Architeuthis-Flux/JumperlessV5/Jumperless23V50/README.md

# Jumperless V5
 The next generation [jumperless breadboard](https://github.com/Architeuthis-Flux/Jumperless)

More LEDs, fewer jumpers!

Here in this folder there *should* be every bit of hardware that goes into this thing. If something's missing, just ask.

Anyway here's a render of each of the parts you'll find in these folders:
hero copy
JumperlessV5r6
Jumperless23V50back

newShell-3
newShell-5
Screenshot 2024-11-18 at 8 08 38 AM
V5LEDboardback

V5LEDboard
V5probe
V5ProbeTop
V5ProbeTopback
gpioAdapter-10
gpioAdapter-12
clickWheelCap-9

Screenshot 2024-11-16 at 7 25 29 PM

ProbeSenseNumbers
ProbeSenseNumbersback

Here's a list of the new stuff being added to V5:
- a separate probe sensing system  (so rows can be selected without disconnecting and scanning the whole board)
- 5 LEDs under each row  (so the breadboard itself can display measurements, text, video, whatever)
- a rotary encoder/button  (so you can navigate menus without looking at a computer)
- 10 GPIO (4 5V, 6 3.3V) that can be routed anywhere  (so you can talk to chips on the breadboard, or logic analyze them)
- a daisy chain header on both sides  (so you can stick a bunch of these together and route 8 fully analog signals between boards)
- a TRRRS audio jack for the probe  (so you can select rows, measure voltage and add an I2C display)
- 2 arbitrarily programmable power rails  (so you can set each one separately to any voltage within +-8V)
- 2 more routable high-current DACs, 3 +- 8V buffered ADCs, a routable op amp buffer (so you're not losing any features of the original Jumperless)
- a USB-C port  (so you can shut the fuck up about my love for USB Mini)

https://github.com/Architeuthis-Flux/JumperlessV5/assets/20519442/e1003ef1-e145-4110-8218-d5403845bdf6

https://github.com/Architeuthis-Flux/JumperlessV5/assets/20519442/8845355e-0e21-4cbd-b4f0-f0b5bd2063a3

https://github.com/Architeuthis-Flux/JumperlessV5/assets/20519442/c6f371e6-8d97-4a70-bf3b-5532be4f0662

https://github.com/Architeuthis-Flux/JumperlessV5/assets/20519442/ceb898b4-bbbe-4788-ab80-29add00364f6

https://github.com/Architeuthis-Flux/JumperlessV5/assets/20519442/f67fb13e-432d-4cfa-b7df-fb754a4e1074

JumperlessV5hw
V5r2Schematic
V5r2LEDsSchematic
