Architeuthis-Flux/JumperlessV5/README1.md

# Jumperless V5
###### The next generation jumperless breadboard

Jumperless V5 is a breaboard where any point can be connected to any other with software-defined jumpers. RGB LEDs under each hole turn the breadboard itself into a display; paired with its assortment of routable analog/digial IO, Jumperless V5 gives you real-time information about everything that's happening in your circuit and the ability to change it at a whim.

JumperlessV5front

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

JumperlessV5back

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

Jumperless V5 will cost roughly $350 (with free shipping worldwide)

## For People Who Like Reading
You're flipping through a comic book and see an ad in the back for some X ray glasses. You put some coins in an envelope and send it off (because it's like 50 years ago in this made up scenario) and get back some spectacles. You immediately look up at the night sky towards the galactic center for Sagittarius A* and don't see a thing; you've been had. You go back to prototyping your new Eurorack module (because that's what I assume everyone was doing in the early 80's) and forget to take them off. 

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

Breadboards should be a playground, and now you can attach a debug probe to them.

https://github.com/Architeuthis-Flux/JumperlessV5/assets/20519442/a3d5ecf4-4665-409d-bab6-2a62fbbe0eb7

Now you have a breadboard with:

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

```
f {ADC1-10, 15-48, TOP_RAIL-17, TOP_RAIL>6.5V, D0-UART_Rx, D1-UART_Tx, }
```
⬆︎ *that's it, that's everything you need to send it to make things happen*

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


###### Just pretend this has an audio cable stuck to the back and it's sitting on a V5

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

lossm-5

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

lossm

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

###### If this campaign does well enough, the next project will be making a general purpose crossbar switch out of beefy MOSFETs and [floating gate](https://en.wikipedia.org/wiki/Floating-gate_MOSFET) drivers to get the voltage limits into the ±50V range and the Ron down to ~1Ω, but custom high-current silicon is a huge, expensive undertaking (that I am 100% committed to doing)

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

JumperlessV5boardoff

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

## Open Sourciness
This thing infinitely open source and hackable. I'm kind of a zealot about that stuff. Want to make 10 of these with a USB Mini port for you and your friends? Let me know and I'll double check everything when you're putting in the PCB order to make sure all the parts are placed correctly and stuff (and I'd totally buy one, I love USB Mini). I'll even send you the custom spring clips.

If you have some feature you want to add, I'm happy to help. Either by just adding it myself or walking you through the relevant bits of code to make it happen.
JumperlessV5hw
