Architeuthis-Flux/JumperlessV5/Jumperless23V50/Board Shell/newShell-1.jpg

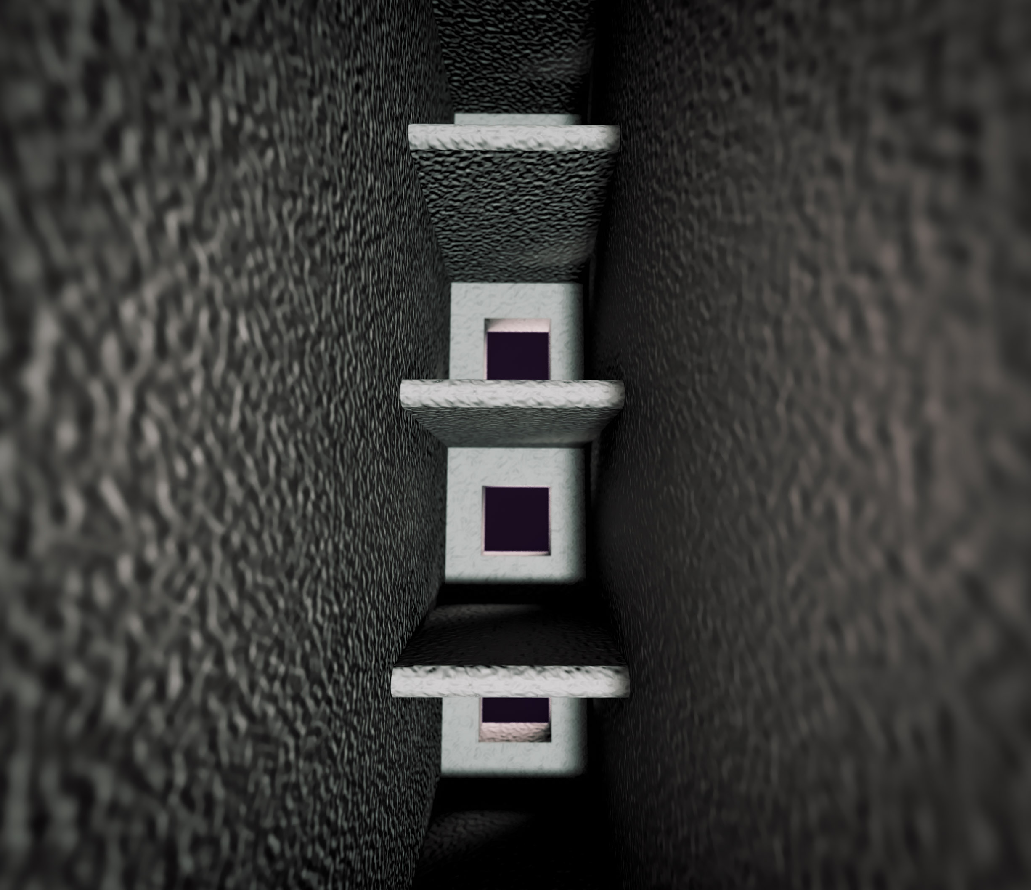
Jumperless23V50/Board Shell/newShell-1.jpg
