Architeuthis-Flux/JumperlessV5/Jumperless23V50/Board Shell/newShell-5.jpg

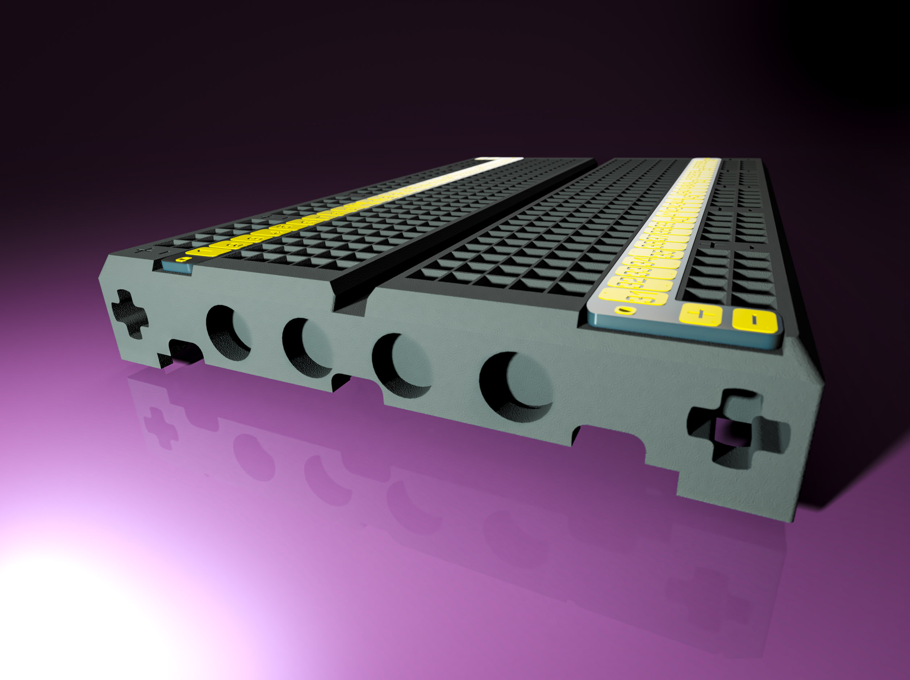
Jumperless23V50/Board Shell/newShell-5.jpg
