Architeuthis-Flux/JumperlessV5/Jumperless23V50/Clickwheel Cap/clickWheelCap-0.jpg

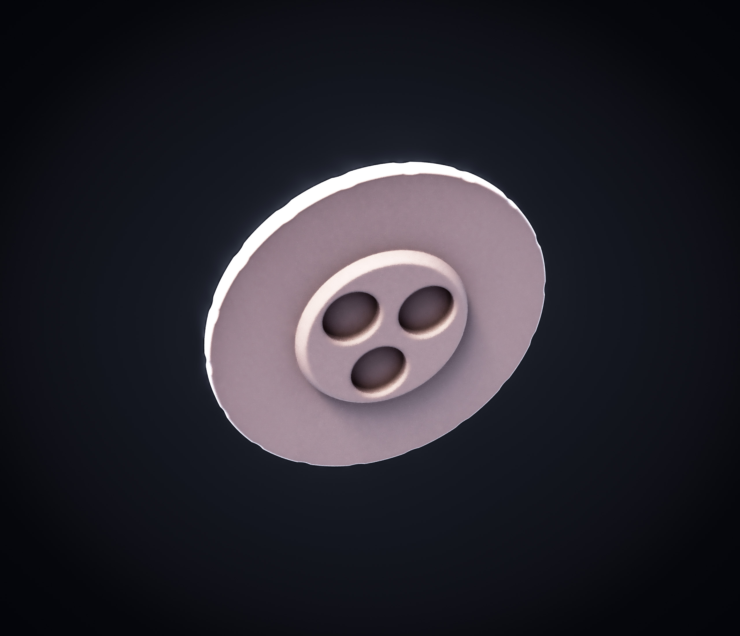
Jumperless23V50/Clickwheel Cap/clickWheelCap-0.jpg
