Architeuthis-Flux/JumperlessV5/Jumperless23V50/Clickwheel Cap/clickWheelCap-6.jpg

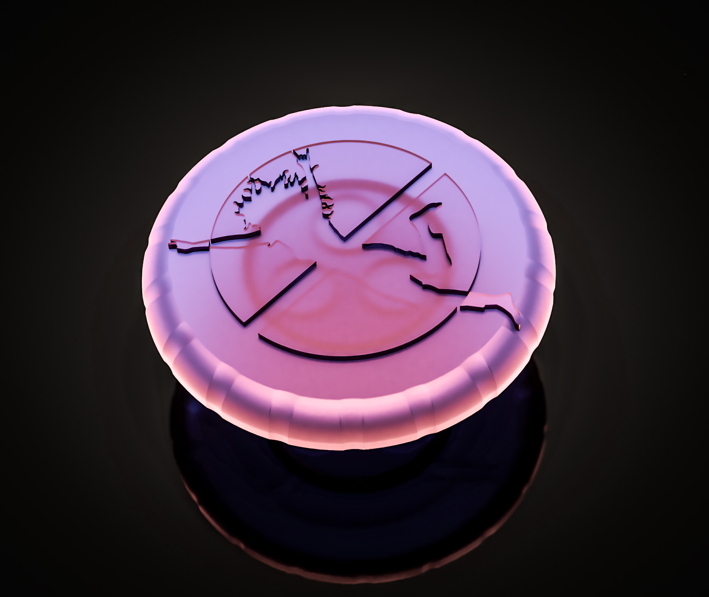
Jumperless23V50/Clickwheel Cap/clickWheelCap-6.jpg
