Architeuthis-Flux/JumperlessV5/Jumperless23V50/Clickwheel Cap/WJPlickwheelCaps-14.jpg

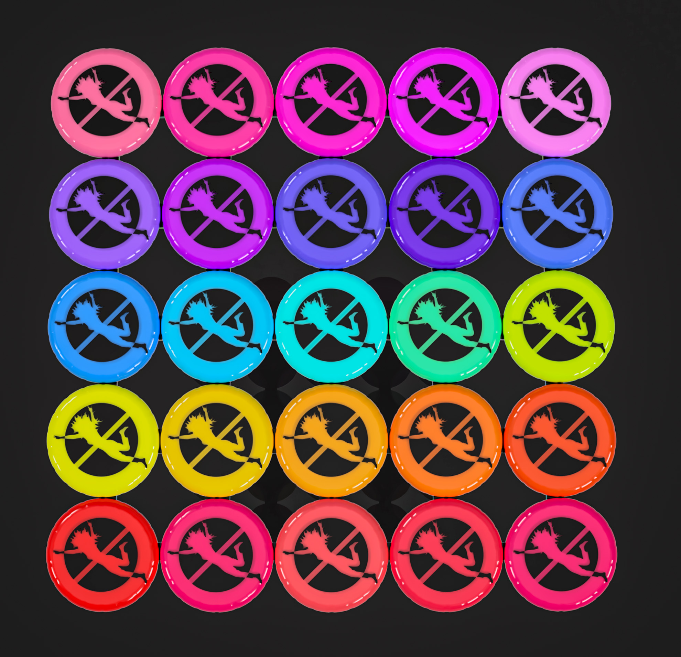
Jumperless23V50/Clickwheel Cap/WJPlickwheelCaps-14.jpg
