Architeuthis-Flux/JumperlessV5/Jumperless23V50/Clickwheel Cap/WJPlickwheelCaps-17.jpg

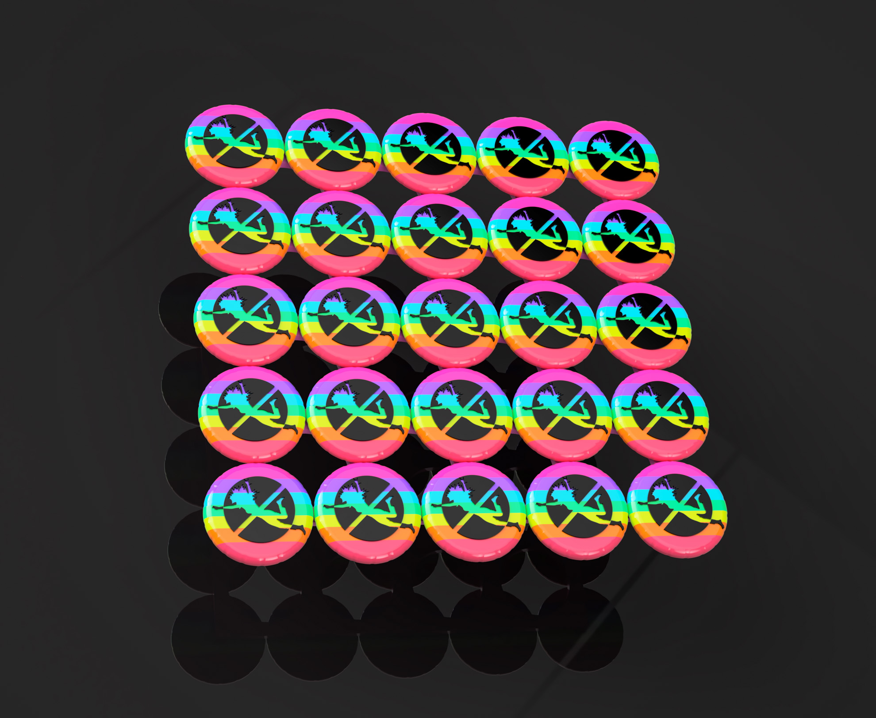
Jumperless23V50/Clickwheel Cap/WJPlickwheelCaps-17.jpg
