Architeuthis-Flux/JumperlessV5/Jumperless23V50/Images/Breadboard Shell/BreadboardShellRender1.png

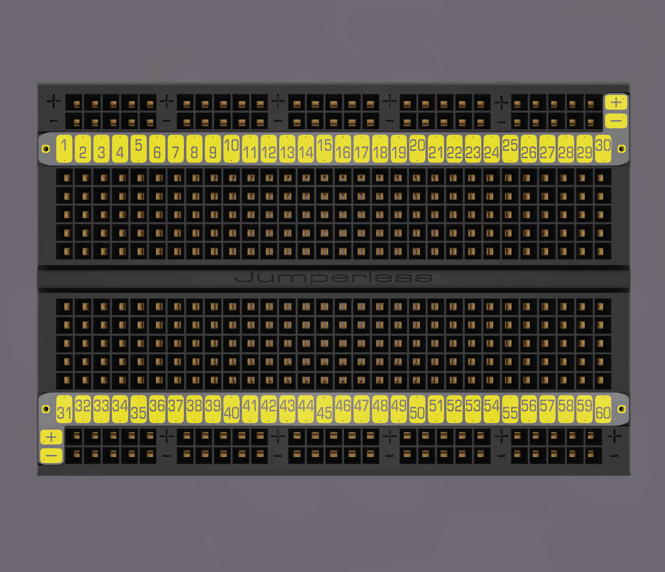
Jumperless23V50/Images/Breadboard Shell/BreadboardShellRender1.png
