Architeuthis-Flux/JumperlessV5/Jumperless23V50/Images/Breadboard Shell/BreadboardShellRender2.png

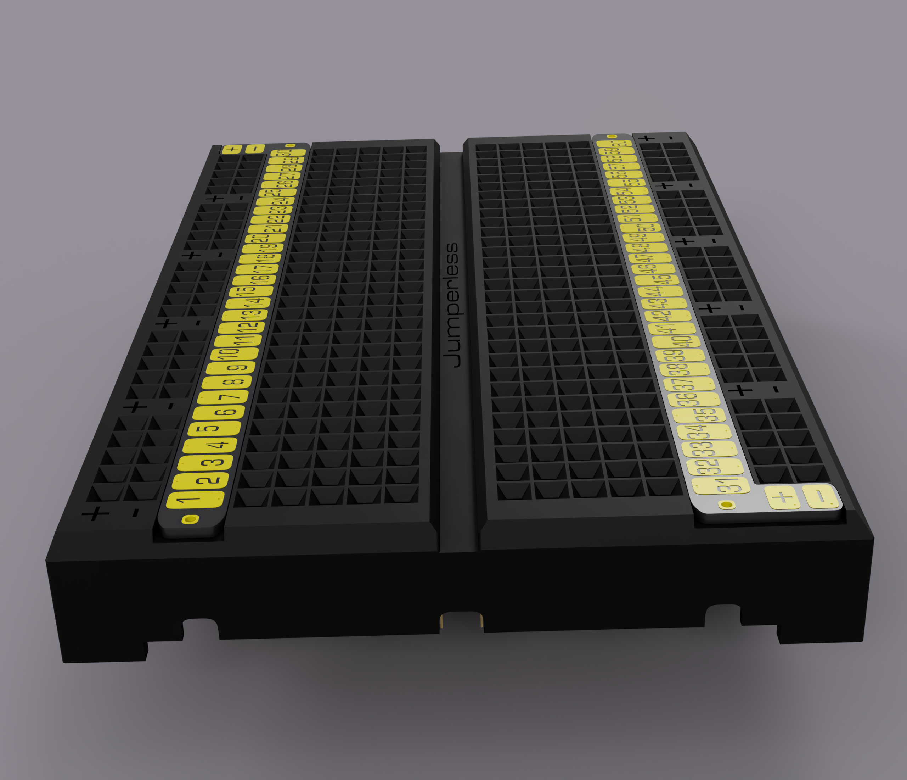
Jumperless23V50/Images/Breadboard Shell/BreadboardShellRender2.png
