Architeuthis-Flux/JumperlessV5/Jumperless23V50/Images/Breadboard Shell/BreadboardShellRender3.png

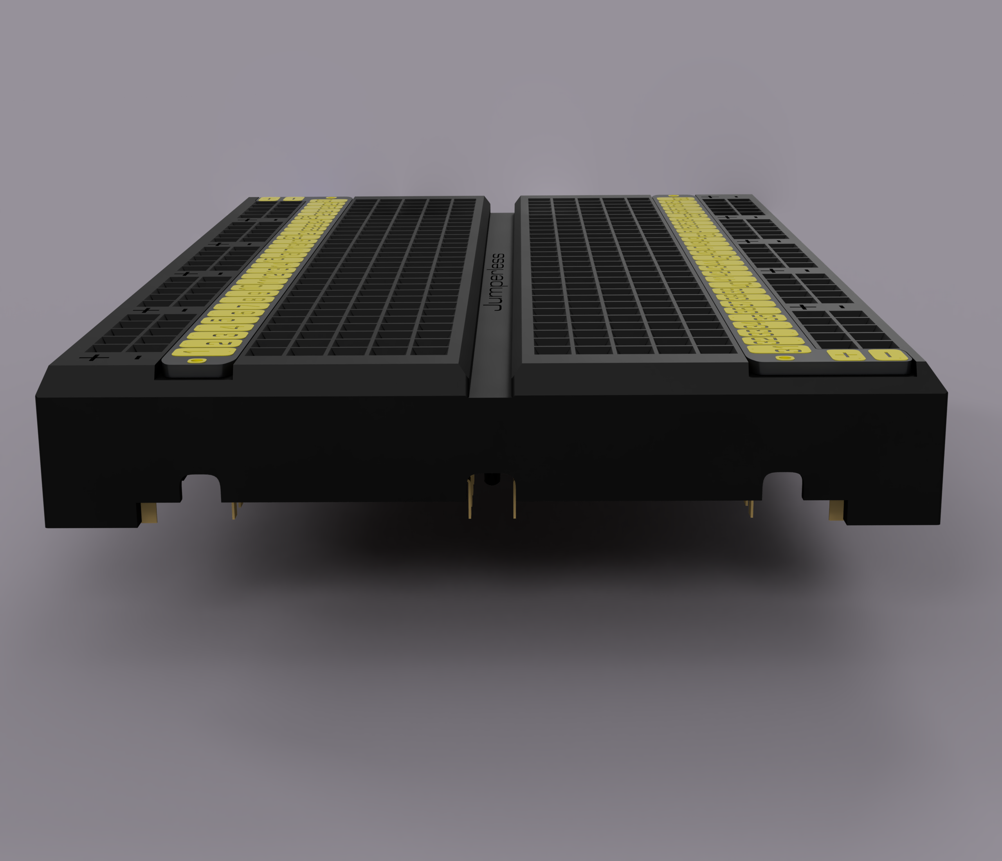
Jumperless23V50/Images/Breadboard Shell/BreadboardShellRender3.png
