Architeuthis-Flux/JumperlessV5/Jumperless23V50/Images/Breadboard Shell/BreadboardShellRender5.png

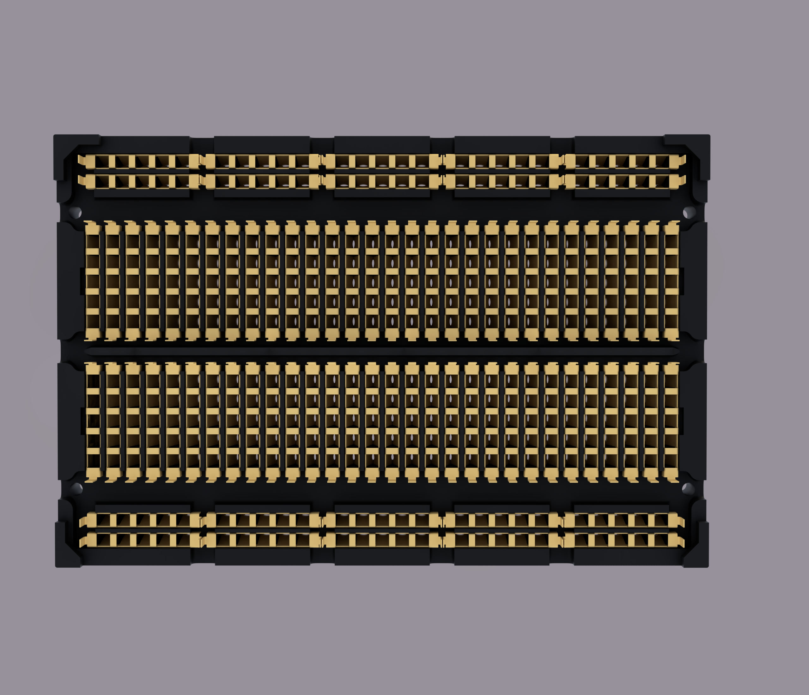
Jumperless23V50/Images/Breadboard Shell/BreadboardShellRender5.png
