Architeuthis-Flux/JumperlessV5/Jumperless23V50/Images/Breadboard Shell/BreadboardShellRender8.png

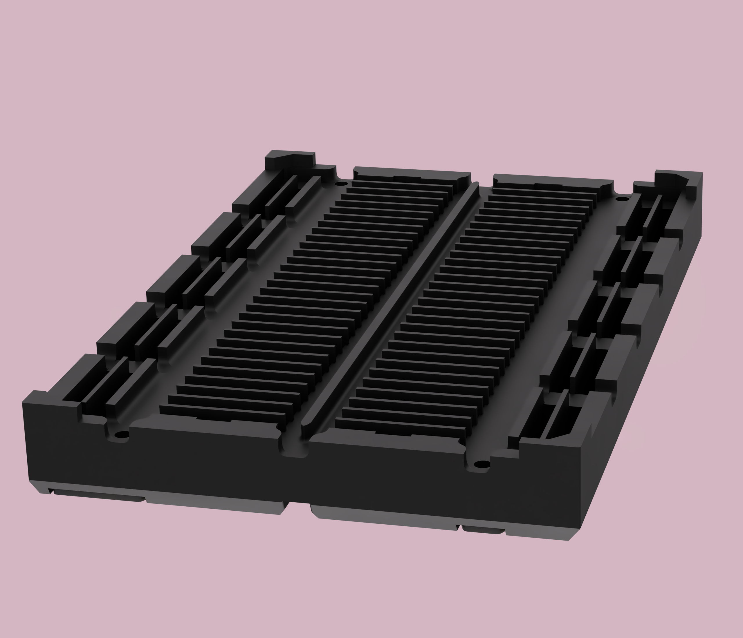
Jumperless23V50/Images/Breadboard Shell/BreadboardShellRender8.png
