Architeuthis-Flux/JumperlessV5/Jumperless23V50/Images/JumperlessV5hw.png

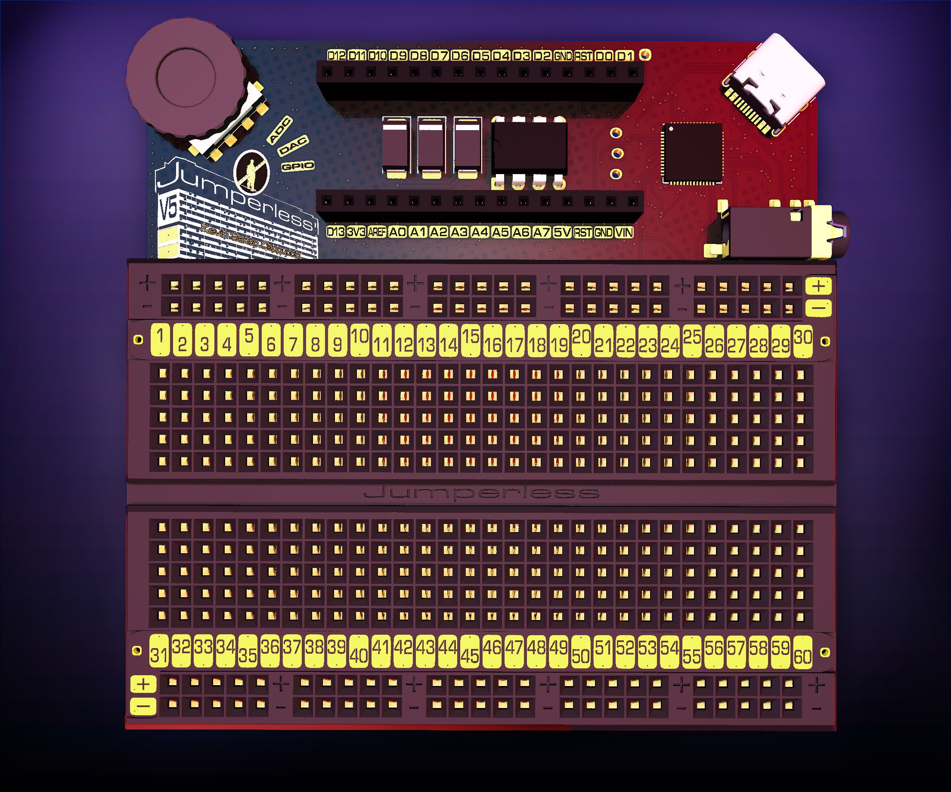
Jumperless23V50/Images/JumperlessV5hw.png
