Architeuthis-Flux/JumperlessV5/Jumperless23V50/Images/Probe Sense Numbers/ProbeSenseNumberBack.png

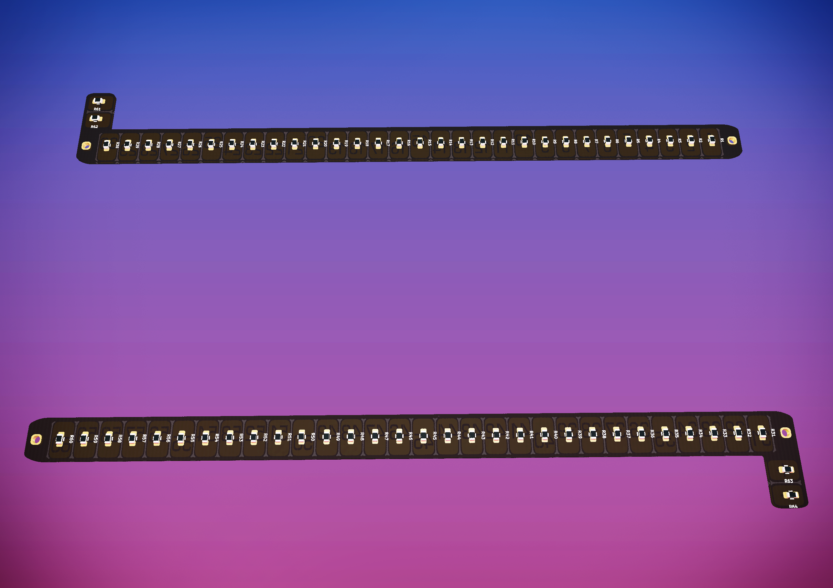
Jumperless23V50/Images/Probe Sense Numbers/ProbeSenseNumberBack.png
