Architeuthis-Flux/JumperlessV5/Jumperless23V50/Images/Probe Sense Numbers/ProbeSenseNumberBackedge.png

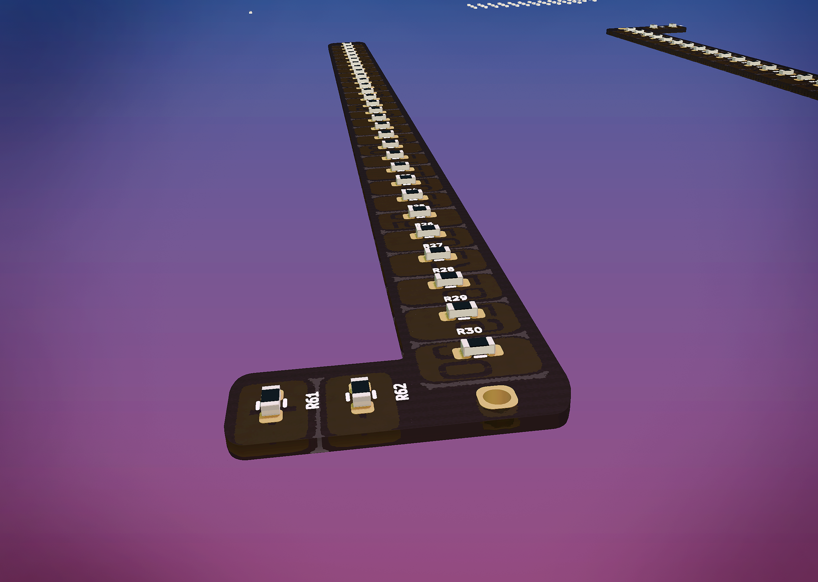
Jumperless23V50/Images/Probe Sense Numbers/ProbeSenseNumberBackedge.png
