Architeuthis-Flux/JumperlessV5/Jumperless23V50/Images/Probe Sense Numbers/ProbeSenseNumbers.png

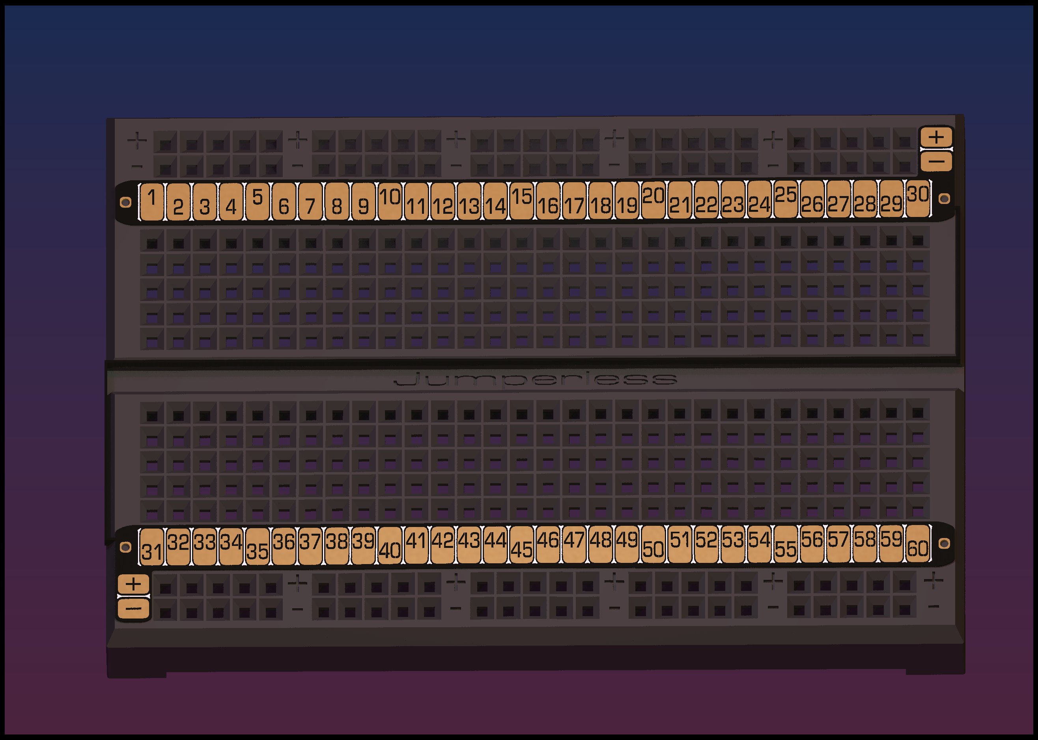
Jumperless23V50/Images/Probe Sense Numbers/ProbeSenseNumbers.png
