Architeuthis-Flux/JumperlessV5/Jumperless23V50/Images/Probe Sense Numbers/ProbeSenseNumbersEnds.png

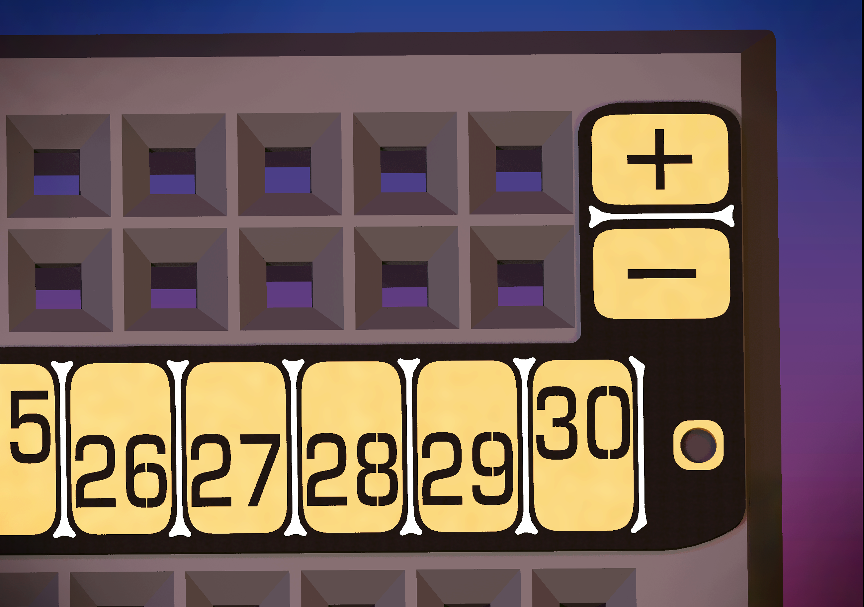
Jumperless23V50/Images/Probe Sense Numbers/ProbeSenseNumbersEnds.png
