Architeuthis-Flux/JumperlessV5/Jumperless23V50/Images/Probe Sense Numbers/ProbeSenseNumberspers.png

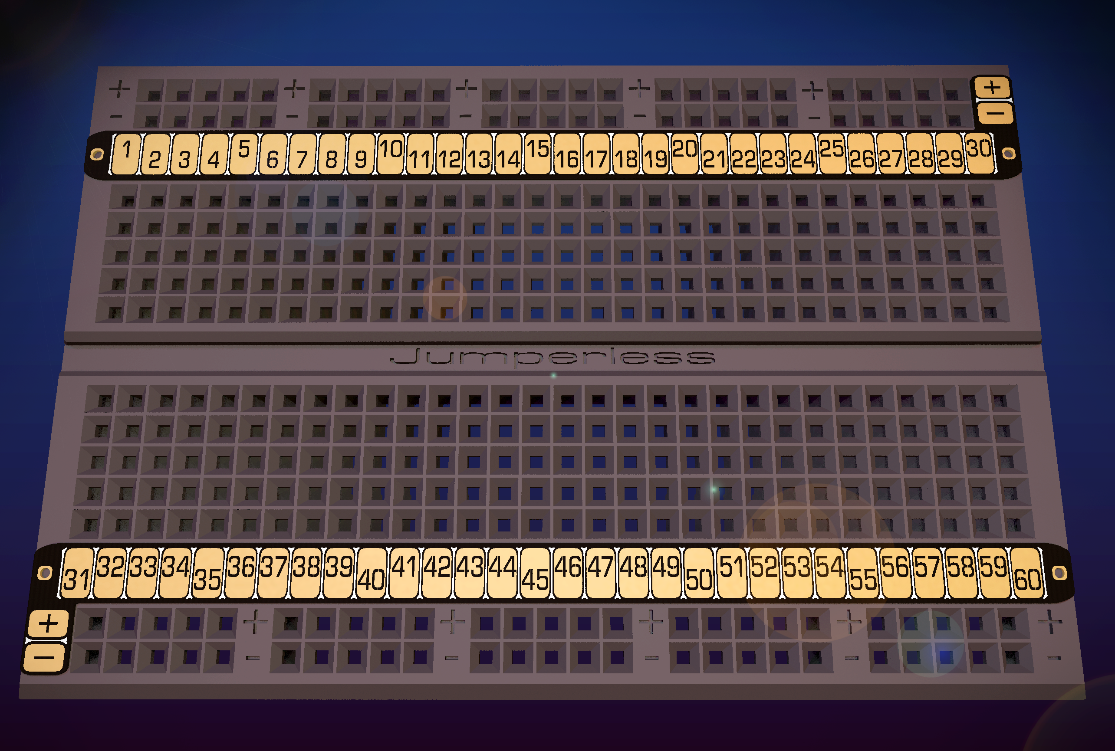
Jumperless23V50/Images/Probe Sense Numbers/ProbeSenseNumberspers.png
