Architeuthis-Flux/JumperlessV5/Jumperless23V50/Packaging/All.jpg

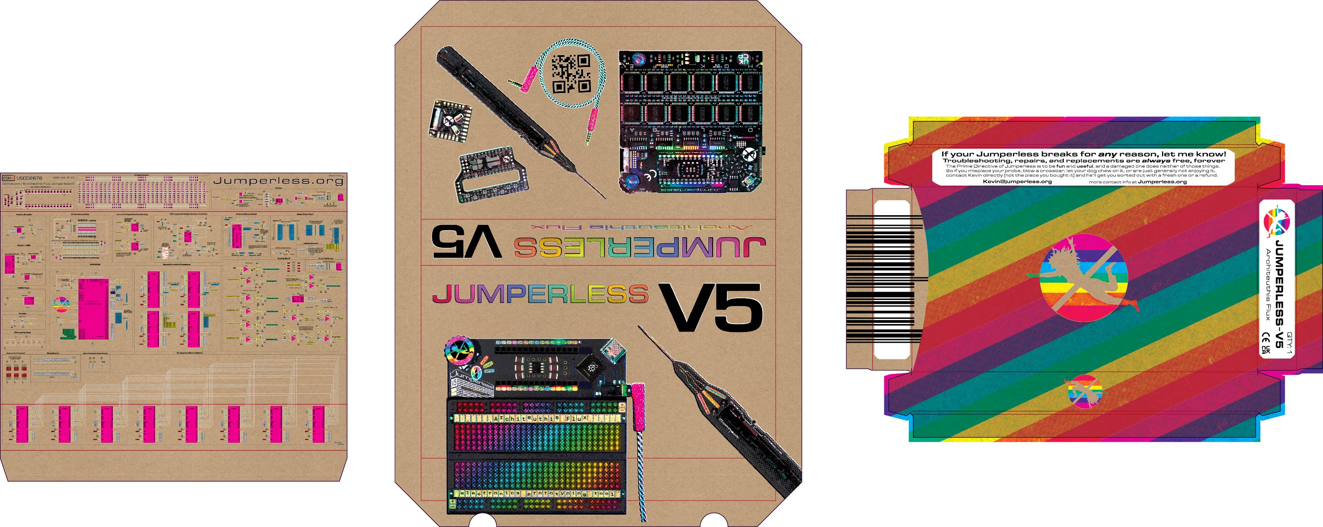
Jumperless23V50/Packaging/All.jpg
