Architeuthis-Flux/JumperlessV5/Jumperless23V50/Packaging/FrontBack.jpg

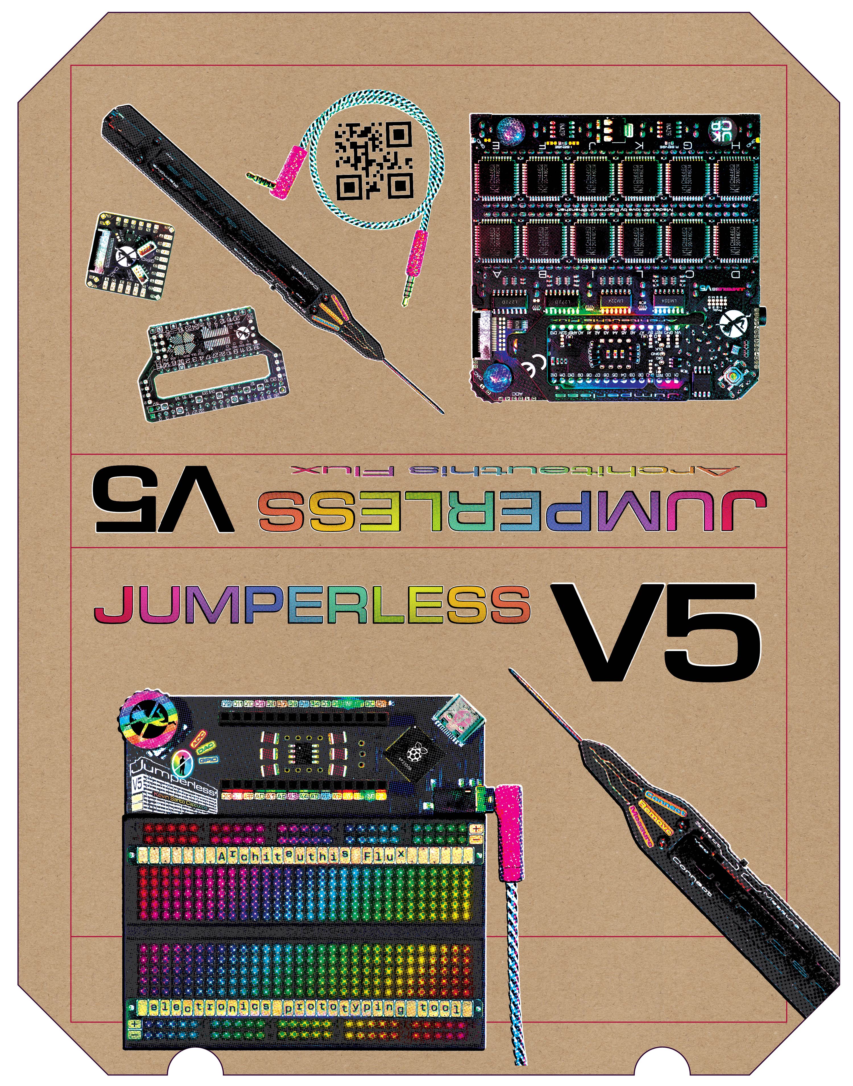
Jumperless23V50/Packaging/FrontBack.jpg
