Architeuthis-Flux/JumperlessV5/Jumperless23V50/Packaging/InsideFlap.jpg

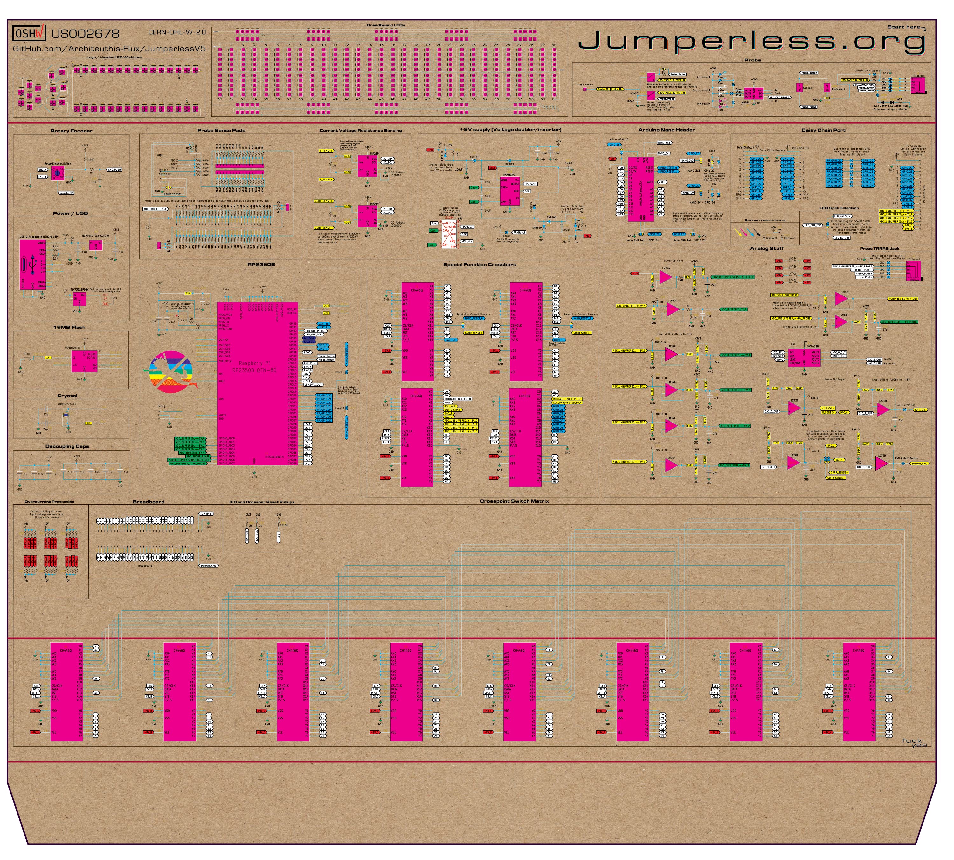
Jumperless23V50/Packaging/InsideFlap.jpg
