Architeuthis-Flux/JumperlessV5/Jumperless23V50/Packaging/Sides.jpg

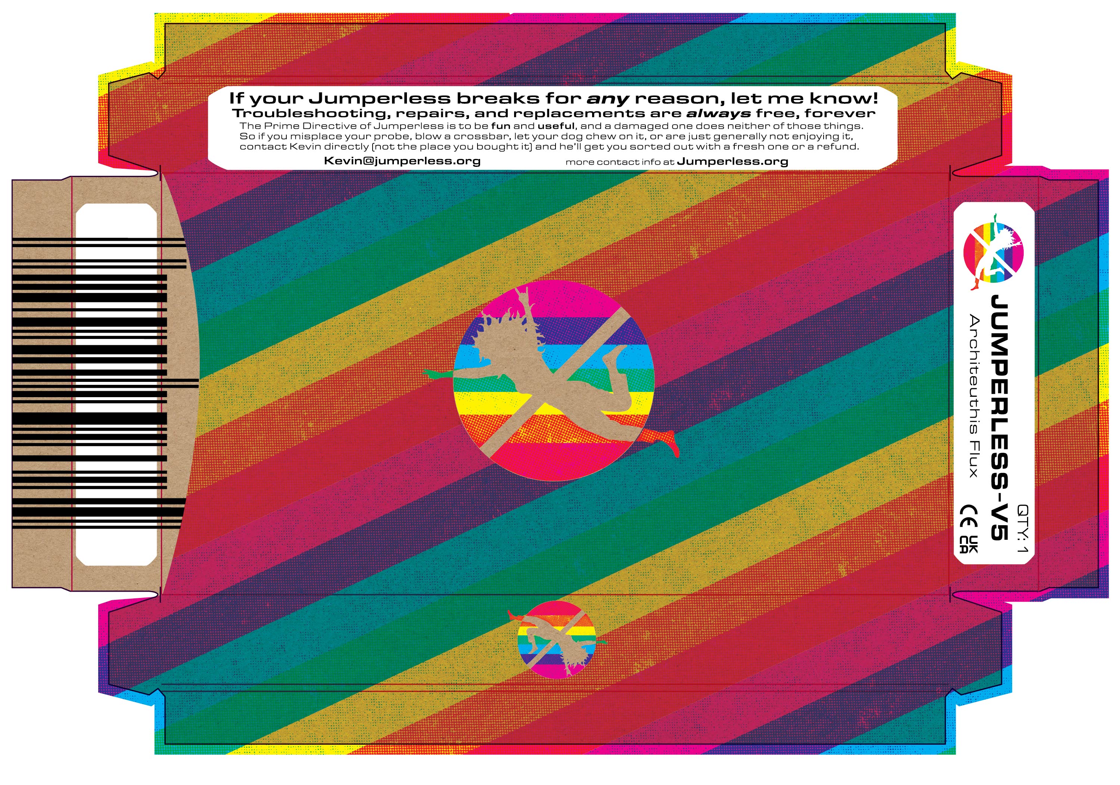
Jumperless23V50/Packaging/Sides.jpg
