Architeuthis-Flux/JumperlessV5/Jumperless23V50/PRSRAMmodOneSided/PRSRAMmodOneSided.png

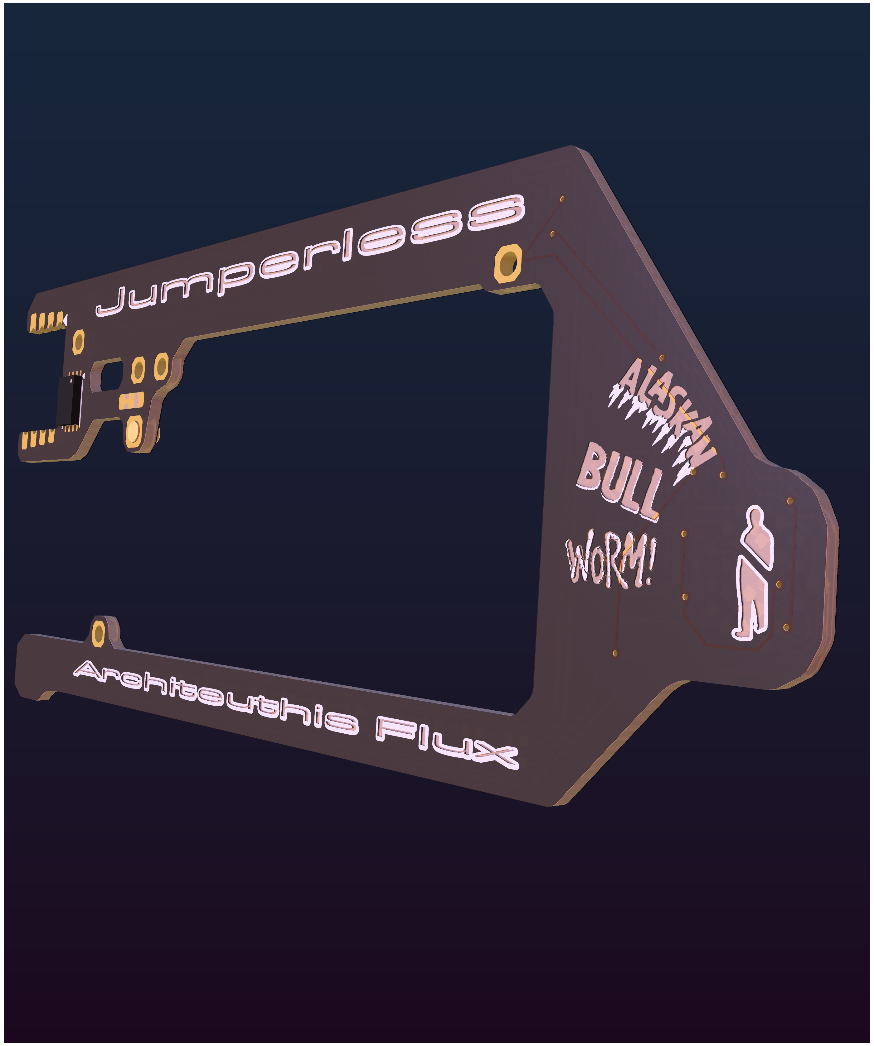
Jumperless23V50/PRSRAMmodOneSided/PRSRAMmodOneSided.png
