Architeuthis-Flux/JumperlessV5/Jumperless23V50/Stands/Acrylic/Renders/AcrylicStand-09.jpg

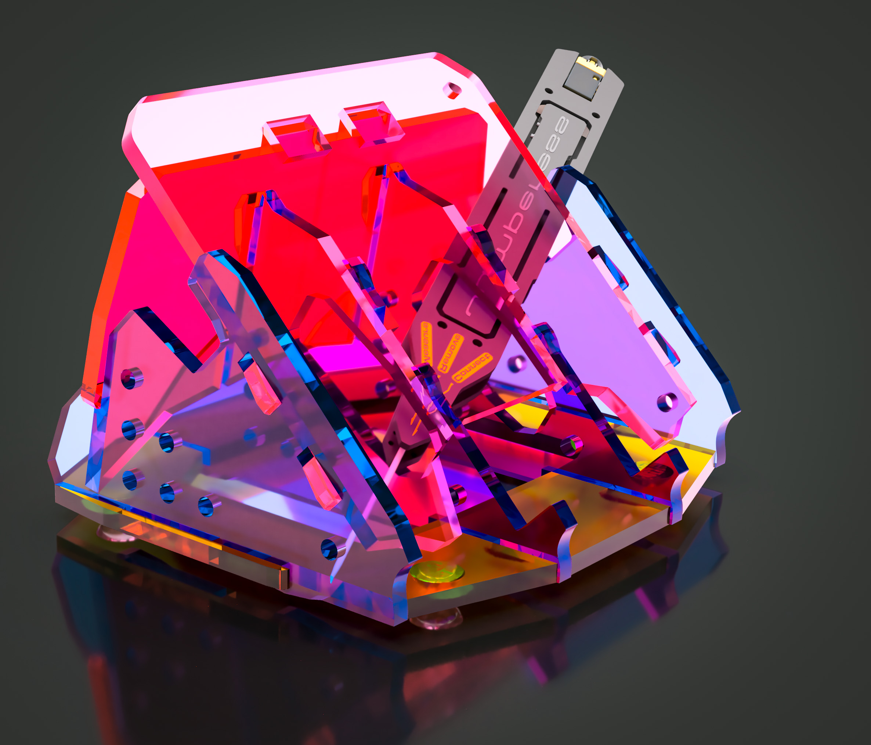
Jumperless23V50/Stands/Acrylic/Renders/AcrylicStand-09.jpg
