Architeuthis-Flux/JumperlessV5/Jumperless23V50/Stands/Acrylic/Renders/AcrylicStand-12.jpg

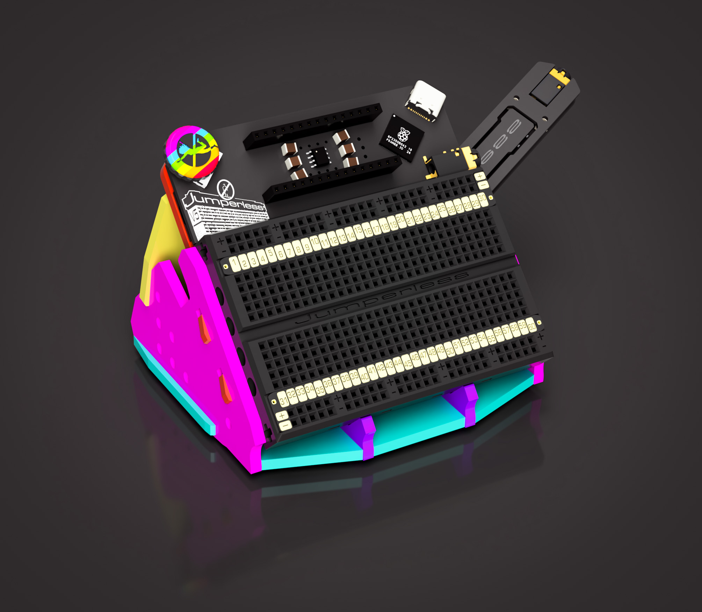
Jumperless23V50/Stands/Acrylic/Renders/AcrylicStand-12.jpg
