Architeuthis-Flux/JumperlessV5/Jumperless23V50/3Dmodels/Breadboard V5 v21.stl

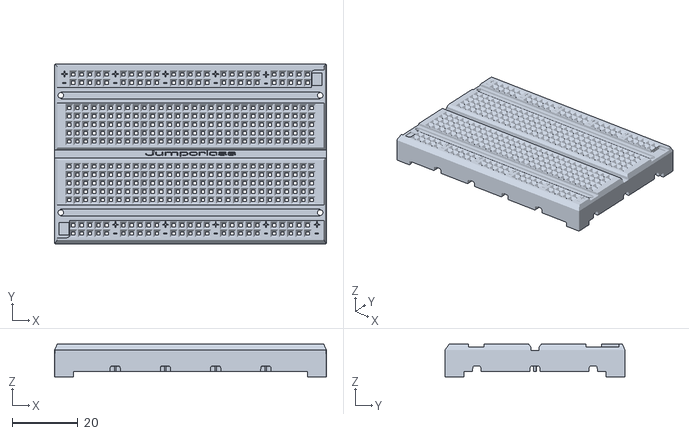
[picture p50: CAD file, 2024-05-20]
Jumperless23V50/3Dmodels/Breadboard V5 v21.stl
82.5 x 54.6 x 9.98
