Architeuthis-Flux/JumperlessV5/Jumperless23V50/Clickwheel Cap/ClickwheelCap3MF/ClickwheelcapRainbowSingle.3mf

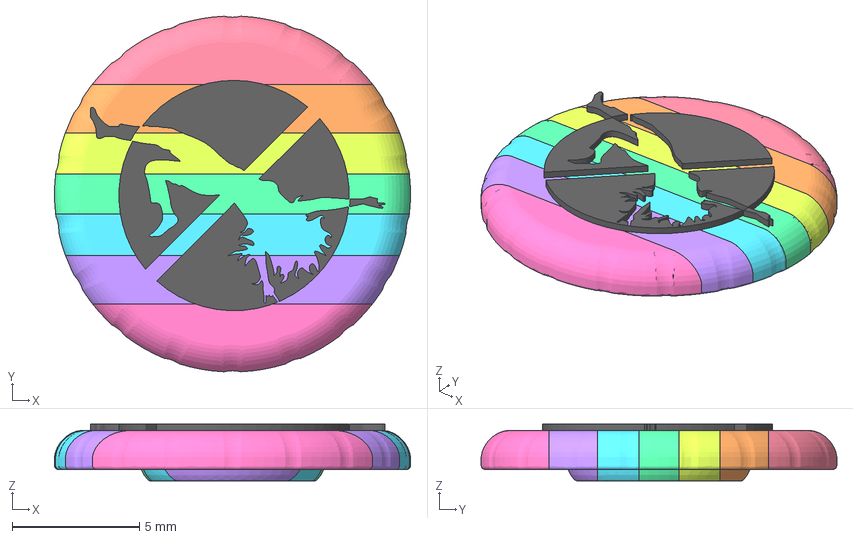
[picture p51: CAD file, 2024-12-02]
Jumperless23V50/Clickwheel Cap/ClickwheelCap3MF/ClickwheelcapRainbowSingle.3mf
14.0 x 14.0 x 2.24 mm
