Architeuthis-Flux/JumperlessV5/Jumperless23V50/Probe/V5probe/Symbols and Footprints/3dmodels/WS2812C-2020_Color.step

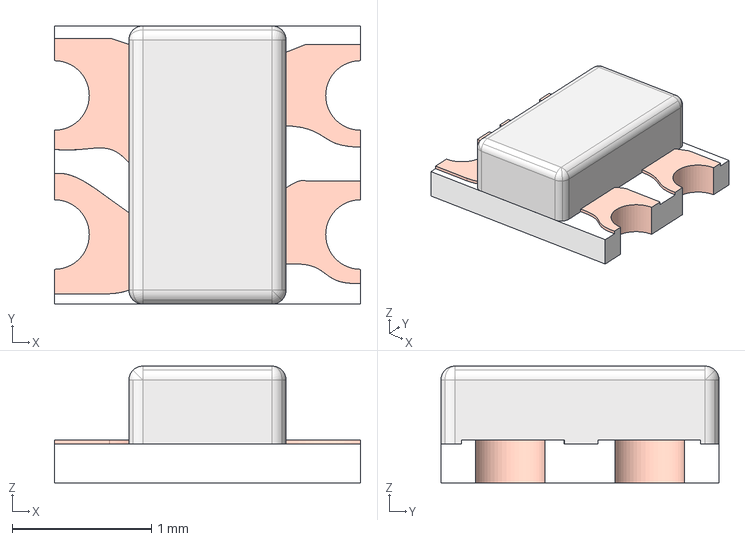
[picture p52: CAD file, 2025-02-01]
Jumperless23V50/Probe/V5probe/Symbols and Footprints/3dmodels/WS2812C-2020_Color.step
2.20 x 2.00 x 0.84 mm
ws2812c-2020 v2.step
ws2812c-2020 v2
