Architeuthis-Flux/JumperlessV5/Jumperless23V50/ProbeSenseNumbers/ProbeSenseNumbers1_union.FCStd

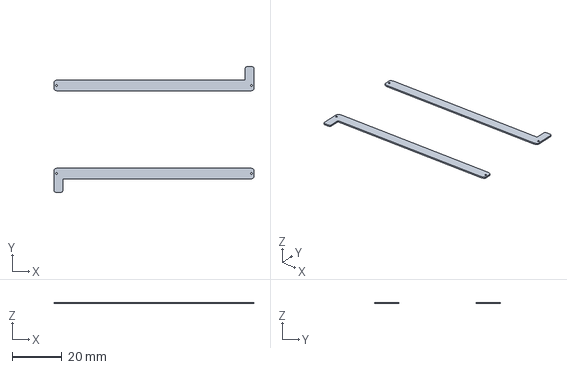
[picture p53: CAD file, 2024-05-20]
Jumperless23V50/ProbeSenseNumbers/ProbeSenseNumbers1_union.FCStd
80.8 x 50.8 x 0.6 mm
