Architeuthis-Flux/JumperlessV5/Jumperless23V50/Spring Clips/SpringClips5holes.step

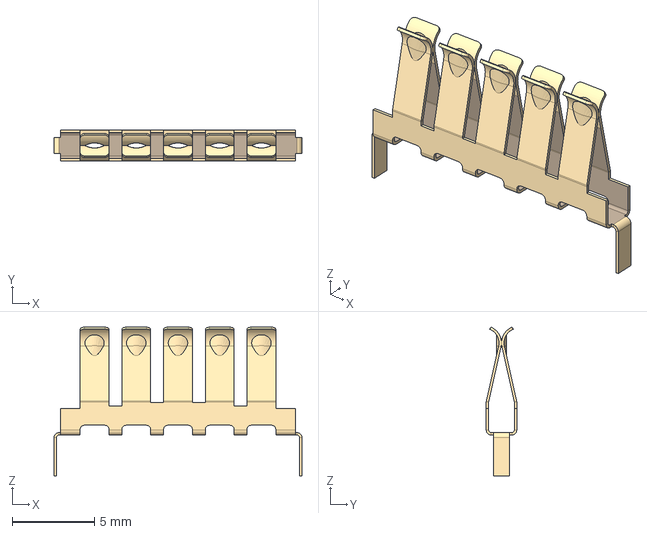
[picture p54: CAD file, 2024-07-09]
Jumperless23V50/Spring Clips/SpringClips5holes.step
15.1 x 1.86 x 9.05 mm
