Architeuthis-Flux/JumperlessV5/Jumperless23V50/Stands/Acrylic/AcrylicStandPart3.dxf

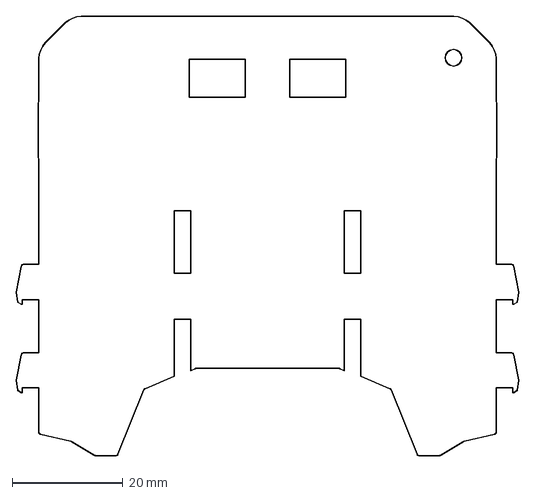
[picture p56: CAD file, 2025-03-29]
Jumperless23V50/Stands/Acrylic/AcrylicStandPart3.dxf
90.9 x 79.5 mm
