Architeuthis-Flux/JumperlessV5/Jumperless23V50/Probe/V5probe/Symbols and Footprints/3dmodels/PEC11R-4215F-S0024--3DModel-STEP-56544.STEP

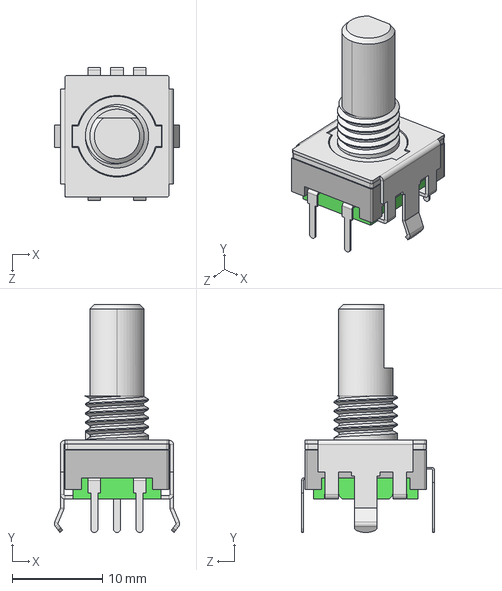
[picture p58: CAD file, 2025-02-01]
Jumperless23V50/Probe/V5probe/Symbols and Footprints/3dmodels/PEC11R-4215F-S0024--3DModel-STEP-56544.STEP
13.9 x 25.2 x 14.7 mm
