Architeuthis-Flux/JumperlessV5/Jumperless23V50/ProbeSenseNumbers/ProbeSenseNumbers.step

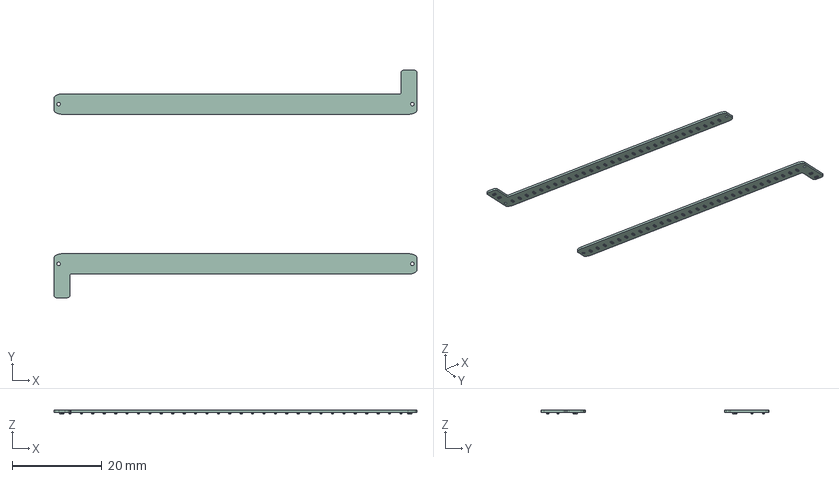
[picture p59: CAD file, 2024-05-20]
Jumperless23V50/ProbeSenseNumbers/ProbeSenseNumbers.step
80.8 x 50.8 x 1.00 mm
R_0402_1005Metric x 64
ProbeSenseNumbers_PCB_1
ProbeSenseNumbers_PCB_2
