Architeuthis-Flux/JumperlessV5/Jumperless23V50/Stands/3D Printed/JumperlessStand.step

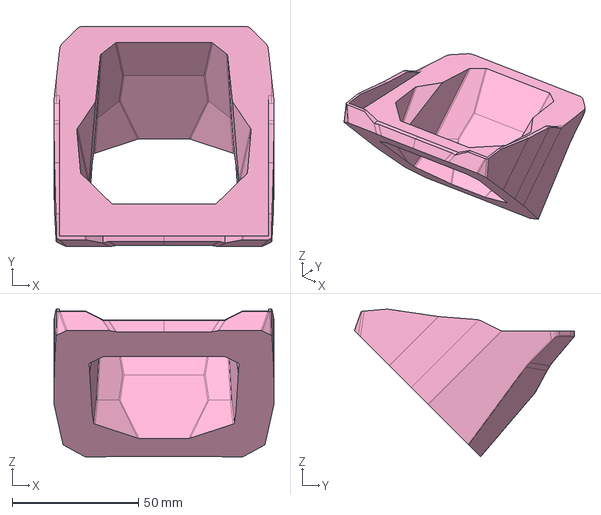
[picture p60: CAD file, 2025-08-26]
Jumperless23V50/Stands/3D Printed/JumperlessStand.step
87.0 x 87.2 x 58.5 mm
