Architeuthis-Flux/JumperlessV5/Jumperless23V50/Stands/Acrylic/JumperlessAcrylicStand v31.step

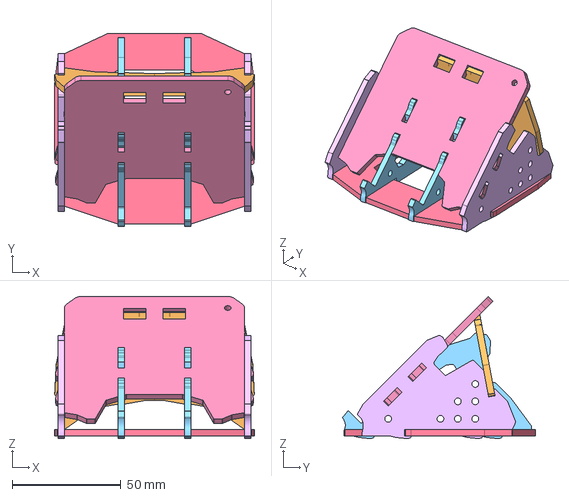
[picture p61: CAD file, 2025-03-29]
Jumperless23V50/Stands/Acrylic/JumperlessAcrylicStand v31.step
91.9 x 88.5 x 65.3 mm
