Architeuthis-Flux/JumperlessV5/Jumperless23V50/Probe/V5probe/Symbols and Footprints/3dmodels/Snap-Action Switch with 16.3mm Roller Lever 3-Pin, SPDT, 5A v5.iges

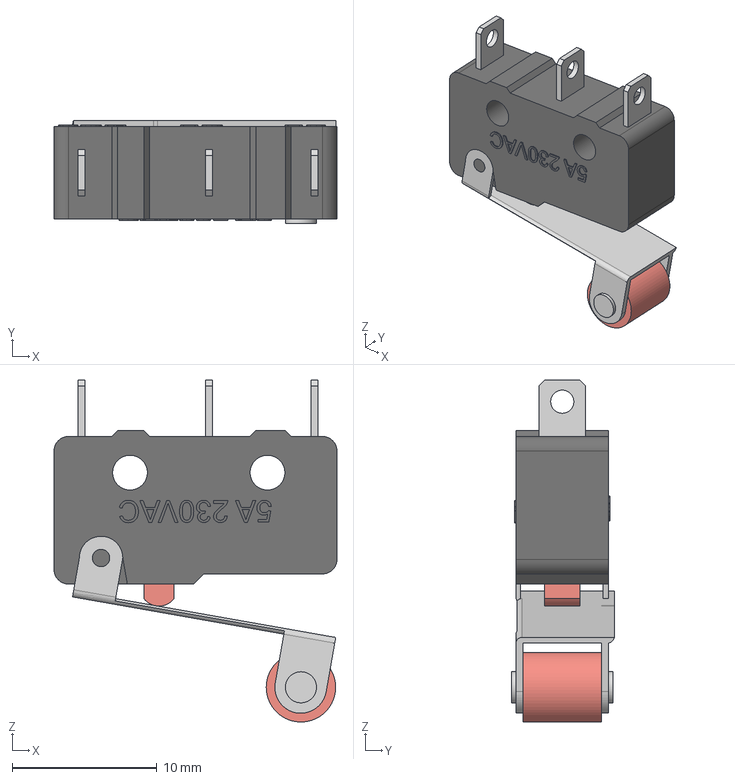
[picture p62: CAD file, 2025-02-01]
Jumperless23V50/Probe/V5probe/Symbols and Footprints/3dmodels/Snap-Action Switch with 16.3mm Roller Lever 3-Pin, SPDT, 5A v5.iges
19.6 x 7.10 x 23.6 mm
