Architeuthis-Flux/JumperlessV5/Jumperless23V50/Stands/Acrylic/AcrylicStandPart5.dxf

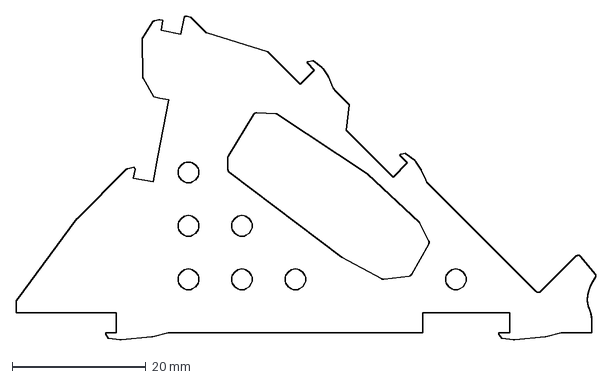
[picture p63: CAD file, 2025-03-29]
Jumperless23V50/Stands/Acrylic/AcrylicStandPart5.dxf
86.7 x 48.4 mm
