Architeuthis-Flux/JumperlessV5/Jumperless23V50/Probe/V5probe/Symbols and Footprints/3dmodels/DSA_Keycap_CherryMX.step

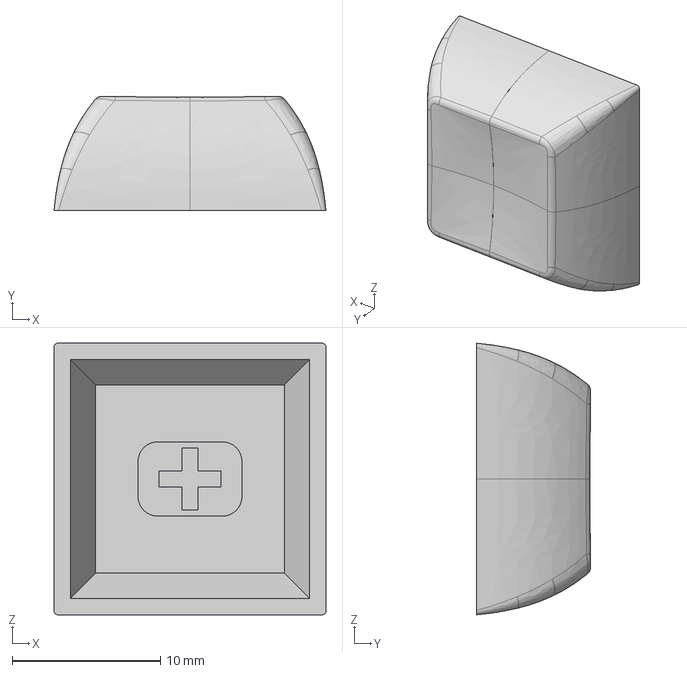
[picture p64: CAD file, 2025-02-01]
Jumperless23V50/Probe/V5probe/Symbols and Footprints/3dmodels/DSA_Keycap_CherryMX.step
18.3 x 7.69 x 18.3 mm
