Architeuthis-Flux/JumperlessV5/Jumperless23V50/Stands/Acrylic/AcrylicStandPart2.dxf

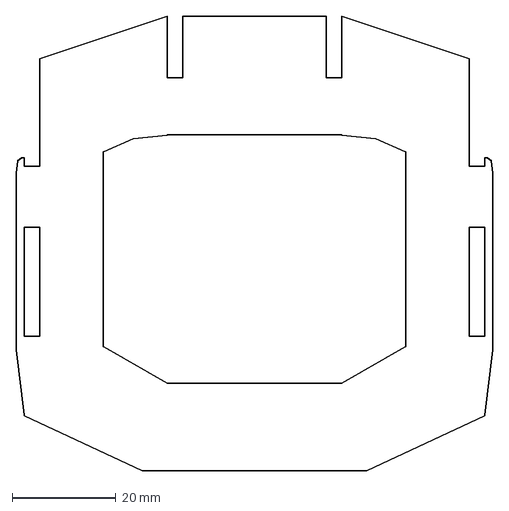
[picture p65: CAD file, 2025-03-29]
Jumperless23V50/Stands/Acrylic/AcrylicStandPart2.dxf
91.9 x 87.5 mm
