Architeuthis-Flux/JumperlessV5/Jumperless23V50/Probe/V5probe/Symbols and Footprints/3dmodels/Cherry MX.STEP

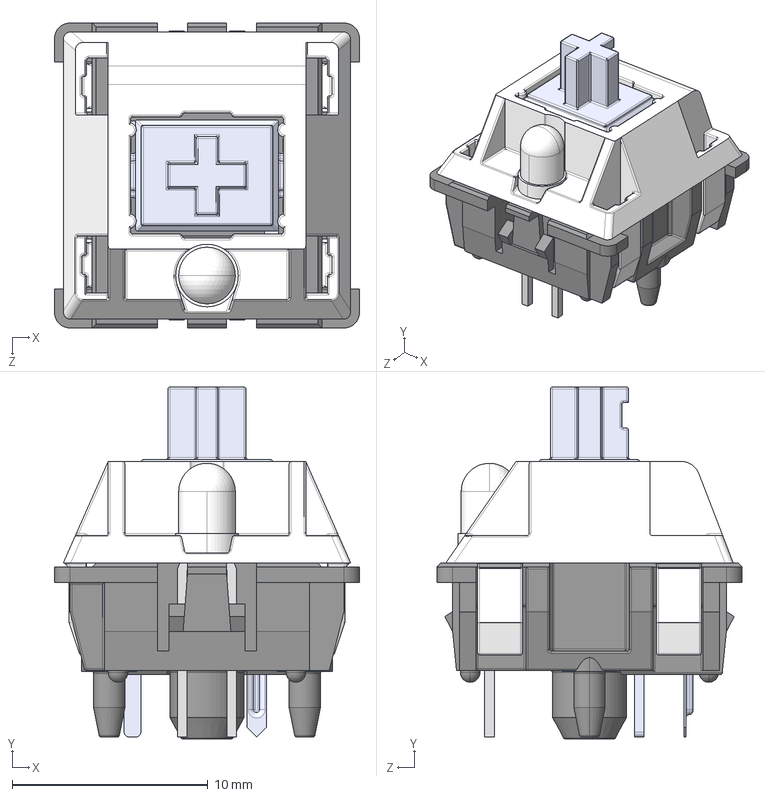
[picture p66: CAD file, 2025-02-01]
Jumperless23V50/Probe/V5probe/Symbols and Footprints/3dmodels/Cherry MX.STEP
15.6 x 18.0 x 15.6 mm
Bottom
Pulsador
Top
Pieza5^Cherry MX
Pin1
Pin2
Led 3mm_trans
