Architeuthis-Flux/JumperlessV5/Jumperless23V50/Stands/Acrylic/AcrylicStandPart4.dxf

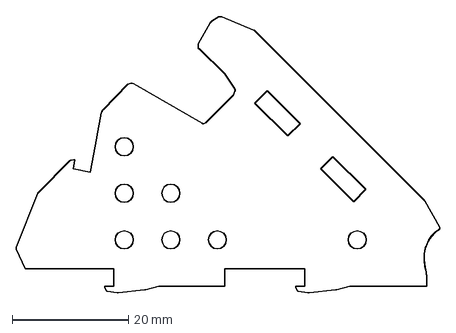
[picture p67: CAD file, 2025-03-29]
Jumperless23V50/Stands/Acrylic/AcrylicStandPart4.dxf
72.8 x 47.4 mm
