Architeuthis-Flux/JumperlessV5/Jumperless23V50/Stands/Acrylic/AcrylicStandPart1.dxf

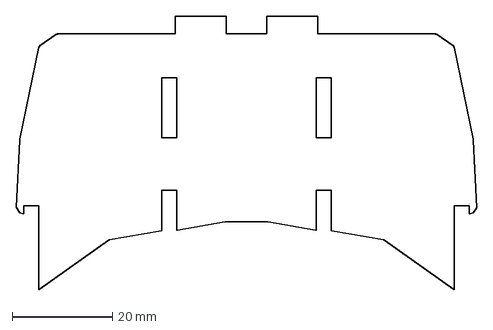
[picture p68: CAD file, 2025-03-29]
Jumperless23V50/Stands/Acrylic/AcrylicStandPart1.dxf
91.7 x 54.6 mm
