Architeuthis-Flux/JumperlessV5/Jumperless23V50/Probe/V5probe/Symbols and Footprints/3dmodels/bbSimple v8.step

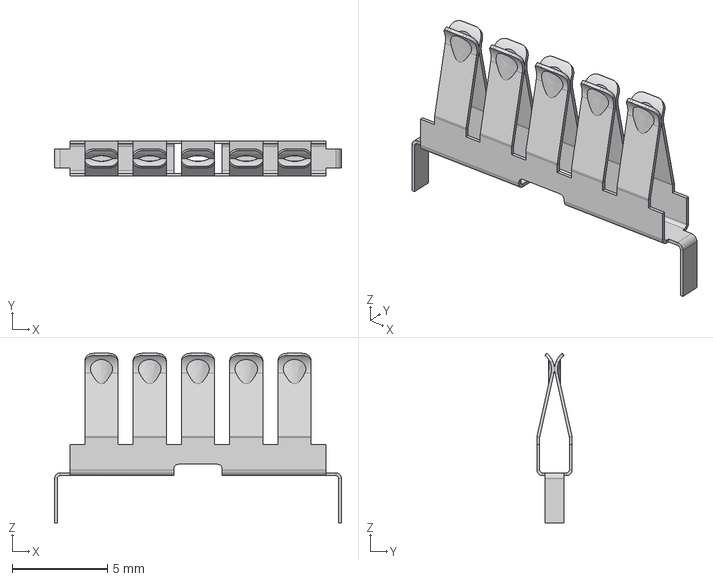
[picture p69: CAD file, 2025-02-01]
Jumperless23V50/Probe/V5probe/Symbols and Footprints/3dmodels/bbSimple v8.step
15.1 x 1.86 x 8.92 mm
