Architeuthis-Flux/JumperlessV5/(list of files, cad)

Other CAD files:
Jumperless23V50/Board Shell/Original Shell/Breadboard V5 v25.3mf
Jumperless23V50/Board Shell/Original Shell/Breadboard V5 v25.stl
Jumperless23V50/Probe/V5probe/Symbols and Footprints/3dmodels/bbSimple v1.step
Jumperless23V50/Spring Clips/SpringClips5holes.3mf
Jumperless23V50/Spring Clips/SpringClips5holes.stl
Jumperless23V50/Stands/3D Printed/JumperlessStand.3mf
Jumperless23V50/Stands/3D Printed/JumperlessStand.stl
Jumperless23V50/Stands/3D Printed/standwithprobeholder.3mf
Jumperless23V50/Stands/3D Printed/standwithprobeholder.stl
Jumperless23V50/Stands/Acrylic/JumperlessAcrylicStand v31.stl
