Architeuthis-Flux/JumperlessV5/RP23V50firmware/GettingStarted.md

### The *absolute* latest release will always be in the pinned messages in the [V5-beta-testers channel on Discord](https://discord.gg/Zvv7Dvgxa5)

# Here's a super-quick rundown of the how to use the thing:

## The Probe
First, keep the switch on the probe set to `Select`
ProbeSelect
(Measure mode allows the probe tip to be ±9V tolerant and routable like any other node, but as of yet, the code to actually do anything with it is unwritten so it just connects to DAC 0 and outputs 3.3V just like it was in Select mode.)

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

Now any pair of nodes you tap should get connected as you make them. To connect to special functions, tap the corresponding pad near the logo, it will show you a menu on the breadboard to choose them.

To get out of `Connect` mode, press the button again.

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

Now you can swipe along the pads or tap them one at a time. Remember it only disconnects that `node` and anything connected to it directly, not *everything* on the `net`. So tapping say, `row 25` that's connected to `GND` won't clear everything connected to `GND`, but tapping the `-` on the rails (for `GND`) would.

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

# The App

While not strictly necessary, the Jumperless app is a python script that just uses your OS's built in terminal emulator (`screen` on mac/linux, `command prompt` on Windows) to set up a connection with the Jumperless. It does some other stuff too, like bridging Wokwi projects to have them update the Jumperless in real time, updating the fimware when a newer version is available, and uh.. that's pretty much it. 
(My favorite thing it does is to force non-exlusivity of the port, so you can just leave it connected and flash firmware and it'll reconnect when it's done)

So grab the one for your OS from [releases](https://github.com/Architeuthis-Flux/JumperlessV5/releases/latest), if it doesn't work, there's also the python script you can run.

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

## The Click Wheel
wheel copy

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

# Animated rows

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

`GPIO` outputs will be either green or red depending on their state

# Idle mode interactions

#### The main thing it there'a a lot more interaction that can be done outside of any particular mode (like not probing and the logo is rainbowy, I'm gonna call this idle mode here until I think of a good name)
idle

Here's what's new (all of this is in idle mode):

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

- The click wheel scrolls through highlighting `rows` as if you tapped each one

- With a `row` selected, here's what you can do

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

# OLED Support

First, get yourself one of these bad boys (literally any of these are fine.)

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

If you want to use this all the time, there's a config option to connect the OLED on startup. You can just paste these into the main menu:
```
`[top_oled] enabled = true;
```
and
```
`[top_oled] connect_on_boot = true;
```

# Config file stuff

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

```
copy / edit / paste any of these lines 
into the main menu to change a setting

Jumperless Config:

`[hardware] generation = 5;
`[hardware] revision = 5;
`[hardware] probe_revision = 5;

`[dacs] top_rail = 3.50;
`[dacs] bottom_rail = 3.50;
`[dacs] dac_0 = 3.30;
`[dacs] dac_1 = 0.00;
`[dacs] set_dacs_on_boot = false;
`[dacs] set_rails_on_boot = true;
`[dacs] probe_power_dac = 0;
`[dacs] limit_max = 8.00;
`[dacs] limit_min = -8.00;

`[debug] file_parsing = false;
`[debug] net_manager = false;
`[debug] nets_to_chips = false;
`[debug] nets_to_chips_alt = false;
`[debug] leds = false;

`[routing] stack_paths = 0;
`[routing] stack_rails = 2;
`[routing] stack_dacs = 0;
`[routing] rail_priority = 1;

`[calibration] top_rail_zero = 1625;
`[calibration] top_rail_spread = 20.90;
`[calibration] bottom_rail_zero = 1637;
`[calibration] bottom_rail_spread = 20.67;
`[calibration] dac_0_zero = 1636;
`[calibration] dac_0_spread = 21.00;
`[calibration] dac_1_zero = 1641;
`[calibration] dac_1_spread = 20.80;
`[calibration] probe_max = 4060;
`[calibration] probe_min = 16;

`[logo_pads] top_guy = uart_tx;
`[logo_pads] bottom_guy = uart_rx;
`[logo_pads] building_pad_top = off;
`[logo_pads] building_pad_bottom = off;

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

`[gpio] direction = 0,0,1,1,1,1,1,1,0,1;
`[gpio] pulls = 0,0,0,0,0,0,0,0,2,2;
`[gpio] uart_tx_function = off;
`[gpio] uart_rx_function = passthrough;

`[serial_1] function = passthrough;
`[serial_1] baud_rate = 115200;
`[serial_1] print_passthrough = false;
`[serial_1] connect_on_boot = false;
`[serial_1] lock_connection = false;

`[serial_2] function = off;
`[serial_2] baud_rate = 115200;
`[serial_2] print_passthrough = false;
`[serial_2] connect_on_boot = false;
`[serial_2] lock_connection = false;

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

```

There's also a `help` you can get to by entering `~?`
```
         ~ = show current config
~[section] = show specific section (e.g. ~[routing])
         ` = enter config settings
        ~? = show this help

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

    config setting format (prefix with ` to paste from main menu)

`[serial_1]connect_on_boot = true;

``` 

# Crossbar display
There's a new way to see what the 12 analog crossbar switches are up to, just enter `c` in the menu
 
```
 Analog Crossbar Array

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

```

# Arduino UART passthrough

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

# 3D printable stand

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

---

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

## Glossary of terms:

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

## Odds and ends

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

- `x` will clear all connections in the current slot

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

- You can manually toggle the 2 Reset lines with `r` (both), `rt` (top), `rb` (bottom)

- LED brightness menu updated (pro tip, try `l?`, `lc`, and `lb`)

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

- `g` will show the state of all the `gpio`

- `#`[any text] will print text on the breadboard (type `m` or whatever to go back)

## What's that `BUFFER_IN - DAC_0` bridge that's always there?

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
