Architeuthis-Flux/JumperlessV5/Jumperless23V50/Stands/3D Printed/Images/3DstandB-06.jpg

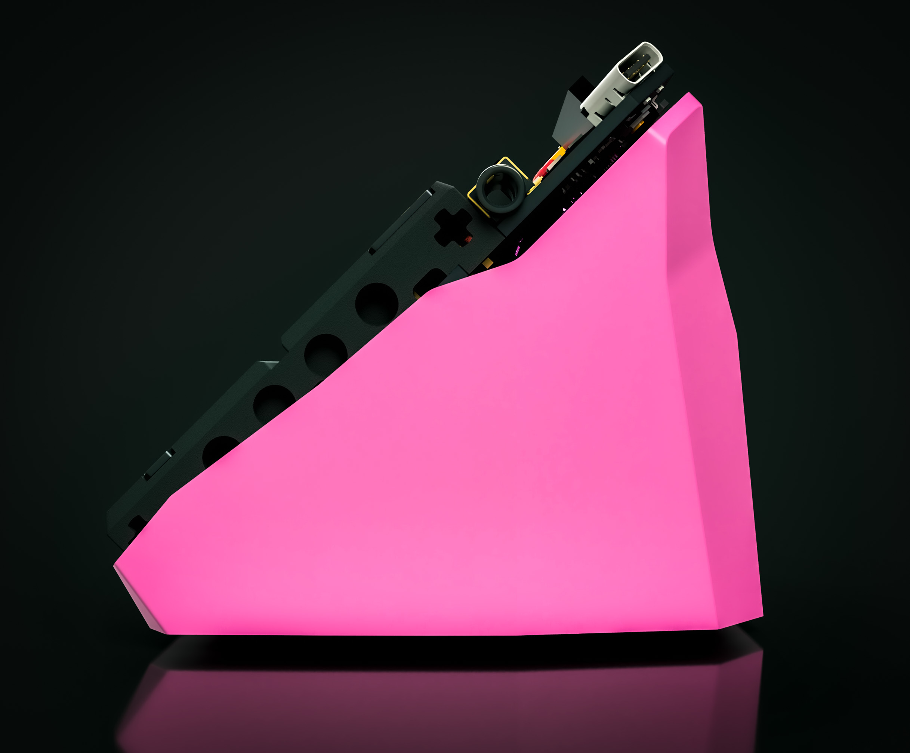
Jumperless23V50/Stands/3D Printed/Images/3DstandB-06.jpg
