Architeuthis-Flux/JumperlessV5/Jumperless23V50/Stands/3D Printed/Images/draftPrint-07.jpeg

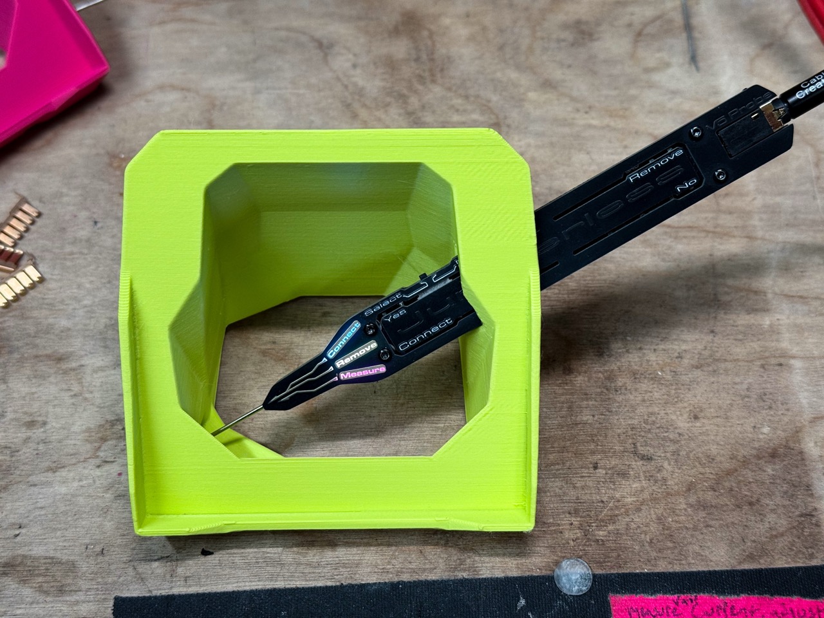
Jumperless23V50/Stands/3D Printed/Images/draftPrint-07.jpeg
