Architeuthis-Flux/JumperlessV5/(threads)

Thread 17 (2025-07-02):

Device catatonic after I flashed the wrong firmware! Any ideas?

kivikakk, 2025-07-02:
Hi! I've been playing with my new Jumperless V5. It's really neat!

I tried downloading and using the software on macOS. The automatic firmware update repeatedly failed — it couldn't locate the mounted drive after (successfully) putting the RP2350 in BOOTSEL. So I just manually dragged the u2f in. So far so good.

After making some connections on the command line, I tried removing the same one. I'd accidentally created a self-connection — I'd connected `1-5`, `2-5`, `3-5`, `4-5`, `5-5`. (A single net was created which covered all 5.) I removed `1-5` through `4-5`, and then on removing `5-5`, there was no response. The device seemed to hang, so I tried unplugging it from the computer and plugging it back in.

None of the LEDs on the board came on, and haven't since. I can re-flash the firmware, unplug it entirely and replug, but there's no response on any of the `/dev/cu.usbmodem*` that come up.

At this point I realised I was using the non-V5 Jumperless software and firmware. It's not very easy to realise if you come in via an external link; I don't have much context for the project and it wasn't obvious to me that I was looking at stuff for the older version!

After flashing with V5 (still can access BOOTSEL fine), still, there's no response. I get three devices in `/dev`, named `cu.usbmodem510[135]`. None of them respond with anything if I try poking them manually.

Any ideas on what I might've done, and how I might get it up and running again? I don't know if this has caused a physical hardware fault, or if there's just some state stuck in flash, or what to try.

Thanks for any advice you might have!

Architeuthis-Flux, 2025-07-02:
Hey, not to worry. It sounds like it just has garbage on the filesystem and is locking up trying to read it (but that's also a thing I should fix in the code.)

So let's nuke the flash and load the firmware again.
[universal_flash_nuke.uf2.zip](https://github.com/user-attachments/files/21018689/universal_flash_nuke.uf2.zip)
(Github doesn't allow UF2s here so you'll need to unzip it). This takes like 3ish minutes, so when you drop this UF2, wait until the drive pops up again, then load the firmware from releases.

It should do an auto calibration on first startup and hen you should be good. Let me know if that works.

Thread 18 (2025-07-05):

Creating linux .tar.gz distribution with BSD tar includes macOS xattrs which GNU tar can't understand.

opfpqgoon, 2025-07-05:
The command that creates the linux .tar.gz file includes xattrs from the files packaged.  GNU tar can't understand these xattrs and throws some warning to the user when extracting the linux package published with releases.

example:
```
tar tvf Jumperless_Linux.tar.gz
-rwxr-xr-x username/staff 163 2025-07-01 10:50 ._Jumperless_Linux
tar: Ignoring unknown extended header keyword 'LIBARCHIVE.xattr.com.apple.provenance'
drwxr-xr-x username/staff   0 2025-07-01 10:50 Jumperless_Linux/
-rwxr-xr-x username/staff 163 2025-07-01 10:50 Jumperless_Linux/._jumperless_launcher.py
tar: Ignoring unknown extended header keyword 'LIBARCHIVE.xattr.com.apple.provenance'
-rwxr-xr-x username/staff 3630 2025-07-01 10:50 Jumperless_Linux/jumperless_launcher.py
-rw-r--r-- username/staff  163 2025-07-01 10:49 Jumperless_Linux/._requirements.txt
tar: Ignoring unknown extended header keyword 'LIBARCHIVE.xattr.com.apple.provenance'
-rw-r--r-- username/staff  219 2025-07-01 10:49 Jumperless_Linux/requirements.txt
-rwxr-xr-x username/staff  163 2025-05-29 20:36 Jumperless_Linux/._jumperless_launcher
tar: Ignoring unknown extended header keyword 'LIBARCHIVE.xattr.com.apple.provenance'
-rwxr-xr-x username/staff 2812 2025-05-29 20:36 Jumperless_Linux/jumperless_launcher
-rw-r--r-- username/staff  163 2025-07-01 10:50 Jumperless_Linux/._README.md
tar: Ignoring unknown extended header keyword 'LIBARCHIVE.xattr.com.apple.provenance'
-rw-r--r-- username/staff 2929 2025-07-01 10:50 Jumperless_Linux/README.md
-rw------- username/staff  163 2025-07-01 10:49 Jumperless_Linux/._JumperlessWokwiBridge.py
tar: Ignoring unknown extended header keyword 'LIBARCHIVE.xattr.com.apple.provenance'
-rw------- username/staff 228963 2025-07-01 10:49 Jumperless_Linux/JumperlessWokwiBridge.py
-rwxr-xr-x username/staff    163 2025-05-29 20:36 Jumperless_Linux/._jumperless_launcher.sh
tar: Ignoring unknown extended header keyword 'LIBARCHIVE.xattr.com.apple.provenance'
-rwxr-xr-x username/staff   2812 2025-05-29 20:36 Jumperless_Linux/jumperless_launcher.sh
```
https://github.com/Architeuthis-Flux/JumperlessV5/blob/458b4e6d575746cbfc400ef25866bf61100bf3e3/JumperlessWokwiBridge/JumperlessAppPackager.py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

This should be a pretty easy fix, just need to add a `xattr -cr ./*` prior to invoking tar when packaging the files.  I'm forking the repo now to work on this fix.

Architeuthis-Flux, 2025-07-05:
Omg thanks! I am *so* out of my depth on this stuff.

opfpqgoon, 2025-07-06:
@Architeuthis-Flux when you create the linux .tar.gz for distribution, are you running JumperlessAppPackager.py on your mac and passing in an argument to get it to output a Linux package or are you running that on a linux VM or other linux host?

opfpqgoon, 2025-07-06:
Ah, looks like maybe you're using #4?
https://github.com/Architeuthis-Flux/JumperlessV5/blob/458b4e6d575746cbfc400ef25866bf61100bf3e3/JumperlessWokwiBridge/JumperlessAppPackager.py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

Architeuthis-Flux, 2025-07-06:
I'm running it in a VM with Ubuntu (it's arm64 still)

opfpqgoon, 2025-07-06:
> I'm running it in a VM with Ubuntu (it's arm64 still)

Hmm okay.  I gotta figure out how the xattrs are being injected then.  Any chance you're mounting your macOS filesystem in the VM?  I.e. the jumperless repo is on your mac, and you mount that into the VM and run JumperlessAppPackager in the VM on the mounted filesystem?

Architeuthis-Flux, 2025-07-06:
Oooooh yes, I am doing that. I'm just sharing the folder.

Architeuthis-Flux, 2025-07-06:
I hadn't even thought of that being an issue but that totally makes sense. Maybe I should just buck up and figure out doing this the right way with some cloud thing

Architeuthis-Flux, 2025-07-06:
The moral of the story is: don't let hardware people ship software. Especially when it's trying to be cross-platform.

opfpqgoon, 2025-07-06:
> I hadn't even thought of that being an issue but that totally makes sense. Maybe I should just buck up and figure out doing this the right way with some cloud thing

I'm 100% a github newb.  I know there's ton's of power with GitHub Actions; I have no idea how it works or the cost implications.  You could do stuff in AWS w/the free tier; that adds another external dependency and configuration for contributing/testing though.

Are you willing to let the `xattr` package (provided by apt) be a pre-requisite for running JumperlessAppPackager on linux?  I can add a check for xattrs and remove them if present.

opfpqgoon, 2025-07-06:
Hmm, according to the GNU tar manpage, --no-xattrs might fix it too (although that's the default?) https://www.gnu.org/software/tar/manual/html_node/Extended-File-Attributes.html

I probably won't have this fixed tonight.  I need to get a macbook up and running with ubuntu on it so I can simulate your workflow.

More to come in the coming days :)

Architeuthis-Flux, 2025-07-06:
> Are you willing to let the `xattr` package (provided by apt) be a pre-requisite for running JumperlessAppPackager on linux? I can add a check for xattrs and remove them if present.

Yeah I don't mind, it's just the packager, I don't care how many dependencies it has.

> I'm 100% a github newb. I know there's ton's of power with GitHub Actions; I have no idea how it works or the cost implications. You could do stuff in AWS w/the free tier; that adds another external dependency and configuration for contributing/testing though.

I will spend any amount of money if it means people can just run the app without bullshit.

Architeuthis-Flux, 2025-07-06:
This is all a cautionary tale of letting AI write code that you don't understand well enough to fact check. For the firmware I'm *so* picky about what it should and shouldn't do, but this stuff I'm just like, "uhhh, seems reasonable, send it."

opfpqgoon, 2025-07-06:
I just started using GH copilot 2 days ago, I know what you mean.  On one hand, _holy crap it saves so much time!_, on the other, **that argument for method x doesn't exist copilot......**

opfpqgoon, 2025-07-12:
I'm going to close this since and re-open in the new app repo if I can reproduce it.

Closed 2025-07-12.

Thread 21 (2025-07-10):

Hello world type projects?

brunoga, 2025-07-10:
I think it would be great to include Hello World type projects (including extra hardware needed) to make it easier for people with little hardware background (yours truly) to be able to get up to speed quicker. The simple get a let to light up example comes to mind. There might be others interesting enough and simple enough (in terms of extra hardware needed).

An example that actually can work with a connected computer through the serial port would also be cool.

Romonaga, 2025-09-01:
I do think this is a fantastic Idea, it would help people getup to speed.  There is a learning curve here, and simple step by step instructions would be very nice.

A simple led and resistor would be fantastic.  Easy parts to source, and small enough to fit in a box.  If we wanted to get fancier could toss a 555 Timer chip and a capacitor in the box as well.

filipbasd, 2025-09-27:
An example of how to use the logic analyzer under Linux would be great, as it's completely unclear how it works.
