Architeuthis-Flux/JumperlessV5/Jumperless23V50/Jumperless23V50.pdf

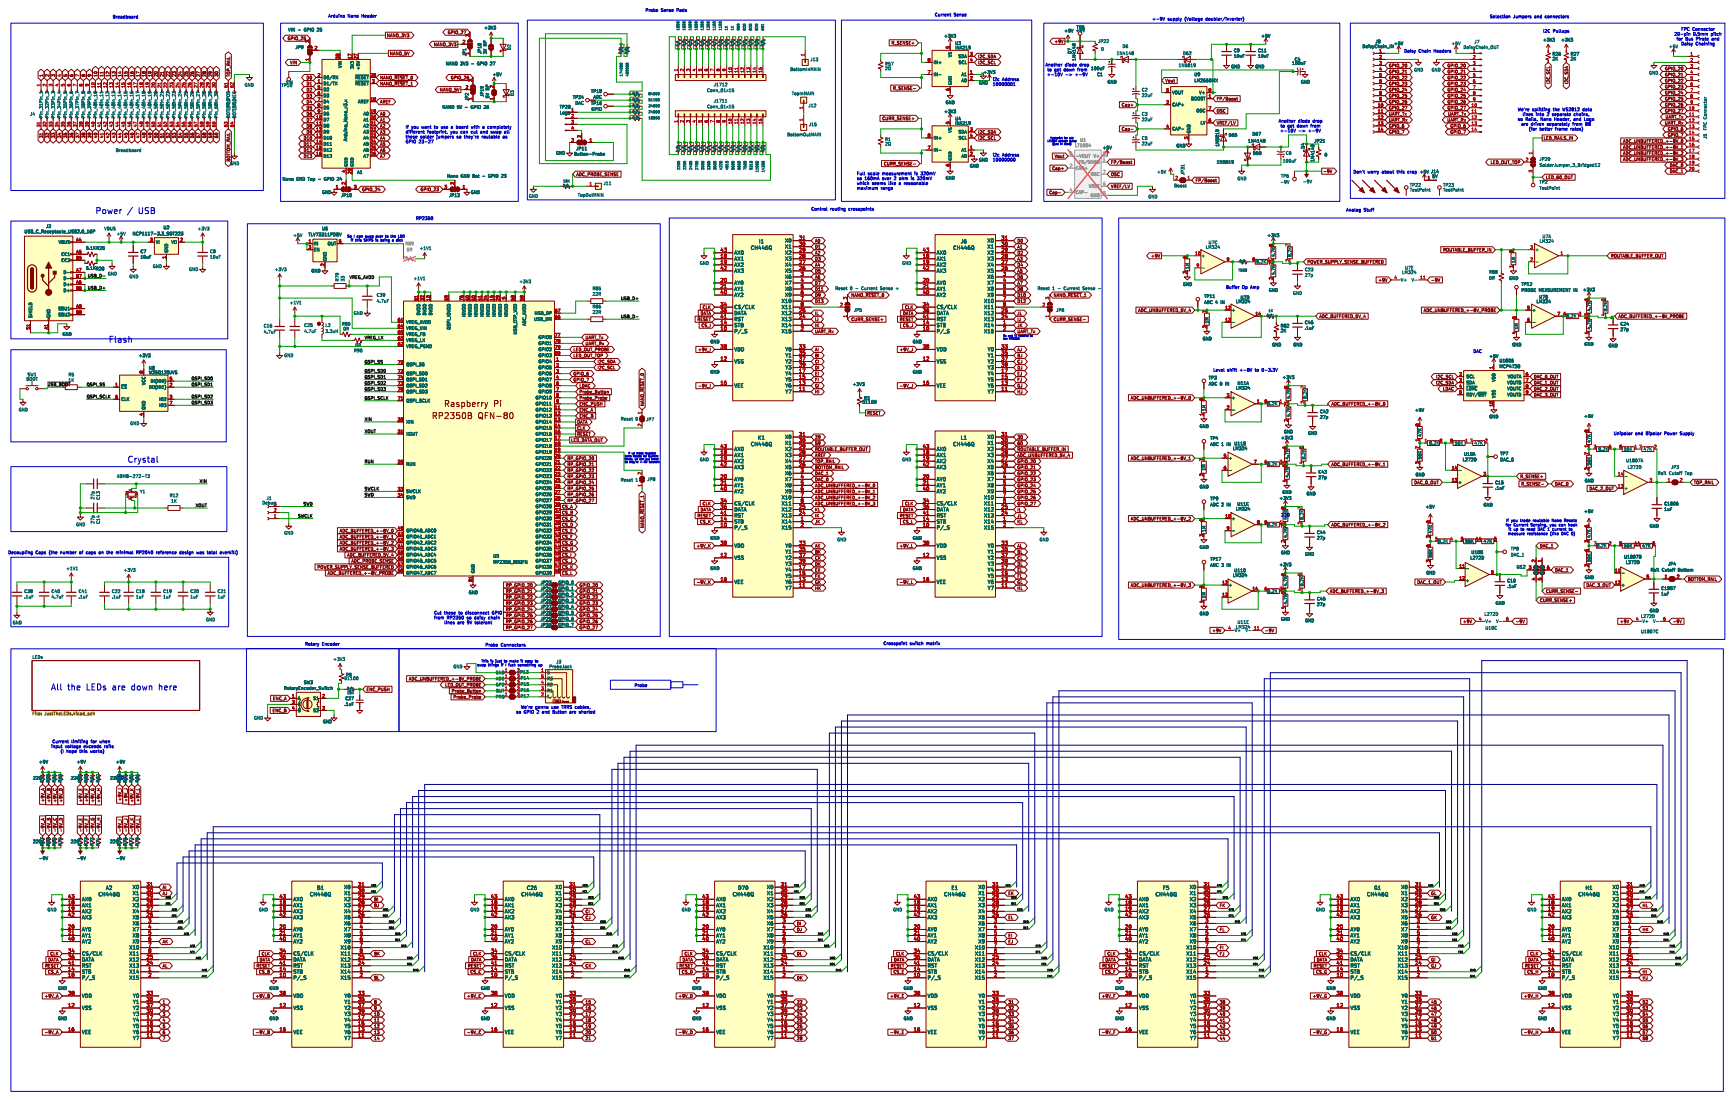
[picture p77: page 1]

Probe Sense Pads Arduino Nano Header Flash

Don't worry about this crap +5V C11

Another diode drop
to get down from

3 JP2 NANO 5V - GPIO 26 GND GND

lines into 2 separate chains, so Rails, Nano Header, and Logo

(for better frame rates)
LED_RAILS_IN

5 IOVDD 50 DVDD 51 GPIO41_ADC1 52 GPIO42_ADC2 53 GPIO43_ADC3 54 GPIO44_ADC4 55 GPIO45_ADC5 56 GPIO46_ADC6 57 GPIO47_ADC7 58 ADC_AVDD 59 GPIO8 6 IOVDD 60 VREG_AVDD 61 VREG_PGND 62 VREG_LX 63 VREG_VIN 64 VREG_FB 65 USB_DM 66 USB_DP 67 USB_OTP_VDD 68 QSPI_IOVDD 69 GPIO9 7 QSPI_SD3 70 QSPI_SCLK 71 QSPI_SD0 72 QSPI_SD2 73 QSPI_SD1 74 QSPI_SS 75 IOVDD 76 GPIO0 77 GPIO1 78 GPIO2 79 GPIO10 8 GPIO3 80 GND 81 GPIO11 9 U5 RP2350_80QFN R40 2200 R39 2200

JP12 Nano GND Bot - GPIO 23

JP10 Nano GND Top - GPIO 24

So I can swap over to the LDO
if this SMPS is being a dick

JP6 Reset 1 - Current Sense - GND GND

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

If we trade routable Nano Resets for Current Sense, we can cut these

for Current Sensing, you can hook

4 5 GND GND GND GND 4.7K

from RP2350 so daisy chain
lines are 9V tolerant

This is just to make it easy to

input voltage exceeds rails
(I hope this works)
