Architeuthis-Flux/JumperlessV5/Jumperless23V50/MainBoard/JumperlessV5r8/JumperlessV5r8.cir

.title KiCad schematic
.save all
.probe alli
.probe p(RN15)
.probe p(R26)
.probe p(C1806)
.probe p(RN4)
.probe p(C1807)
.probe p(R27)
.probe p(RN17)
.probe p(RN16)
.probe p(C45)
.probe p(RN18)
.probe p(C44)
.probe p(RN13)
.probe p(RN14)
.probe p(RN8)
.probe p(RN12)
.probe p(RN10)
.probe p(C42)
.probe p(C43)
.probe p(R88)
.probe p(C24)
.probe p(RN6)
.probe p(RN7)
.probe p(RN19)
.probe p(C15)
.probe p(C10)
.probe p(R81)
.probe p(C46)
.probe p(R82)
.probe p(R87)
.probe p(C23)
.probe p(C5)
.probe p(C3)
.probe p(C2)
.probe p(C1)
.probe p(C6)
.probe p(C9)
.probe p(C11)
.probe p(C4)
.probe p(R24)
.probe p(R31)
.probe p(R23)
.probe p(R30)
.probe p(R29)
.probe p(R49)
.probe p(R50)
.probe p(R51)
.probe p(RN2)
.probe p(R57)
.probe p(R1)
.probe p(R54)
.probe p(R37)
.probe p(R38)
.probe p(R33)
.probe p(R34)
.probe p(R35)
.probe p(R32)
.probe p(R36)
.probe p(R53)
.probe p(R52)
.probe p(R39)
.probe p(R44)
.probe p(R45)
.probe p(R43)
.probe p(R40)
.probe p(R42)
.probe p(R41)
.probe p(R17)
.probe p(R16)
.probe p(R13)
.probe p(R14)
.probe p(R15)
.probe p(R46)
.probe p(R47)
.probe p(R20)
.probe p(R19)
.probe p(R48)
.probe p(R18)
.probe p(R4)
.probe p(R10)
.probe p(R3)
.probe p(R12)
.probe p(C14)
.probe p(R76)
.probe p(R75)
.probe p(R78)
.probe p(R77)
.probe p(R74)
.probe p(R72)
.probe p(R73)
.probe p(C27)
.probe p(R22)
.probe p(R8)
.probe p(C20)
.probe p(C21)
.probe p(C19)
.probe p(C18)
.probe p(C40)
.probe p(C41)
.probe p(C22)
.probe p(R59)
.probe p(R62)
.probe p(R60)
.probe p(R61)
.probe p(R21)
.probe p(R56)
.probe p(R55)
.probe p(R58)
.probe p(R64)
.probe p(R65)
.probe p(R66)
.probe p(R63)
.probe p(R71)
.probe p(R68)
.probe p(R69)
.probe p(R70)
.probe p(R67)
.probe p(C7)
.probe p(C25)
.probe p(R28)
.probe p(R25)
.probe p(C8)
.probe p(C16)
.probe p(R5)
.probe p(C13)
.probe p(C38)
.probe p(R85)
.probe p(R86)
.probe p(L2)
.probe p(R80)
.probe p(R79)
.probe p(R90)
.probe p(C39)
.probe p(C29)
.probe p(C34)
.probe p(C33)
.probe p(C31)
.probe p(C28)
.probe p(C32)
.probe p(C30)
.probe p(C35)
.probe p(C36)
.probe p(C37)
U11 __U11
U10 __U10
U1807 __U1807
RN15 GND ROUTABLE_BUFFER_IN 1Meg
U7 __U7
R26 +3V3 I2C_SCL 2k
TP23 __TP23
TP22 __TP22
J14 __J14
JP4 __JP4
C1806 Net-_JP3-A_ GND 1u
JP3 __JP3
RN4 Net-_JP3-A_ Net-_RN19A-R1.1_ 47k
C1807 Net-_JP4-A_ GND 1u
J8 __J8
J7 __J7
TP2 __TP2
J10 __J10
J5 __J5
R27 +3V3 I2C_SDA 2k
J9 __J9
U6 __U6
RN17 ADC_BUFFERED_+-8V_3 +3V3 4.7k
RN16 ADC_BUFFERED_+-8V_3 Net-_RN16C-R3.2_ 8.2k
C45 ADC_BUFFERED_+-8V_3 GND 27p
RN18 GND ADC_UNBUFFERED_+-8V_3 1Meg
TP17 __TP17
C44 ADC_BUFFERED_+-8V_2 GND 27p
U1806 __U1806
RN13 ADC_BUFFERED_+-8V_1 +3V3 8.2k
RN14 ADC_BUFFERED_+-8V_1 +3V3 4.7k
TP9 __TP9
TP4 __TP4
RN8 Net-_RN10C-R3.2_ +5V 47k
RN12 Net-_RN10D-R4.2_ Net-_RN10C-R3.2_ 8.2k
RN10 GND Net-_RN10B-R2.2_ 56k
C42 ADC_BUFFERED_+-8V_0 GND 27p
C43 ADC_BUFFERED_+-8V_1 GND 27p
TP12 __TP12
R88 ROUTABLE_BUFFER_IN ADC_UNBUFFERED_+-8V_PROBE 0
C24 ADC_BUFFERED_+-8V_PROBE GND 27p
RN6 ADC_BUFFERED_+-8V_PROBE +3V3 4.7k
RN7 ADC_BUFFERED_+-8V_PROBE Net-_RN7C-R3.2_ 8.2k
RN19 GND Net-_RN12C-R3.1_ 56k
C15 R_SENSE+ GND 0.1u
TP7 __TP7
TP8 __TP8
C10 Net-_RN8D-R4.2_ GND 0.1u
U12 __U12
TP3 __TP3
G1 __G1
A2 __A2
H1 __H1
D70 __D70
E1 __E1
C26 __C26
F5 __F5
B1 __B1
TP6 __TP6
JP31 __JP31
R81 Net-_U7C--_ Net-_RN7A-R1.2_ 7500
C46 ADC_BUFFERED_5V_4 GND 0.1u
R82 ADC_BUFFERED_5V_4 GND 2k
R87 Net-_U7D--_ ADC_BUFFERED_5V_4 1k
TP11 __TP11
C23 POWER_SUPPLY_SENSE_BUFFERED GND 27p
D7 __D7
U9 __U9
U1 __U1
C5 Cap- Net-_D65-A_ 10u
JP22 __JP22
TP5 __TP5
C3 Cap+ Cap- 10u
D62 __D62
C2 Net-_D6-A_ Cap+ 10u
C1 Net-_D6-K_ GND 100u
D6 __D6
D68 __D68
JP21 __JP21
C6 GND Net-_D4-K_ 100u
D4 __D4
D65 __D65
C9 +5V GND 10u
C11 +5V GND 10u
D67 __D67
C4 GND Vout 100u
TP10 __TP10
A1 __A1
J4 __J4
J2 __J2
R24 Net-_J1712-Pin_13_ Net-_J1712-Pin_12_ 820
R31 Net-_J13-Pin_1_ Net-_J1712-Pin_15_ 681
R23 Net-_J1712-Pin_12_ Net-_J1712-Pin_11_ 909
R30 Net-_J1712-Pin_15_ Net-_J1712-Pin_14_ 820
R29 Net-_J1712-Pin_14_ Net-_J1712-Pin_13_ 820
J13 __J13
R49 Net-_J1711-Pin_10_ Net-_J1711-Pin_11_ 6650
R50 Net-_J1711-Pin_11_ Net-_J1711-Pin_12_ 7500
J12 __J12
J15 __J15
R51 Net-_J1711-Pin_12_ Net-_J1711-Pin_13_ 9310
RN2 Net-_RN2A-R1.1_ R_SENSE+ 470
R57 R_SENSE+ DAC_0 2
U3 __U3
R1 CURR_SENSE+ CURR_SENSE- 2
U4 __U4
TP28 __TP28
R54 GND ADC_PROBE_SENSE 10k
TP18 __TP18
TP24 __TP24
J11 __J11
R37 Net-_TP28-Pin_2_ Net-_TP28-Pin_1_ 24000
R38 Net-_J1711-Pin_15_ Net-_TP28-Pin_2_ 18000
R33 Net-_TP28-Pin_3_ Net-_JP11-A_ 499000
R34 Net-_R34-Pad1_ Net-_R32-Pad1_ 84500
R35 Net-_R35-Pad1_ Net-_R34-Pad1_ 51100
R32 Net-_R32-Pad1_ Net-_TP28-Pin_3_ 174000
R36 Net-_TP28-Pin_1_ Net-_R35-Pad1_ 34000
TP16 __TP16
R53 Net-_J1711-Pin_14_ Net-_J1711-Pin_15_ 14300
R52 Net-_J1711-Pin_13_ Net-_J1711-Pin_14_ 11000
JP19 __JP19
D3 __D3
D2 __D2
R39 Net-_J1712-Pin_1_ Net-_J1711-Pin_1_ 2200
J1711 __J1711
R44 Net-_J1711-Pin_5_ Net-_J1711-Pin_6_ 3300
R45 Net-_J1711-Pin_6_ Net-_J1711-Pin_7_ 3600
R43 Net-_J1711-Pin_4_ Net-_J1711-Pin_5_ 3000
R40 Net-_J1711-Pin_1_ Net-_J1711-Pin_2_ 2200
R42 Net-_J1711-Pin_3_ Net-_J1711-Pin_4_ 2700
R41 Net-_J1711-Pin_2_ Net-_J1711-Pin_3_ 2400
R17 Net-_J1712-Pin_8_ Net-_J1712-Pin_7_ 1100
R16 Net-_J1712-Pin_7_ Net-_J1712-Pin_6_ 1300
R13 Net-_J1712-Pin_4_ Net-_J1712-Pin_3_ 1600
R14 Net-_J1712-Pin_5_ Net-_J1712-Pin_4_ 1600
R15 Net-_J1712-Pin_6_ Net-_J1712-Pin_5_ 1300
R46 Net-_J1711-Pin_7_ Net-_J1711-Pin_8_ 4220
R47 Net-_J1711-Pin_8_ Net-_J1711-Pin_9_ 4810
R20 Net-_J1712-Pin_11_ Net-_J1712-Pin_10_ 1k
R19 Net-_J1712-Pin_10_ Net-_J1712-Pin_9_ 1k
R48 Net-_J1711-Pin_9_ Net-_J1711-Pin_10_ 5600
J1712 __J1712
R18 Net-_J1712-Pin_9_ Net-_J1712-Pin_8_ 1100
R4 Net-_J1712-Pin_2_ Net-_J1712-Pin_1_ 1800
R10 Net-_J1712-Pin_3_ Net-_J1712-Pin_2_ 1800
I1 __I1
K1 __K1
L1 __L1
R3 +3V3 RESET 51100
J6 __J6
R12 /XOUT Net-_C14-Pad1_ 1k
C14 Net-_C14-Pad1_ GND 27p
R76 -9V_J -9V 220
R75 -9V_I -9V 220
R78 -9V_L -9V 220
R77 -9V_K -9V 220
R74 -9V_H -9V 220
R72 -9V_F -9V 220
R73 -9V_G -9V 220
J1 __J1
C27 ENC_PUSH GND 0.1u
R22 Net-_SW3-S1_ ENC_PUSH 1k
SW3 __SW3
R8 +3V3 Net-_SW3-S1_ 51100
C20 +3V3 GND 1u
C21 +3V3 GND 1u
C19 +3V3 GND 1u
C18 +3V3 GND 1u
C40 +1V1 GND 4.7u
C41 +1V1 GND 0.1u
C22 +3V3 GND 0.1u
R59 +9V +9V_E 220
R62 +9V +9V_H 220
R60 +9V +9V_F 220
R61 +9V +9V_G 220
R21 +9V +9V_A 220
R56 +9V +9V_C 220
R55 +9V +9V_B 220
R58 +9V +9V_D 220
R64 +9V +9V_J 220
R65 +9V +9V_K 220
R66 +9V +9V_L 220
R63 +9V +9V_I 220
R71 -9V_E -9V 220
R68 -9V_B -9V 220
R69 -9V_C -9V 220
R70 -9V_D -9V 220
R67 -9V_A -9V 220
JP16 __JP16
JP17 __JP17
C7 +5V GND 10u
C25 +1V1 GND 4.7u
R28 Net-_J2-CC2_ GND 5.1k
R25 Net-_J2-CC1_ GND 5.1k
C8 +3V3 GND 10u
U2 __U2
C16 +3V3 GND 4.7u
JP15 __JP15
JP14 __JP14
JP13 __JP13
J3 __J3
R5 /QSPI_SS /_USB_BOOT 1k
SW1 __SW1
U8 __U8
C13 /XIN GND 27p
Y1 __Y1
C38 +1V1 GND 0.1u
R85 /USB_D+ Net-_U5-USB_DP_ 22
R86 /USB_D- Net-_U5-USB_DM_ 22
U5 __U5
L2 +1V1 Net-_L2-Pad2_ 3.3u
R80 +1V1 Net-_U5-VREG_FB_ 0
R79 +3V3 /VREG_AVDD 33
R90 Net-_L2-Pad2_ /VREG_LX 0
JP8 __JP8
JP7 __JP7
JP33 __JP33
C39 /VREG_AVDD GND 4.7u
D1251 __D1251
D1232 __D1232
D1231 __D1231
D1235 __D1235
D1233 __D1233
D1234 __D1234
D1242 __D1242
D1241 __D1241
D1254 __D1254
D1255 __D1255
D1265 __D1265
D1264 __D1264
D1263 __D1263
D1253 __D1253
D1243 __D1243
D1244 __D1244
D1245 __D1245
D1252 __D1252
D1261 __D1261
D1262 __D1262
D1565 __D1565
D1564 __D1564
D1555 __D1555
D1554 __D1554
D1553 __D1553
D1562 __D1562
D1563 __D1563
D1561 __D1561
D1552 __D1552
D1551 __D1551
D1542 __D1542
D1541 __D1541
D1543 __D1543
D1544 __D1544
D1535 __D1535
D1545 __D1545
D1534 __D1534
D1533 __D1533
D1532 __D1532
D1531 __D1531
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
TP20 __TP20
D1751 __D1751
D1754 __D1754
D1755 __D1755
D1753 __D1753
D1752 __D1752
D1757 __D1757
D1760 __D1760
D1759 __D1759
D1756 __D1756
D1758 __D1758
D1655 __D1655
D1656 __D1656
D1632 __D1632
D1658 __D1658
D1657 __D1657
D1633 __D1633
D1631 __D1631
D1660 __D1660
D1659 __D1659
D1617 __D1617
D1616 __D1616
D1619 __D1619
D1618 __D1618
D1635 __D1635
D1630 __D1630
D1634 __D1634
D1625 __D1625
D1620 __D1620
D1611 __D1611
D1613 __D1613
D1615 __D1615
D1614 __D1614
D1612 __D1612
TP19 __TP19
D1636 __D1636
TP25 __TP25
D1031 __D1031
D1061 __D1061
D1051 __D1051
D1041 __D1041
D1021 __D1021
D1071 __D1071
D1081 __D1081
D1091 __D1091
D1645 __D1645
D1101 __D1101
D1644 __D1644
D1643 __D1643
D1642 __D1642
D1641 __D1641
D1315 __D1315
D1314 __D1314
D1637 __D1637
D1640 __D1640
D1639 __D1639
D1638 __D1638
D1011 __D1011
D1012 __D1012
D1013 __D1013
D1014 __D1014
D1015 __D1015
D1311 __D1311
D1312 __D1312
D1313 __D1313
D1062 __D1062
D1065 __D1065
D1064 __D1064
D1063 __D1063
D1082 __D1082
D1084 __D1084
D1083 __D1083
D1074 __D1074
D1073 __D1073
D1085 __D1085
D1072 __D1072
D1401 __D1401
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
C29 +5V GND 1u
C34 +5V GND 1u
C33 +5V GND 1u
C31 +5V GND 1u
C28 +5V GND 1u
C32 +5V GND 1u
C30 +5V GND 1u
C35 +5V GND 1u
C36 +5V GND 1u
C37 +5V GND 1u
.end
