Architeuthis-Flux/JumperlessV5/Jumperless23V50/ProbeSenseNumbers/ProbeSenseNumbers.kicad_pcb

## KiCad design Jumperless23V50/ProbeSenseNumbers/ProbeSenseNumbers.kicad_pcb (2026-09-10)

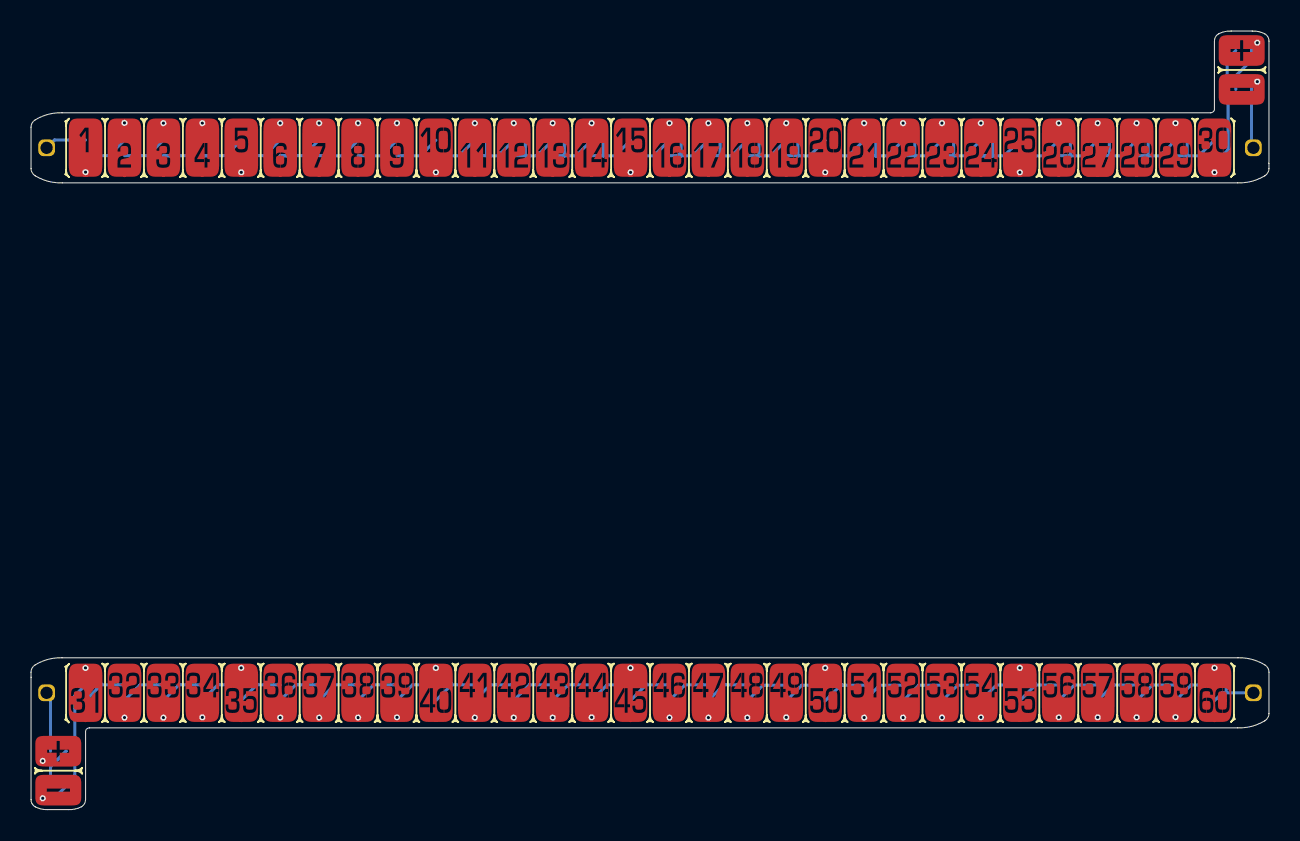
[picture p78: board ProbeSenseNumbers.kicad_pcb from above]

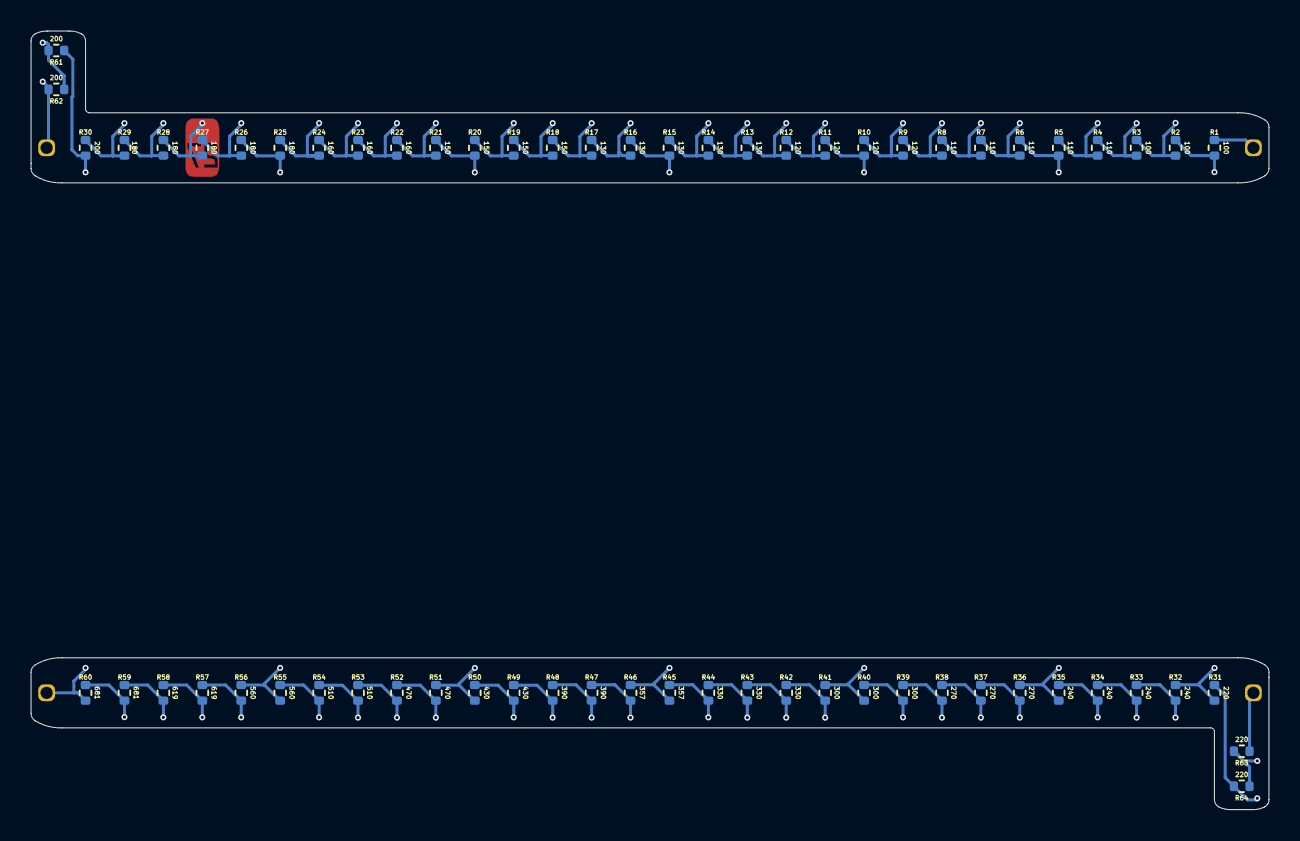
[picture p79: board ProbeSenseNumbers.kicad_pcb from below]

Board: 2 copper layers, 80.8 x 50.8 mm, 72 parts (64 on the bottom side), 66 nets.

Parts:
J3: TopIn; PinHeader_1x1_Smallest
J4: BottomOut; PinHeader_1x1_Smallest
J31: + - top; bbProbeContactsRails
J32: + - bottom; bbProbeContactsRails
J34: TopOut; PinHeader_1x1_Smallest
J35: BottomIn; PinHeader_1x1_Smallest
R1, R2, R3: 100; R_0402_1005Metric
R4, R5, R6, R7, R8: 110; R_0402_1005Metric
R9, R10, R11, R12: 120; R_0402_1005Metric
R13, R14, R15, R16, R17: 130; R_0402_1005Metric
R18, R19, R20, R21: 150; R_0402_1005Metric
R22, R23, R24: 160; R_0402_1005Metric
R25, R26, R27, R28, R29: 180; R_0402_1005Metric
R30, R61, R62: 200; R_0402_1005Metric
R31, R63, R64: 220; R_0402_1005Metric
R32, R33, R34, R35: 240; R_0402_1005Metric
R36, R37, R38: 270; R_0402_1005Metric
R39, R40, R41: 300; R_0402_1005Metric
R42, R43, R44: 330; R_0402_1005Metric
R45, R46: 357; R_0402_1005Metric
R47, R48: 390; R_0402_1005Metric
R49, R50: 430; R_0402_1005Metric
R51, R52: 470; R_0402_1005Metric
R53, R54: 510; R_0402_1005Metric
R55, R56: 560; R_0402_1005Metric
R57, R58: 619; R_0402_1005Metric
R59, R60: 681; R_0402_1005Metric
U1: bbProbeContactsTopRow
U3: bbProbeContactsBottomRow

Connections:
unnamed: J3.1, R1.1
unnamed: J4.1, R60.2, U3.60
unnamed: J31.1, R61.2, R62.1
unnamed: J31.2, J34.1, R62.2
unnamed: J32.1, R63.2, R64.1
unnamed: J32.2, R31.1, R64.2
unnamed: J35.1, R63.1
unnamed: R1.2, R2.1, U1.1
unnamed: R2.2, R3.1, U1.2
unnamed: R3.2, R4.1, U1.3
unnamed: R4.2, R5.1, U1.4
unnamed: R5.2, R6.1, U1.5
unnamed: R6.2, R7.1, U1.6
unnamed: R7.2, R8.1, U1.7
unnamed: R8.2, R9.1, U1.8
unnamed: R9.2, R10.1, U1.9
unnamed: R10.2, R11.1, U1.10
unnamed: R11.2, R12.1, U1.11
unnamed: R12.2, R13.1, U1.12
unnamed: R13.2, R14.1, U1.13
unnamed: R14.2, R15.1, U1.14
unnamed: R15.2, R16.1, U1.15
unnamed: R16.2, R17.1, U1.16
unnamed: R17.2, R18.1, U1.17
unnamed: R18.2, R19.1, U1.18
unnamed: R19.2, R20.1, U1.19
unnamed: R20.2, R21.1, U1.20
unnamed: R21.2, R22.1, U1.21
unnamed: R22.2, R23.1, U1.22
unnamed: R23.2, R24.1, U1.23
unnamed: R24.2, R25.1, U1.24
unnamed: R25.2, R26.1, U1.25
unnamed: R26.2, R27.1, U1.26
unnamed: R27.2, R28.1, U1.27
unnamed: R28.2, R29.1, U1.28
unnamed: R29.2, R30.1, U1.29
unnamed: R30.2, R61.1, U1.30
unnamed: R31.2, R32.1, U3.31
unnamed: R32.2, R33.1, U3.32
unnamed: R33.2, R34.1, U3.33
unnamed: R34.2, R35.1, U3.34
unnamed: R35.2, R36.1, U3.35
unnamed: R36.2, R37.1, U3.36
unnamed: R37.2, R38.1, U3.37
unnamed: R38.2, R39.1, U3.38
unnamed: R39.2, R40.1, U3.39
unnamed: R40.2, R41.1, U3.40
unnamed: R41.2, R42.1, U3.41
unnamed: R42.2, R43.1, U3.42
unnamed: R43.2, R44.1, U3.43
unnamed: R44.2, R45.1, U3.44
unnamed: R45.2, R46.1, U3.45
unnamed: R46.2, R47.1, U3.46
unnamed: R47.2, R48.1, U3.47
unnamed: R48.2, R49.1, U3.48
unnamed: R49.2, R50.1, U3.49
unnamed: R50.2, R51.1, U3.50
unnamed: R51.2, R52.1, U3.51
unnamed: R52.2, R53.1, U3.52
unnamed: R53.2, R54.1, U3.53
unnamed: R54.2, R55.1, U3.54
unnamed: R55.2, R56.1, U3.55
unnamed: R56.2, R57.1, U3.56
unnamed: R57.2, R58.1, U3.57
unnamed: R58.2, R59.1, U3.58
unnamed: R59.2, R60.1, U3.59
