Architeuthis-Flux/JumperlessV5/Jumperless23V50/AdapterBoards/FPCbreakout2/FPCbreakout2.kicad_pcb

## KiCad design Jumperless23V50/AdapterBoards/FPCbreakout2/FPCbreakout2.kicad_pcb (2025-12-16)

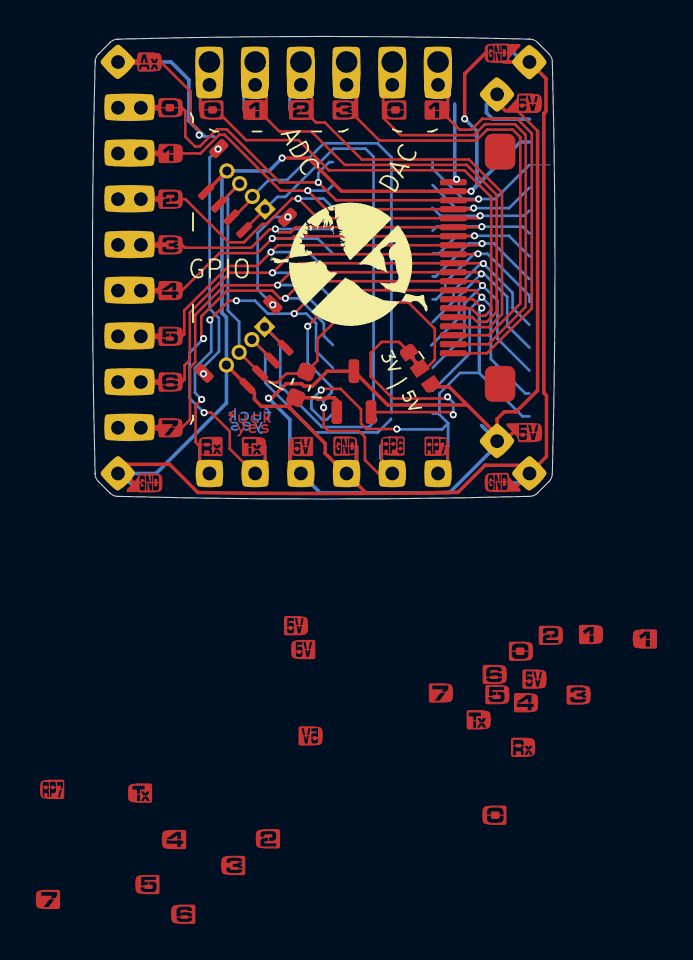
[picture p80: board FPCbreakout2.kicad_pcb from above]

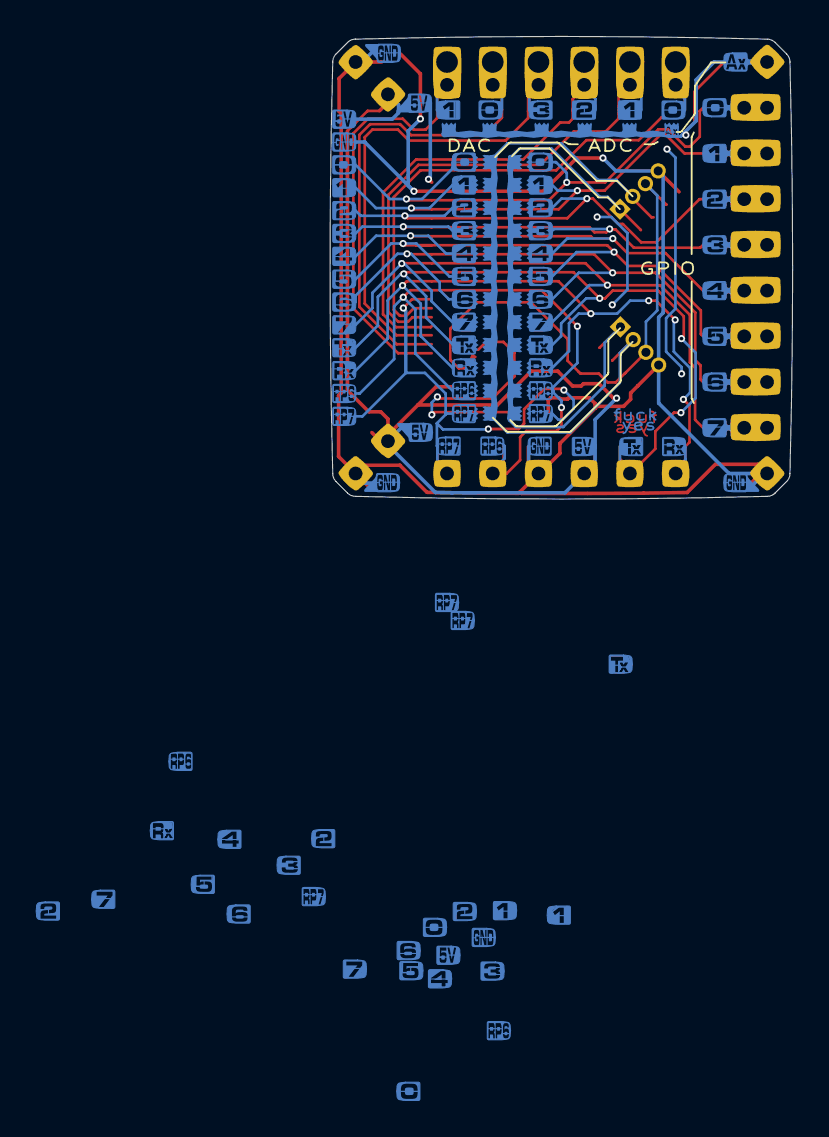
[picture p81: board FPCbreakout2.kicad_pcb from below]

Board: 2 copper layers, 25.7 x 25.7 mm, 20 parts (2 on the bottom side), 24 nets.

Parts:
C1: 1uF; C_0603_1608Metric
J1: FPC Connector; FPC FC05-S20FCT
J2: Routable GPIO; Conn_1x8
J3: DaisyChain_IN; daisychainRIGHT
J5, J14, J15: Power; Conn_1x2
J6: Control_I2C; Conn_1x2
J7: DACs; Conn_1x2
J8: ADCs; Conn_1x4
J9: Bus Pirate; Conn_1x10
J10: Routable UART; Conn_1x2
J17, J18: Conn_01x04; QwiicSMD
J20, J20#2: Conn_01x04; PinHeader_1x04_P1.00mm_Vertical
JP1: SolderJumper_3_Bridged12; SolderJumper-3_P1.3mm_Bridged12_Pad1.0x1.5mm
U1: SolderJumper_4of1_small
U3: Qwiic_Selector
U4: XC6206PxxxMR; SOT-23-3

Connections:
+5V: J1.1, J3.1, J5.1, J14.1, J15.1, JP1.3 (B), U4.3 (VI)
ADC_UNBUFFERED_+-8V_0: J1.15, J8.1
ADC_UNBUFFERED_+-8V_1: J1.16, J8.2
ADC_UNBUFFERED_+-8V_2: J1.17, J8.3
ADC_UNBUFFERED_+-8V_3: J1.18, J8.4
DAC_0: J1.19, J7.1
DAC_1: J1.20, J7.2
GND: C1.2, J1.2, J3.2, J5.2, J9.10, J14.2, J15.2, J17.4, J18.4, J20.4, J20#2.4, U4.1 (GND)
GPIO_6: J1.13, J3.13, J6.1, U3.13 (RP6)
GPIO_7: J1.14, J3.14, J6.2, U3.14 (RP7)
GPIO_20: J1.3, J2.1, J3.3, U3.3 (0)
GPIO_21: J1.4, J2.2, J3.4, U3.4 (1)
GPIO_22: J1.5, J2.3, J3.5, U3.5 (2)
GPIO_23: J1.6, J2.4, J3.6, U3.6 (3)
GPIO_24: J1.7, J2.5, J3.7, U3.7 (4)
GPIO_25: J1.8, J2.6, J3.8, U3.8 (5)
GPIO_26: J1.9, J2.7, J3.9, U3.9 (6)
GPIO_27: J1.10, J2.8, J3.10, U3.10 (7)
unnamed: J17.1, J18.1, J20.1, J20#2.1, U3.2 (SCL), U3.16 (SCL)
unnamed: J17.2, J18.2, J20.2, J20#2.2, U3.1 (SDA), U3.17 (SDA)
unnamed: JP1.1 (A), U4.2 (VO)
Qwiic_Power: C1.1, J17.3, J18.3, J20.3, J20#2.3, JP1.2 (C)
UART_Rx: J1.12, J3.12, J10.2, U3.12 (Rx)
UART_Tx: J1.11, J3.11, J10.1, U3.11 (Tx)
