Architeuthis-Flux/JumperlessV5/Jumperless23V50/Probe/V5probe/V5probe.kicad_pcb

## KiCad design Jumperless23V50/Probe/V5probe/V5probe.kicad_pcb (2025-10-31)

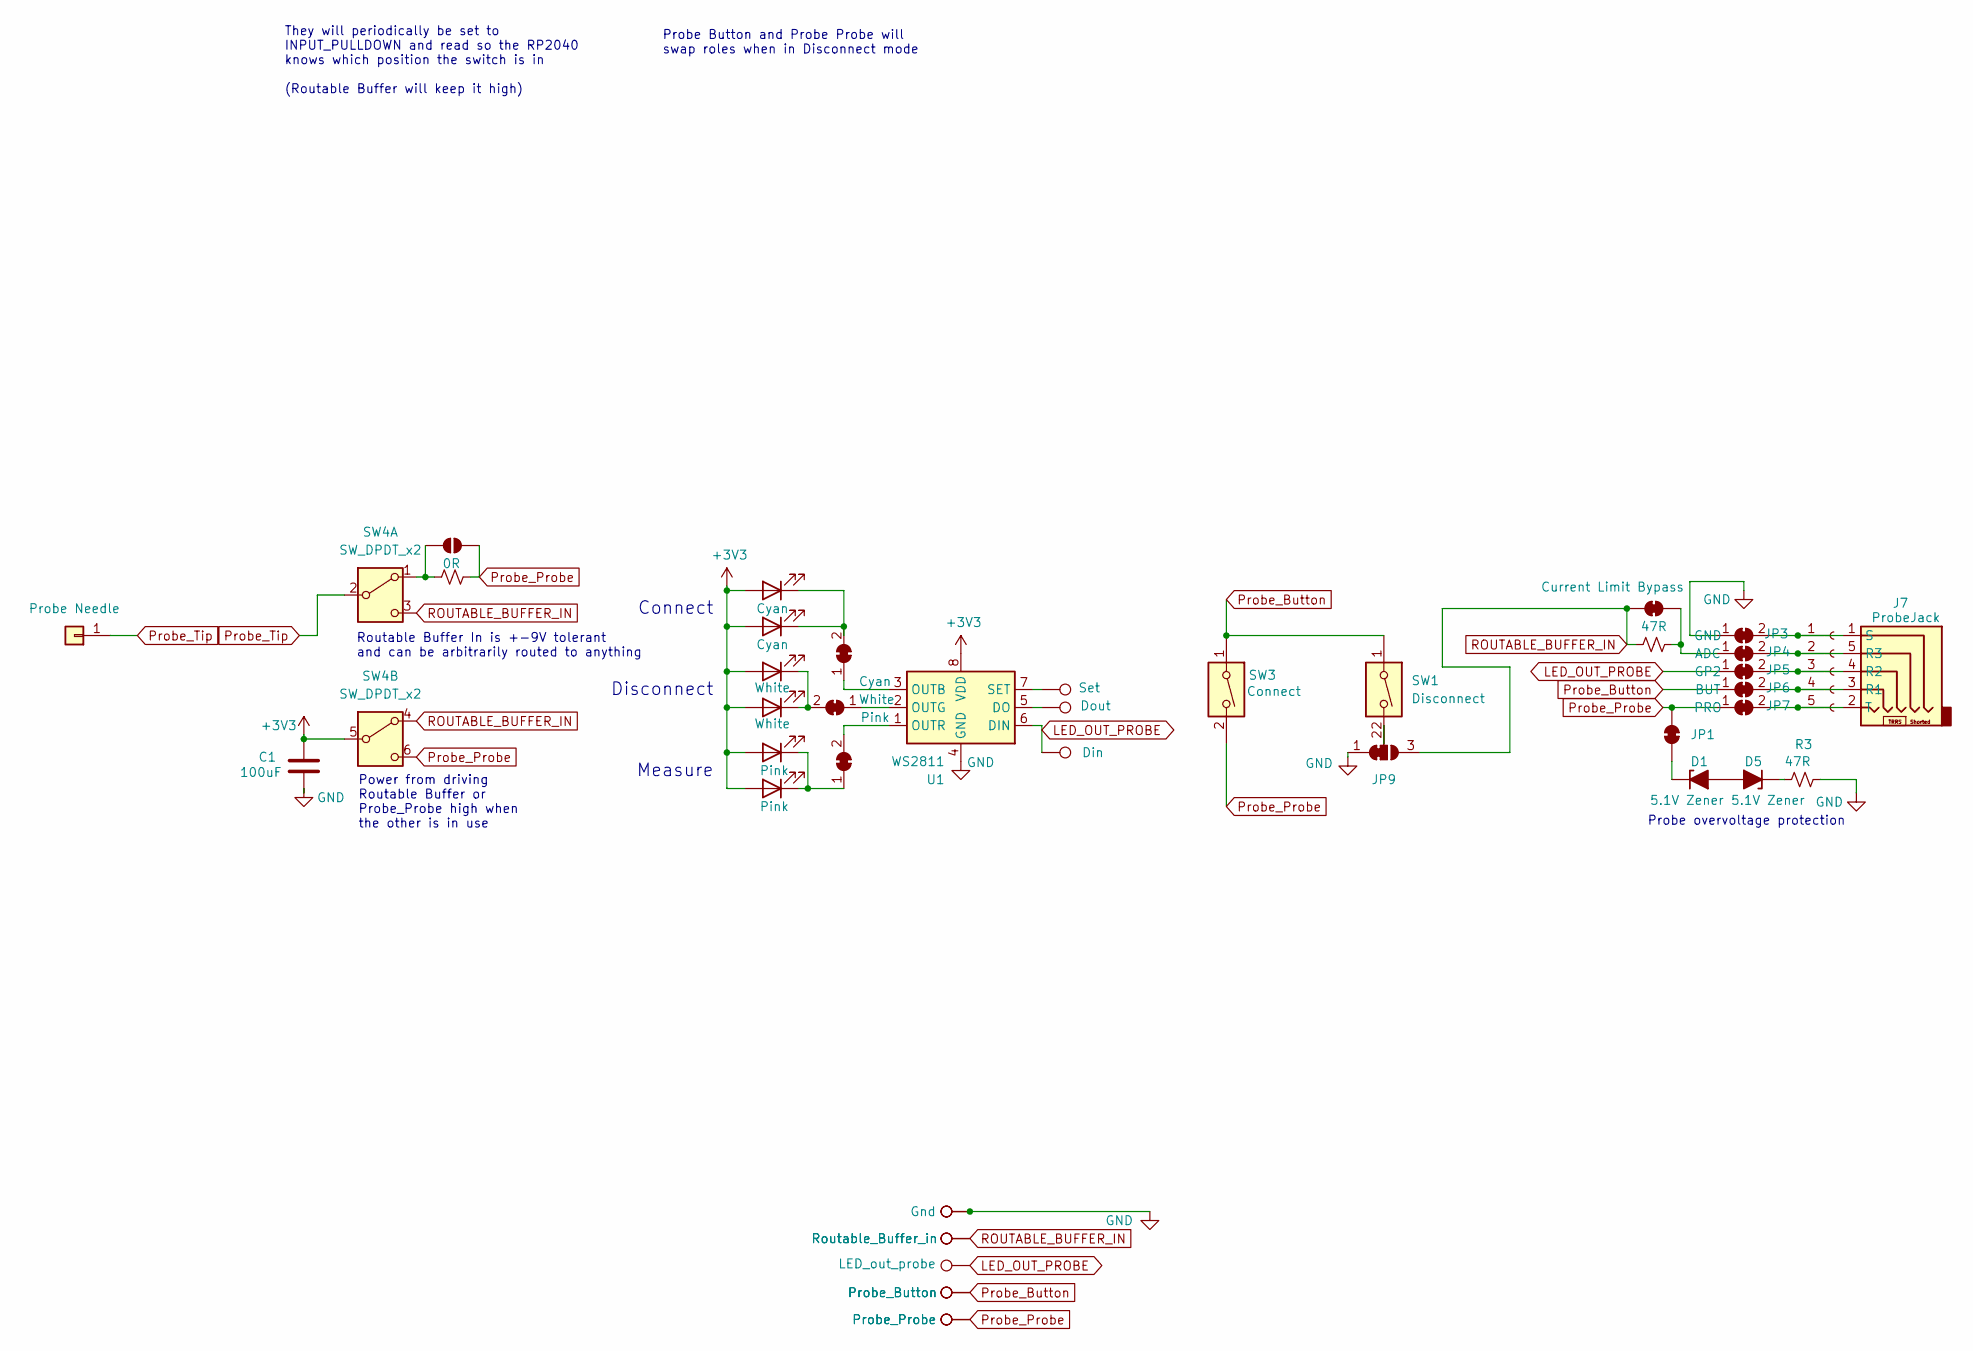
[picture p82: schematic V5probe.kicad_sch]

Parts:
C1: 100uF; C_1206_3216Metric_Pad1.33x1.80mm_HandSolder
D1, D5: 5.1V Zener; D_SOD-323_HandSoldering; LCSC C18547704
D2, D6: Pink; LED_4014; LCSC C7371931
D3, D8: Cyan; LED_4014; LCSC C7371929
D4, D7: White; LED_4014; LCSC C3646959
J1: Conn_01x05_Socket
J2: Probe Needle; ProbeNeedle
J7: ProbeJack; STX_3452_TRRRS_Audio_Jack
JP1, JP2: SolderJumper_2_Bridged; SolderJumper_2_Bridged_Small
JP3: GND; SolderJumper_2_Bridged_Small
JP4: ADC; SolderJumper_2_Bridged_Small
JP5: GP2; SolderJumper_2_Bridged_Small
JP6: BUT; SolderJumper_2_Bridged_Small
JP7: PRO; SolderJumper_2_Bridged_Small
JP8: Current Limit Bypass; SolderJumper_2_Bridged_Small
JP9: SolderJumper_3_Bridged12; SolderJumper-3_P1.3mm_Bridged12_Pad1.0x1.5mm
R1: 0R; R_0603_1608Metric_Pad0.98x0.95mm_HandSolder
R2, R3: 47R; R_0603_1608Metric_Pad0.98x0.95mm_HandSolder; LCSC Part # C2907043
SW1: Disconnect; TS6634_Tact_Switch; LCSC C557614
SW3: Connect; TS6634_Tact_Switch; LCSC C557614
SW4: SW_DPDT_x2; XKB_SK3245S-L3-A_DPDT_Slide_Switch; LCSC C405952
TP1: Dout; TestPoint_D0.75mm
TP2: Set; TestPoint_D0.75mm
TP3: Din; TestPoint_D0.75mm
TP4, TP10: Gnd; TestPoint_D0.75mm
TP5, TP11: Routable_Buffer_in; TestPoint_D0.75mm
TP6: LED_out_probe; TestPoint_D0.75mm
TP7, TP12: Probe_Button; TestPoint_D0.75mm
TP8, TP13: Probe_Probe; TestPoint_D0.75mm
TP14: Pink; SolderJumper_2_Bridged_Small
TP15: White; SolderJumper_2_Bridged_Small
TP16: Cyan; SolderJumper_2_Bridged_Small
U1: WS2811; SOP-8_3.9x4.9mm_P1.27mm; LCSC C114581

Connections:
+3V3: C1.1, D2.2 (A), D3.2 (A), D4.2 (A), D6.2 (A), D7.2 (A), D8.2 (A), SW4.5 (B), U1.8 (VDD); also elsewhere on the board
GND: C1.2, JP3.1 (A), JP9.1 (A), R3.1, TP4.1, TP10.1, U1.4 (GND); also elsewhere on the board
LED_OUT_PROBE: JP5.1 (A), TP3.1, TP6.1, U1.6 (DIN); also elsewhere on the board
unnamed: D1.2 (A), D5.2 (A)
unnamed: D1.1 (K), JP1.1 (A)
unnamed: D2.1 (K), D6.1 (K), TP14.1 (A)
unnamed: D3.1 (K), D8.1 (K), TP16.2 (B)
unnamed: D4.1 (K), D7.1 (K), TP15.2 (B)
unnamed: D5.1 (K), R3.2
unnamed: J1.1, J7.1 (S), JP3.2 (B)
unnamed: J1.2, J7.5 (R3), JP4.2 (B)
unnamed: J1.3, J7.4 (R2), JP5.2 (B)
unnamed: J1.4, J7.3 (R1), JP6.2 (B)
unnamed: J1.5, J7.2 (T), JP7.2 (B)
unnamed: JP2.1 (A), R1.1, SW4.1 (A)
unnamed: JP4.1 (A), JP8.2 (B), R2.2
unnamed: JP9.2 (C), SW1.2
unnamed: TP14.2 (B), U1.1 (OUTR)
unnamed: TP15.1 (A), U1.2 (OUTG)
unnamed: TP16.1 (A), U1.3 (OUTB)
unnamed: TP1.1, U1.5 (DO)
unnamed: TP2.1, U1.7 (SET)
Probe_Button: JP6.1 (A), SW1.1, SW3.1, TP7.1, TP12.1; also elsewhere on the board
Probe_Probe: JP1.2 (B), JP2.2 (B), JP7.1 (A), R1.2, SW3.2, SW4.6 (C), TP8.1, TP13.1; also elsewhere on the board
Probe_Tip: J2.1, SW4.2 (B)
ROUTABLE_BUFFER_IN: JP8.1 (A), JP9.3 (B), R2.1, SW4.3 (C), SW4.4 (A), TP5.1, TP11.1; also elsewhere on the board

Notes on the sheet:
Probe Button and Probe Probe will swap roles when in Disconnect mode
They will periodically be set to INPUT_PULLDOWN and read so the RP2040 knows which position the switch is in (Routable Buffer will keep it high)
Power from driving Routable Buffer or Probe_Probe high when the other is in use
Routable Buffer In is +-9V tolerant and can be arbitrarily routed to anything
Probe overvoltage protection
Connect Disconnect Measure

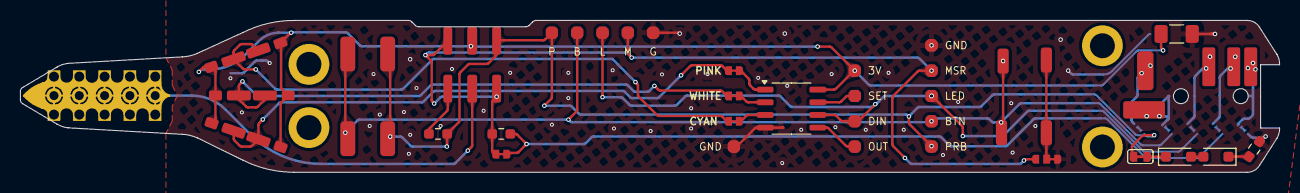
[picture p83: board V5probe.kicad_pcb from above]

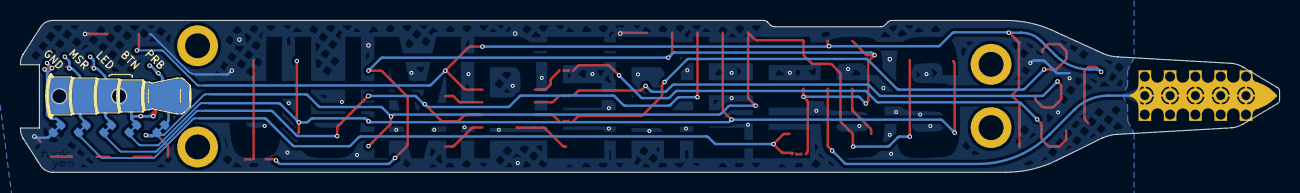
[picture p84: board V5probe.kicad_pcb from below]

Board: 2 copper layers, 126.4 x 15.2 mm, 49 parts (7 on the bottom side), 26 nets.

Other parts of the board:
P1, P2, P3, P4: M1.6_SMT_Screw_Post 3mm Height; M1.6_SMT_Screw_Post
TP3#2, TP9: Din; TestPoint_D0.75mm
TP4#2: Gnd; TestPoint_D0.75mm
TP5#2: Routable_Buffer_in; TestPoint_D0.75mm
TP7#2: Probe_Button; TestPoint_D0.75mm
TP8#2: Probe_Probe; TestPoint_D0.75mm

Their connections:
+3V3: TP9.1; also elsewhere on the board
GND: TP4#2.1; also elsewhere on the board
LED_OUT_PROBE: TP3#2.1; also elsewhere on the board
Probe_Button: TP7#2.1; also elsewhere on the board
Probe_Probe: TP8#2.1; also elsewhere on the board
ROUTABLE_BUFFER_IN: TP5#2.1; also elsewhere on the board
