Architeuthis-Flux/JumperlessV5/Jumperless23V50/V5LEDboard/V5LEDboard.kicad_pcb

## KiCad design Jumperless23V50/V5LEDboard/V5LEDboard.kicad_pcb (2024-12-02)

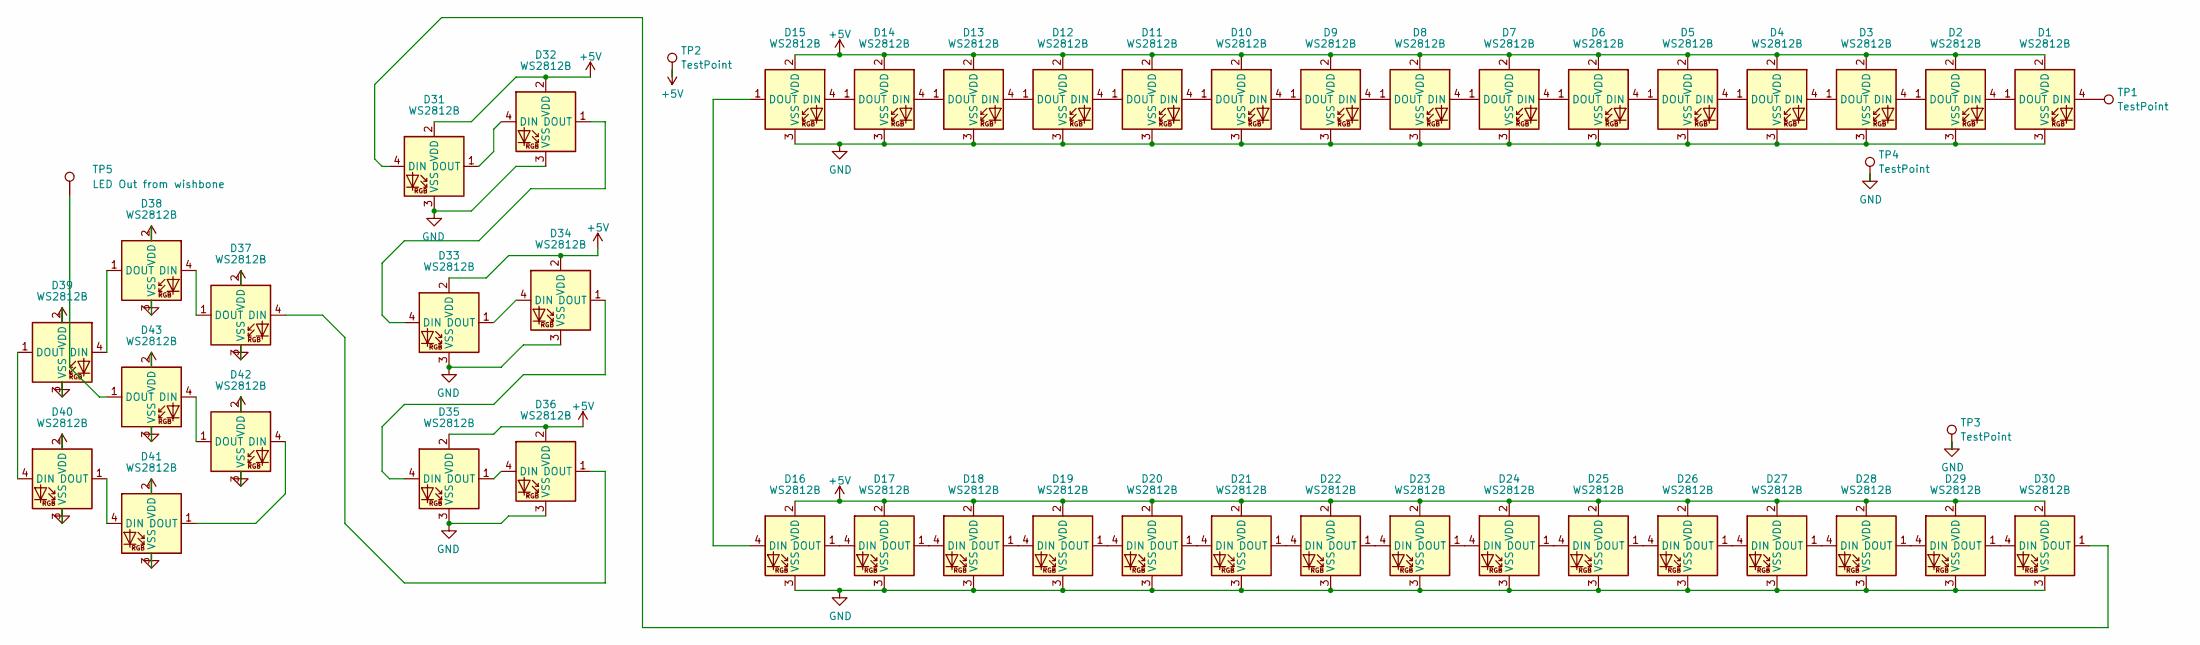
[picture p85: schematic V5LEDboard.kicad_sch]

Parts:
D1, D2, D3, D4, D5, D6, D7, D8, D9, D10, D11, D12, D13, D14, D15, D16, D17, D18, D19, D20, D21, D22, D23, D24, D25, D26, D27, D28, D29, D30, D31, D32, D33, D34, D35, D36, D37, D38, D39, D40, D41, D42, D43: WS2812B; XL-1010RGBC-WS2812B
TP1, TP2, TP3, TP4: TestPoint; PINHEADER-1x1_vertical
TP5: LED Out from wishbone; PINHEADER-1x1_vertical

Connections:
+5V: D1.2 (VDD), D2.2 (VDD), D3.2 (VDD), D4.2 (VDD), D5.2 (VDD), D6.2 (VDD), D7.2 (VDD), D8.2 (VDD), D9.2 (VDD), D10.2 (VDD), D11.2 (VDD), D12.2 (VDD), D13.2 (VDD), D14.2 (VDD), D15.2 (VDD), D16.2 (VDD), D17.2 (VDD), D18.2 (VDD), D19.2 (VDD), D20.2 (VDD), D21.2 (VDD), D22.2 (VDD), D23.2 (VDD), D24.2 (VDD), D25.2 (VDD), D26.2 (VDD), D27.2 (VDD), D28.2 (VDD), D29.2 (VDD), D30.2 (VDD), D31.2 (VDD), D32.2 (VDD), D33.2 (VDD), D34.2 (VDD), D35.2 (VDD), D36.2 (VDD), D37.2 (VDD), D38.2 (VDD), D39.2 (VDD), D40.2 (VDD), D41.2 (VDD), D42.2 (VDD), D43.2 (VDD), TP2.1
GND: D1.3 (VSS), D2.3 (VSS), D3.3 (VSS), D4.3 (VSS), D5.3 (VSS), D6.3 (VSS), D7.3 (VSS), D8.3 (VSS), D9.3 (VSS), D10.3 (VSS), D11.3 (VSS), D12.3 (VSS), D13.3 (VSS), D14.3 (VSS), D15.3 (VSS), D16.3 (VSS), D17.3 (VSS), D18.3 (VSS), D19.3 (VSS), D20.3 (VSS), D21.3 (VSS), D22.3 (VSS), D23.3 (VSS), D24.3 (VSS), D25.3 (VSS), D26.3 (VSS), D27.3 (VSS), D28.3 (VSS), D29.3 (VSS), D30.3 (VSS), D31.3 (VSS), D32.3 (VSS), D33.3 (VSS), D34.3 (VSS), D35.3 (VSS), D36.3 (VSS), D37.3 (VSS), D38.3 (VSS), D39.3 (VSS), D40.3 (VSS), D41.3 (VSS), D42.3 (VSS), D43.3 (VSS), TP3.1, TP4.1
unnamed: D1.4 (DIN), TP1.1
unnamed: D1.1 (DOUT), D2.4 (DIN)
unnamed: D2.1 (DOUT), D3.4 (DIN)
unnamed: D3.1 (DOUT), D4.4 (DIN)
unnamed: D4.1 (DOUT), D5.4 (DIN)
unnamed: D5.1 (DOUT), D6.4 (DIN)
unnamed: D6.1 (DOUT), D7.4 (DIN)
unnamed: D7.1 (DOUT), D8.4 (DIN)
unnamed: D8.1 (DOUT), D9.4 (DIN)
unnamed: D9.1 (DOUT), D10.4 (DIN)
unnamed: D10.1 (DOUT), D11.4 (DIN)
unnamed: D11.1 (DOUT), D12.4 (DIN)
unnamed: D12.1 (DOUT), D13.4 (DIN)
unnamed: D13.1 (DOUT), D14.4 (DIN)
unnamed: D14.1 (DOUT), D15.4 (DIN)
unnamed: D15.1 (DOUT), D16.4 (DIN)
unnamed: D16.1 (DOUT), D17.4 (DIN)
unnamed: D17.1 (DOUT), D18.4 (DIN)
unnamed: D18.1 (DOUT), D19.4 (DIN)
unnamed: D19.1 (DOUT), D20.4 (DIN)
unnamed: D20.1 (DOUT), D21.4 (DIN)
unnamed: D21.1 (DOUT), D22.4 (DIN)
unnamed: D22.1 (DOUT), D23.4 (DIN)
unnamed: D23.1 (DOUT), D24.4 (DIN)
unnamed: D24.1 (DOUT), D25.4 (DIN)
unnamed: D25.1 (DOUT), D26.4 (DIN)
unnamed: D26.1 (DOUT), D27.4 (DIN)
unnamed: D27.1 (DOUT), D28.4 (DIN)
unnamed: D28.1 (DOUT), D29.4 (DIN)
unnamed: D29.1 (DOUT), D30.4 (DIN)
unnamed: D30.1 (DOUT), D31.4 (DIN)
unnamed: D31.1 (DOUT), D32.4 (DIN)
unnamed: D32.1 (DOUT), D33.4 (DIN)
unnamed: D33.1 (DOUT), D34.4 (DIN)
unnamed: D34.1 (DOUT), D35.4 (DIN)
unnamed: D35.1 (DOUT), D36.4 (DIN)
unnamed: D36.1 (DOUT), D37.4 (DIN)
unnamed: D37.1 (DOUT), D38.4 (DIN)
unnamed: D38.1 (DOUT), D39.4 (DIN)
unnamed: D39.1 (DOUT), D40.4 (DIN)
unnamed: D40.1 (DOUT), D41.4 (DIN)
unnamed: D41.1 (DOUT), D42.4 (DIN)
unnamed: D42.1 (DOUT), D43.4 (DIN)
unnamed: D43.1 (DOUT), TP5.1

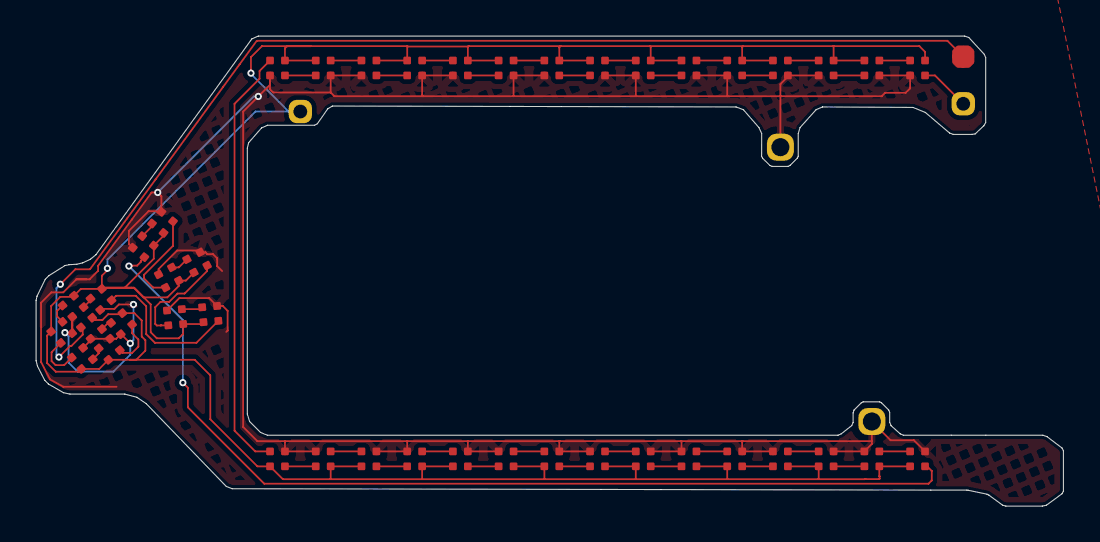
[picture p86: board V5LEDboard.kicad_pcb from above]

Board: 2 copper layers, 57.1 x 26.1 mm, 48 parts (0 on the bottom side), 46 nets.
