Architeuthis-Flux/JumperlessV5/Jumperless23V50/Probe/V5ProbeTop/V5ProbeTop.kicad_pcb

## KiCad design Jumperless23V50/Probe/V5ProbeTop/V5ProbeTop.kicad_pcb (2025-01-12)

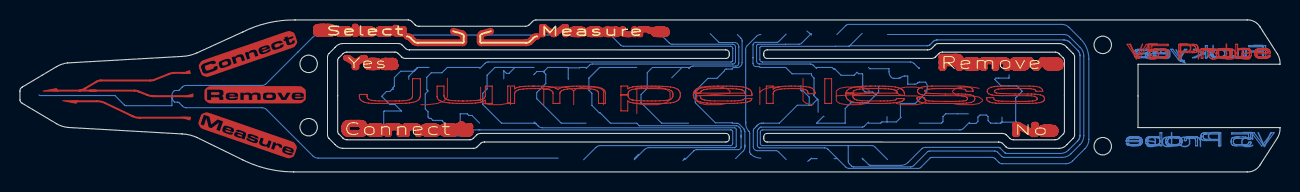
[picture p87: board V5ProbeTop.kicad_pcb from above]

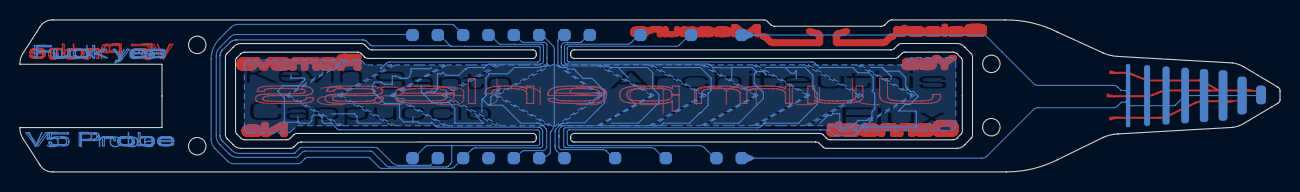
[picture p88: board V5ProbeTop.kicad_pcb from below]

Board: 2 copper layers, 126.4 x 15.2 mm, 30 parts (30 on the bottom side), 14 nets.

Parts:
J1, J2: Conn_01x13_Socket; Probe_capsense_connect
TP1, TP2, TP3, TP4, TP5, TP6, TP7, TP8, TP9, TP10, TP11, TP12, TP13, TP14, TP15, TP16, TP17, TP18, TP19, TP20, TP21, TP22, TP23, TP24, TP25, TP26, TP27, TP28: TestPoint; Tiniest_Possible_pad

Connections:
unnamed: J1.1, J2.1, TP14.1, TP28.1
unnamed: J1.2, J2.2, TP13.1, TP27.1
unnamed: J1.3, J2.3, TP12.1, TP26.1
unnamed: J1.4, J2.4, TP11.1, TP25.1
unnamed: J1.5, J2.5, TP10.1, TP24.1
unnamed: J1.6, J2.6, TP9.1, TP23.1
unnamed: J1.7, J2.7, TP8.1, TP22.1
unnamed: J1.8, J2.8, TP7.1, TP21.1
unnamed: J2.9, TP6.1, TP20.1
unnamed: J1.10, TP5.1, TP19.1
unnamed: J2.11, TP4.1, TP18.1
unnamed: J1.12, TP3.1, TP17.1
unnamed: J2.13, TP2.1, TP16.1
unnamed: J1.14, TP1.1, TP15.1
