Architeuthis-Flux/JumperlessV5/Jumperless23V50/MainBoard/JumperlessV5r6/Jumperless23V50.kicad_sch

## KiCad design Jumperless23V50/MainBoard/JumperlessV5r6/Jumperless23V50.kicad_sch (2026-09-10)

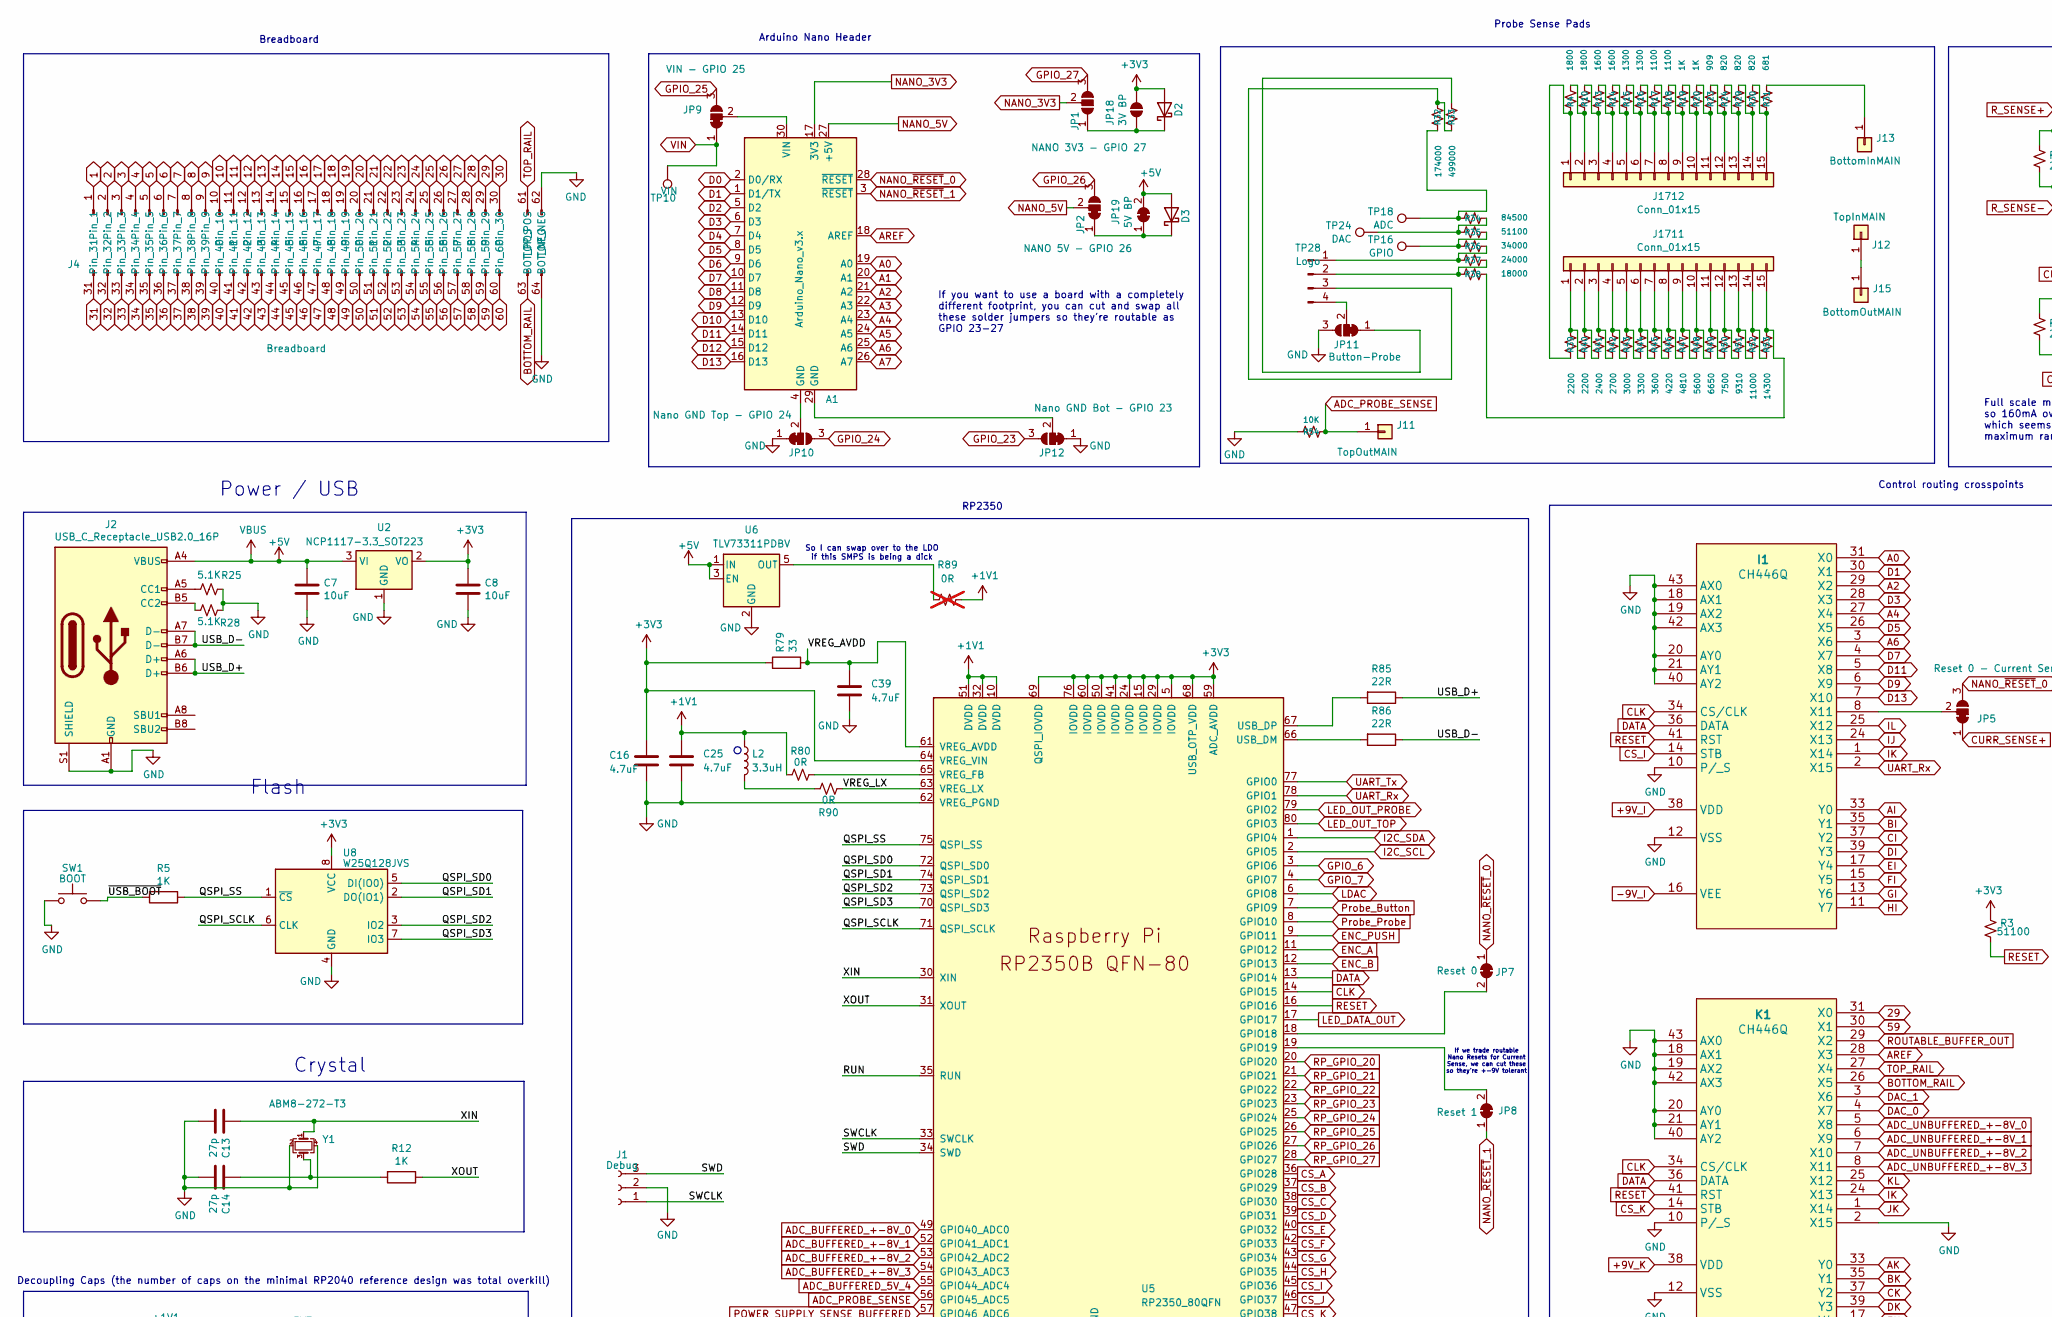
[picture p89: schematic Jumperless23V50.kicad_sch, part in row 1, column 1]

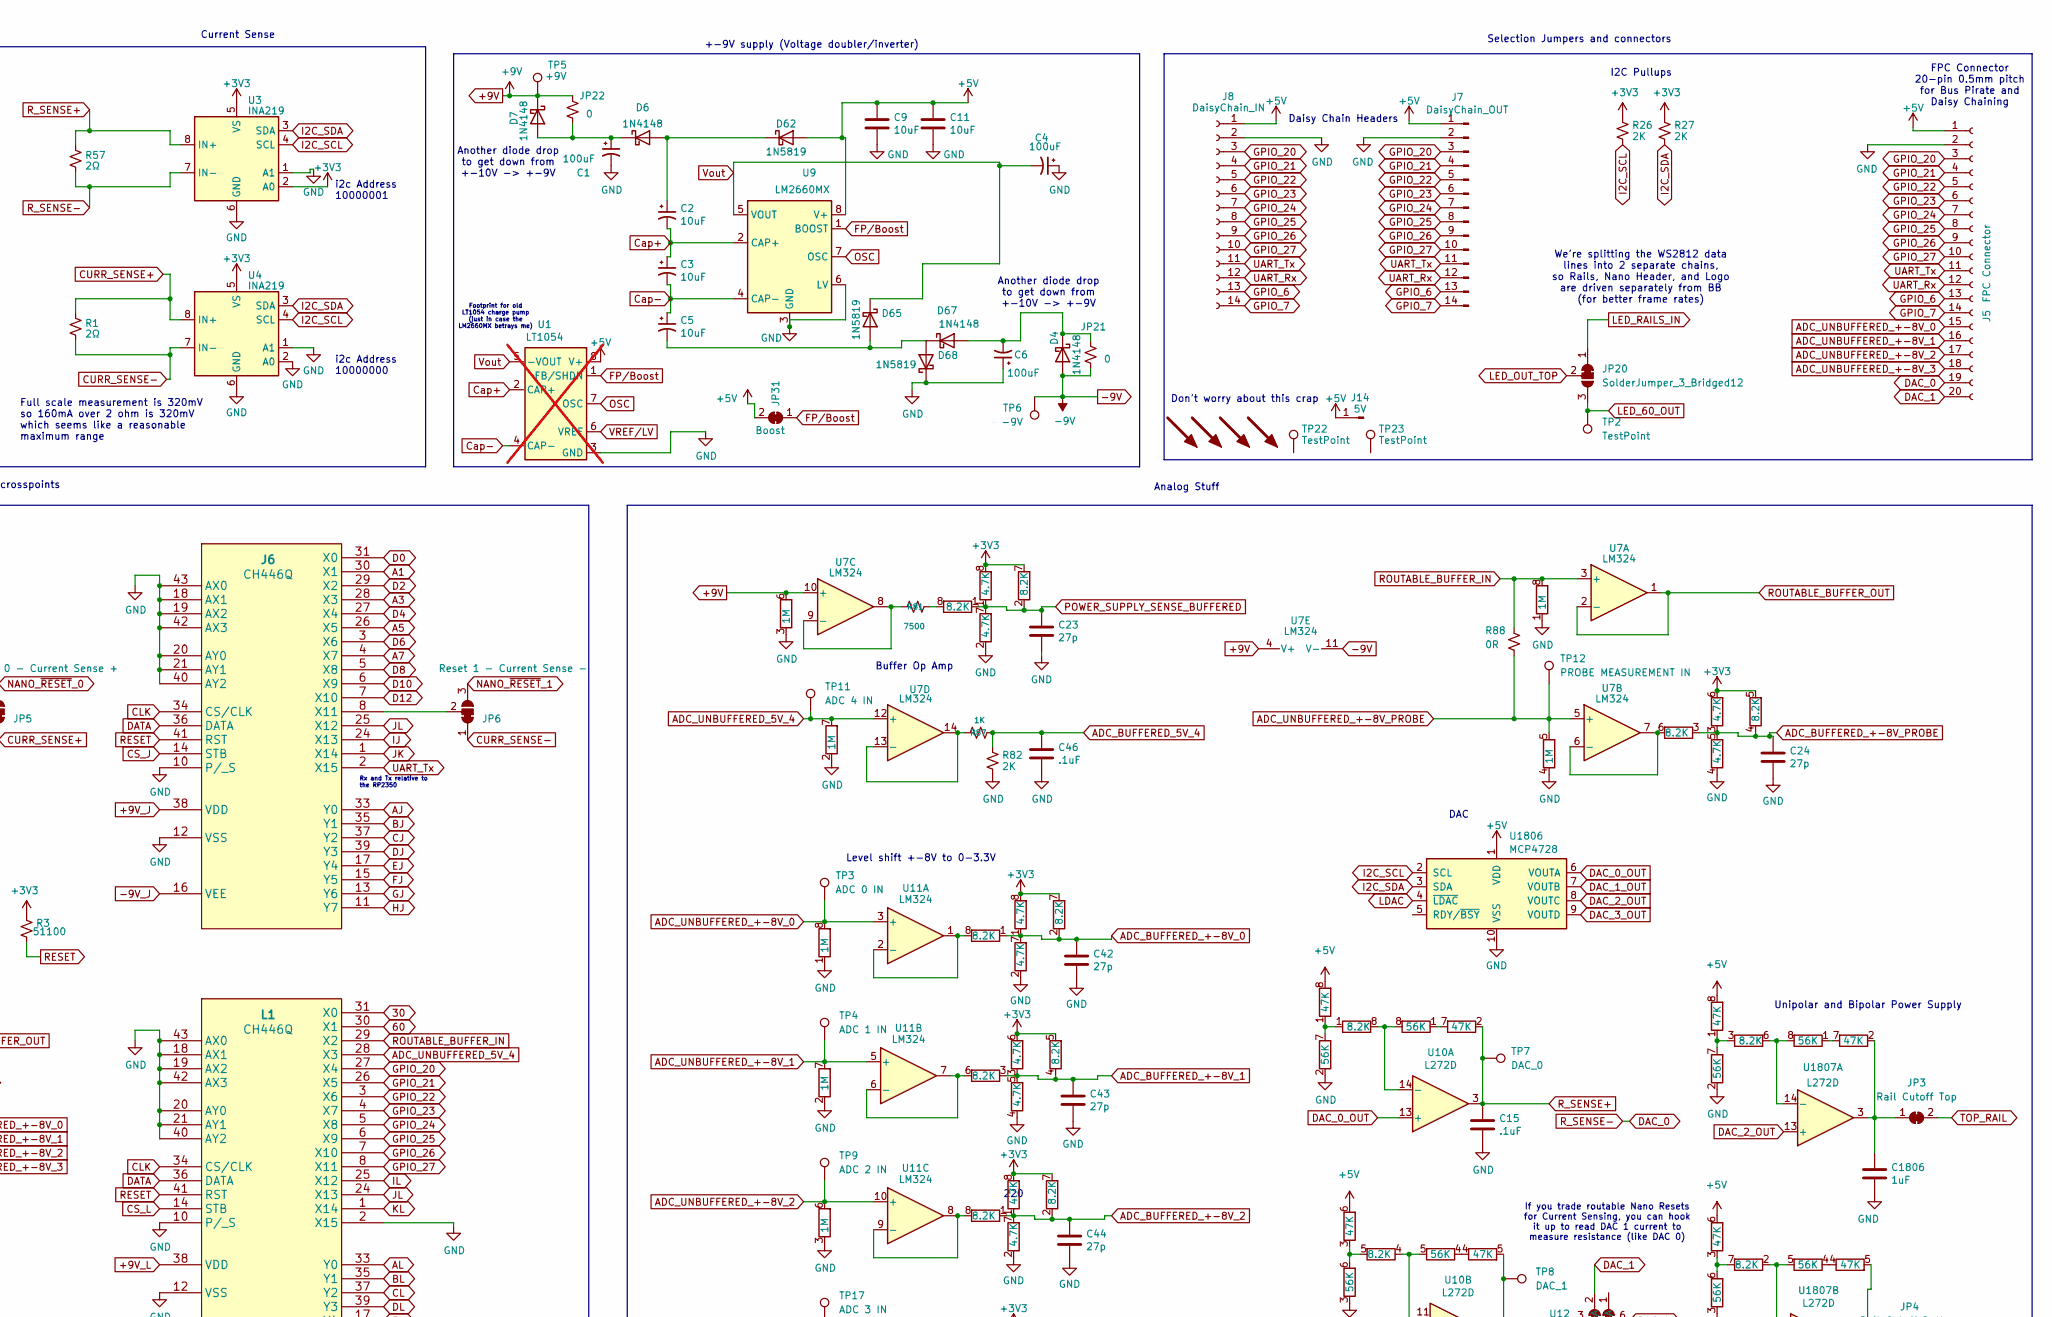
[picture p90: schematic Jumperless23V50.kicad_sch, part in row 1, column 2]

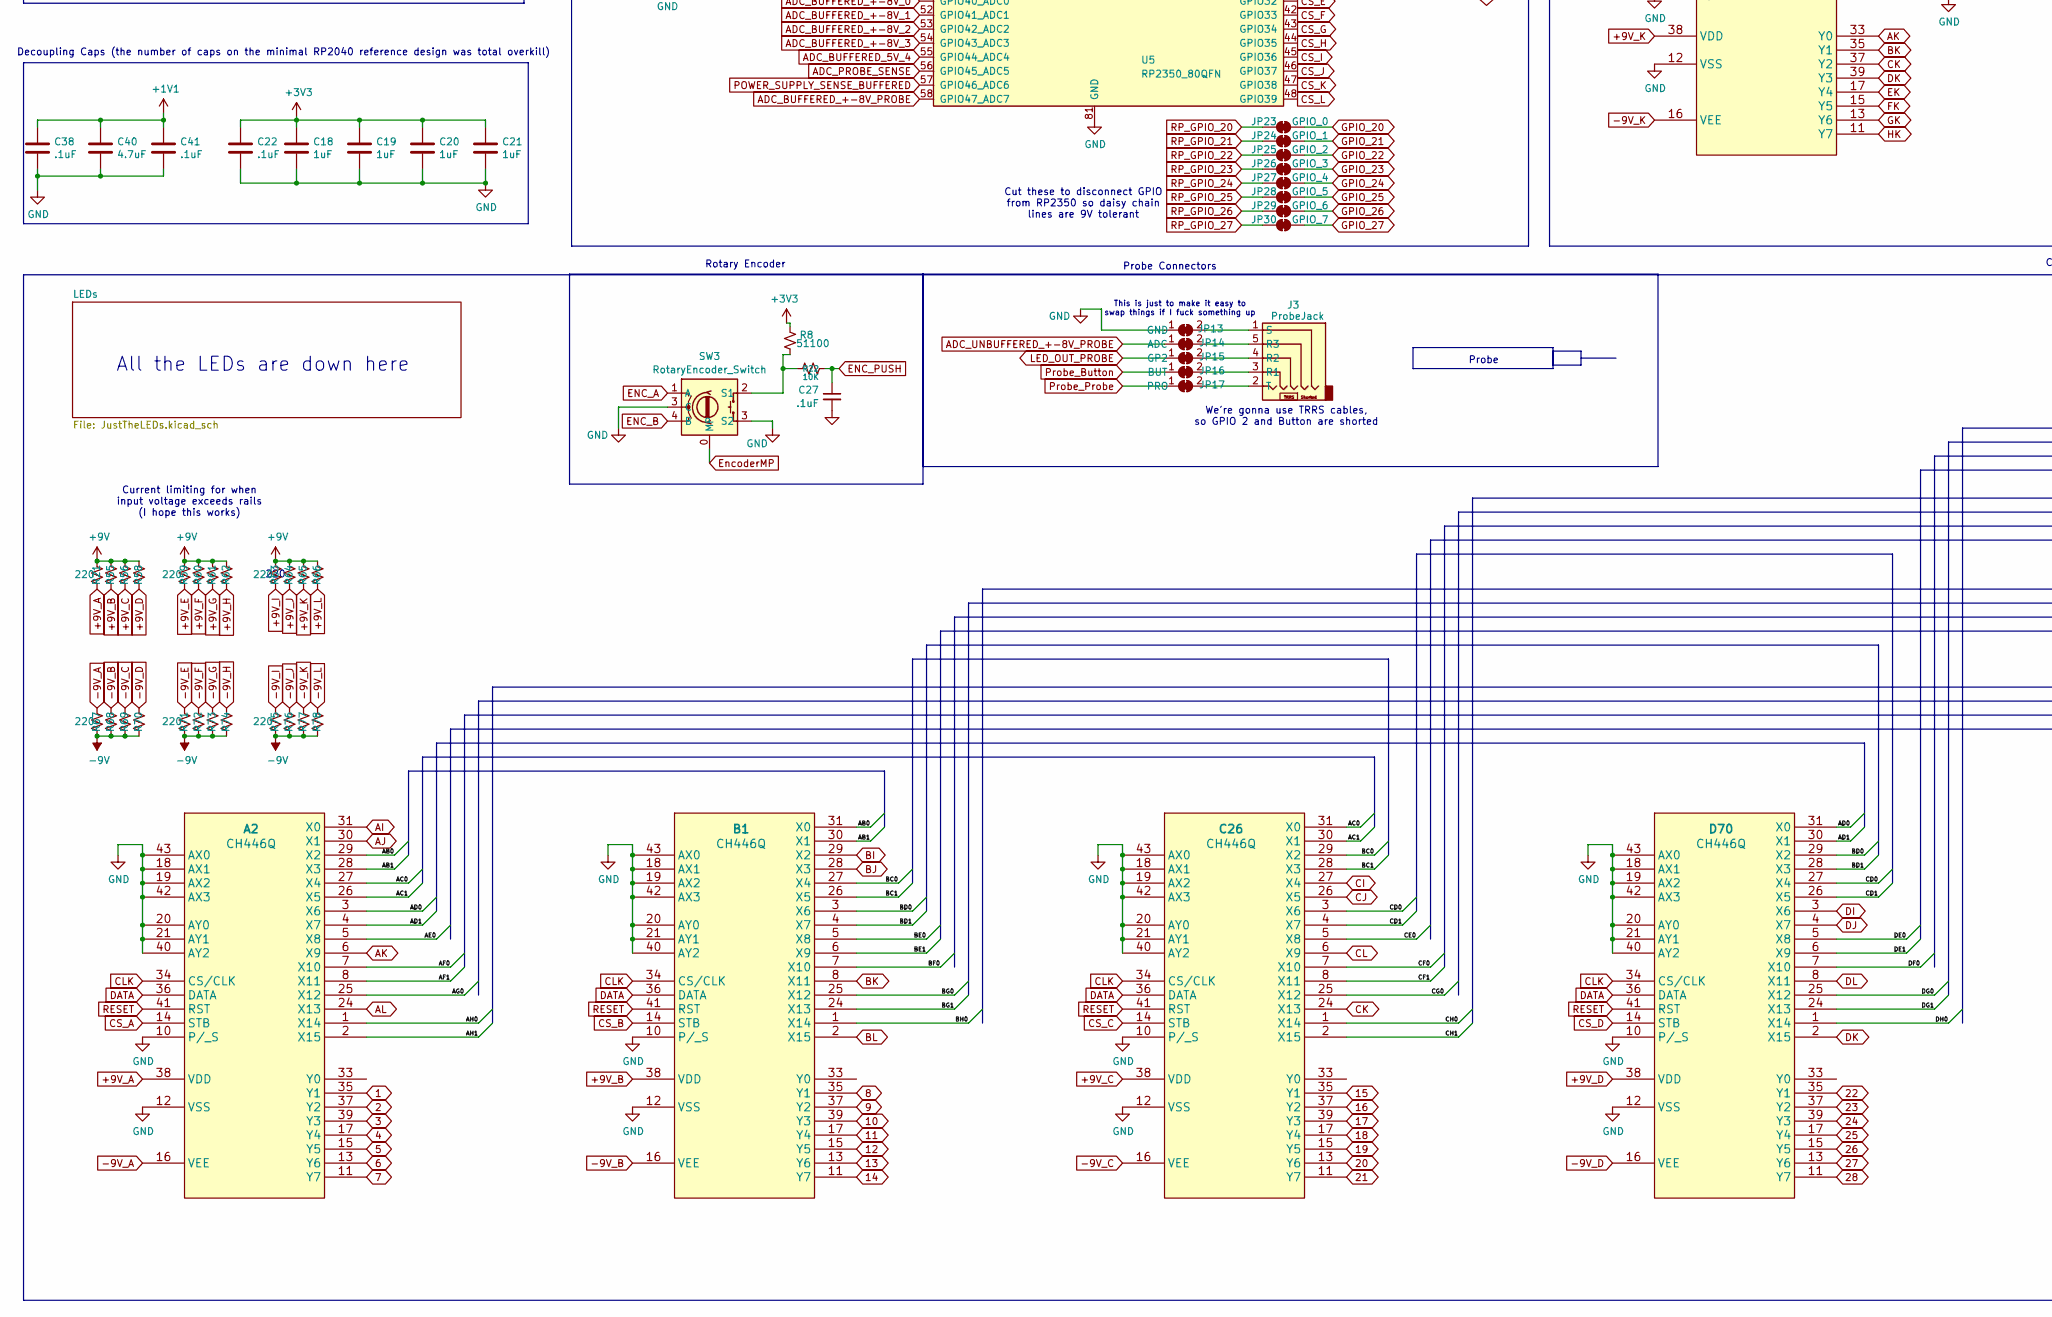
[picture p91: schematic Jumperless23V50.kicad_sch, part in row 2, column 1]

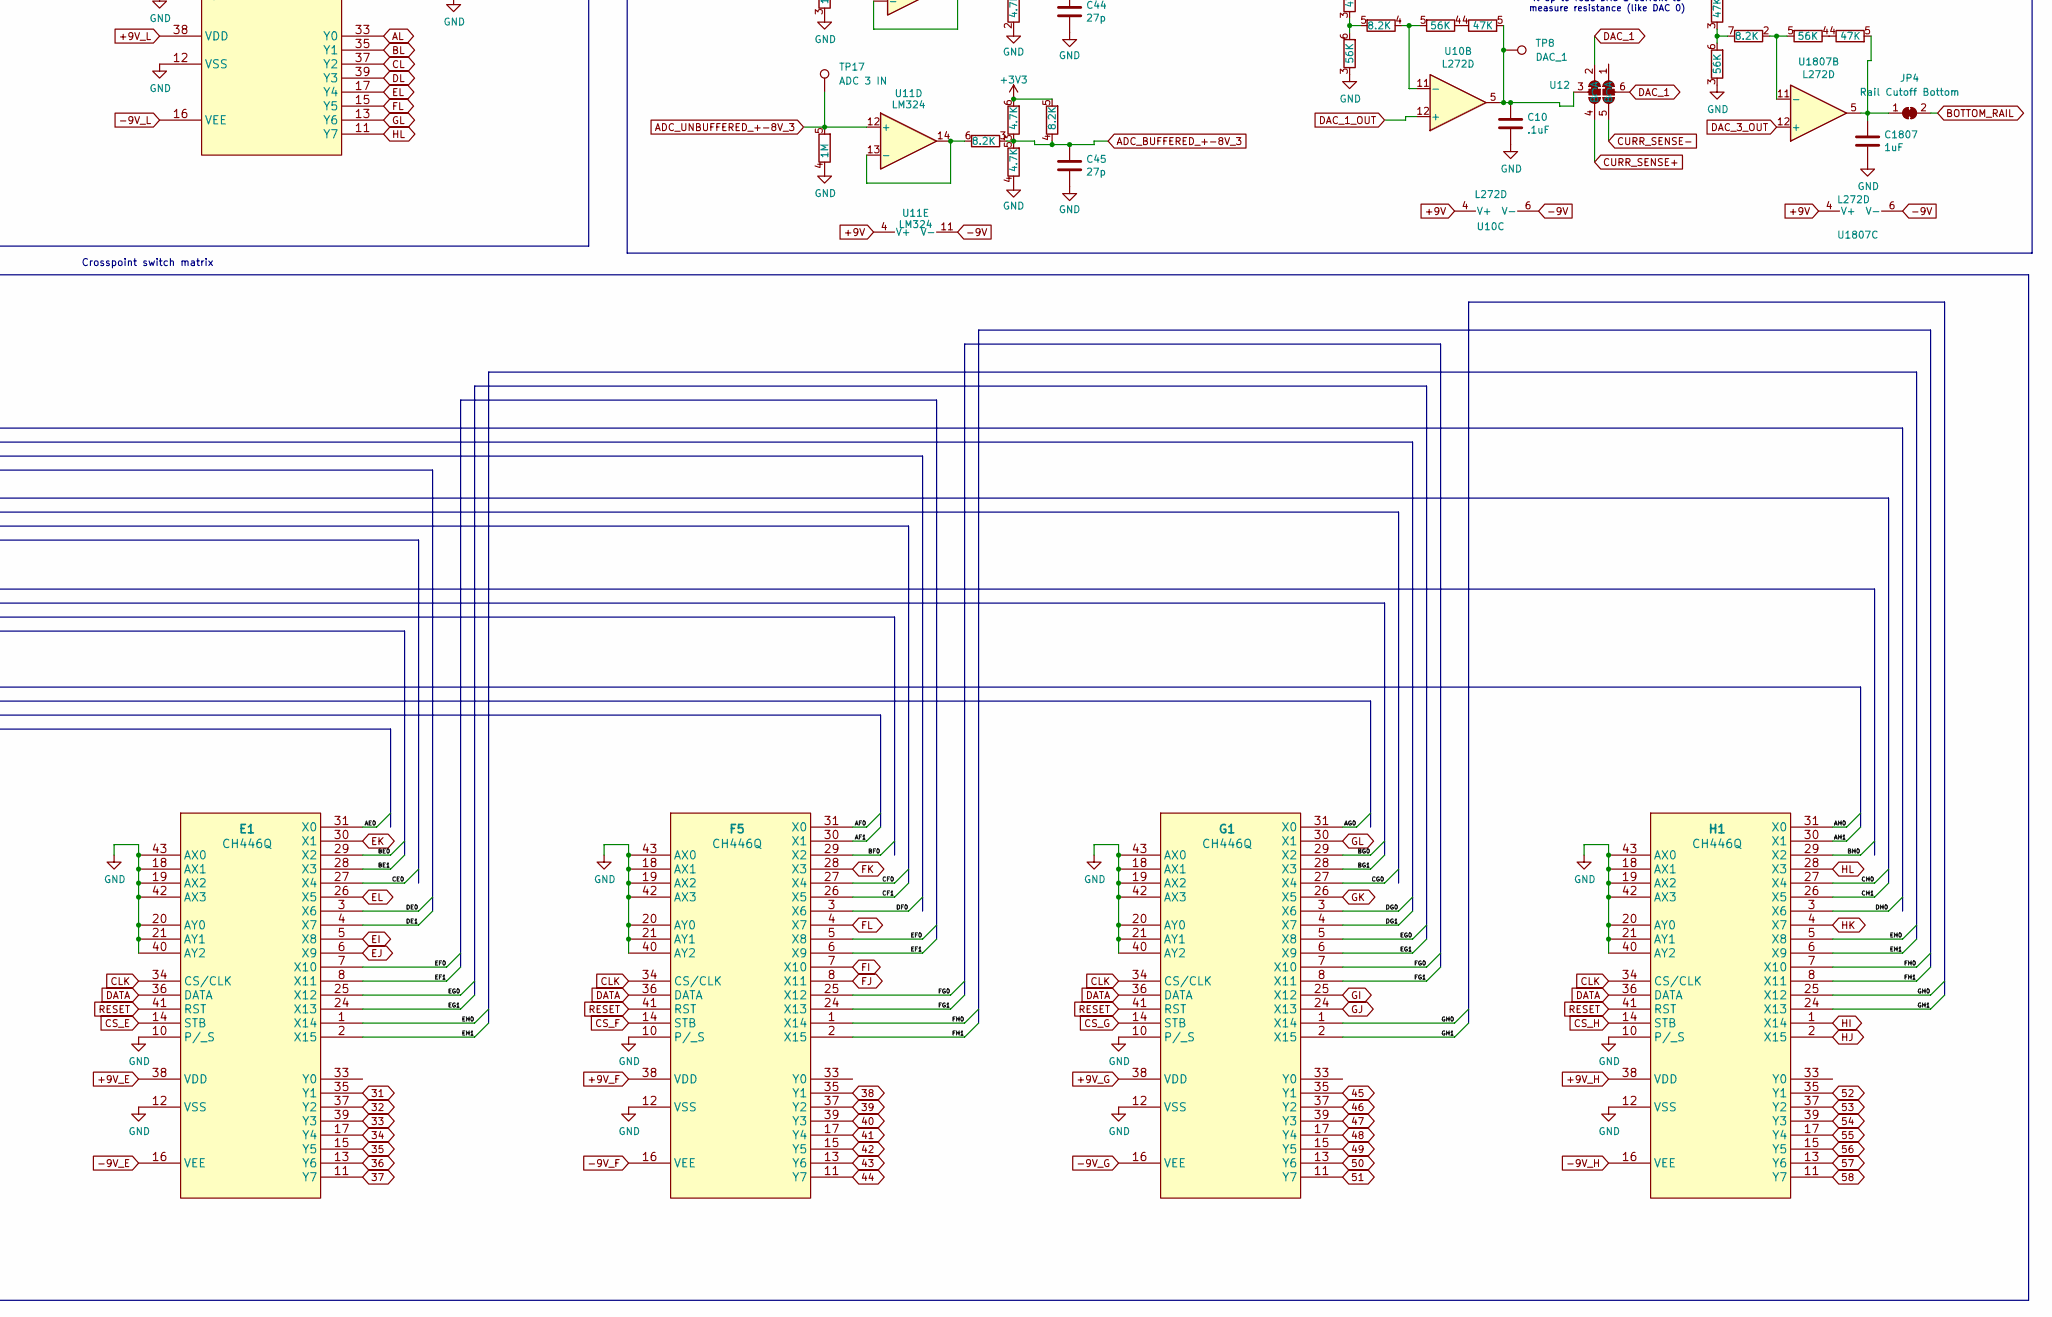
[picture p92: schematic Jumperless23V50.kicad_sch, part in row 2, column 2]

Parts:
A1: Arduino_Nano_v3.x; Arduino_Nano
A2: CH446Q; LQFP44_Tight; LCSC C109471
B1: CH446Q; LQFP44_Tight; LCSC C109471
C1, C4, C6: 100uF; 1210CAP; LCSC C6120014
C2, C3, C5: 10uF; 1210CAP; LCSC C2918502
C7, C8, C9, C11: 10uF; C_0603_1608Metric
C10, C15, C22, C38, C41, C46: .1uF; C_0402_1005Metric
C13, C14, C23, C24, C42, C43, C44, C45: 27p; C_0402_1005Metric
C16, C25, C39, C40: 4.7uF; C_0402_1005Metric
C18, C19, C20, C21, C1806, C1807: 1uF; C_0402_1005Metric
C26: CH446Q; LQFP44_Tight; LCSC C109471
C27: .1uF; C_0402_1005Metric_Pad0.74x0.62mm_HandSolder
D2, D3, D62, D65, D68: 1N5819; D_SOD-323; LCSC C150183
D4, D6, D7, D67: 1N4148; D_SOD-323
D70: CH446Q; LQFP44_Tight
E1: CH446Q; LQFP44_Tight; LCSC C109471
F5: CH446Q; LQFP44_Tight; LCSC C109471
G1: CH446Q; LQFP44_Tight; LCSC C109471
H1: CH446Q; LQFP44_Tight; LCSC C109471
I1: CH446Q; LQFP44_Tight; LCSC C109471
J1: Debug; PinHeader_1x03_P2.54mm_Vertical
J2: USB_C_Receptacle_USB2.0_16P; USB_C_Receptacle_HRO_TYPE-C-31-M-12
J3: ProbeJack; STX_3452_TRRRS_Audio_Jack
J4: Breadboard; Breadboard_CustomClips_CorrectPins_1
J5: FPC Connector; FPC FC05-S20FCT; LCSC Part # C2998828
J6: CH446Q; LQFP44_Tight
J7: DaisyChain_OUT; DaisyChain
J8: DaisyChain_IN; DaisyChain
J11: TopOutMAIN; PinHeader_1x1_Smallest
J12: TopInMAIN; PinHeader_1x1_Smallest
J13: BottomInMAIN; PinHeader_1x1_Smallest
J14: 5V; PINHEADER-1x1_vertical
J15: BottomOutMAIN; PinHeader_1x1_Smallest
J1711: Conn_01x15; NanoProbeBottom
J1712: Conn_01x15; NanoProbeContactsTop
JP1: NANO 3V3 - GPIO 27; SolderJumper-3_P1.3mm_Bridged12_Pad1.0x1.5mm
JP2: NANO 5V - GPIO 26; SolderJumper-3_P1.3mm_Bridged12_Pad1.0x1.5mm
JP3: Rail Cutoff Top; SolderJumper_2_Bridged_Small
JP4: Rail Cutoff Bottom; SolderJumper_2_Bridged_Small
JP5: Reset 0 - Current Sense +; SolderJumper-3_P1.3mm_Bridged12_Pad1.0x1.5mm
JP6: Reset 1 - Current Sense -; SolderJumper-3_P1.3mm_Bridged12_Pad1.0x1.5mm
JP7: Reset 0; SolderJumper_2_Bridged_Small
JP8: Reset 1; SolderJumper_2_Bridged_Small
JP9: VIN - GPIO 25; SolderJumper-3_P1.3mm_Bridged12_Pad1.0x1.5mm
JP10: Nano GND Top - GPIO 24; SolderJumper-3_P1.3mm_Bridged12_Pad1.0x1.5mm
JP11: Button-Probe; SolderJumper-3_P1.3mm_Bridged12_Pad1.0x1.5mm
JP12: Nano GND Bot - GPIO 23; SolderJumper-3_P1.3mm_Bridged12_Pad1.0x1.5mm
JP13: GND; SolderJumper_2_Bridged_Small
JP14: ADC; SolderJumper_2_Bridged_Small
JP15: GP2; SolderJumper_2_Bridged_Small
JP16: BUT; SolderJumper_2_Bridged_Small
JP17: PRO; SolderJumper_2_Bridged_Small
JP18: 3V BP; SolderJumper_2_Bridged_Small
JP19: 5V BP; SolderJumper_2_Bridged_Small
JP20: SolderJumper_3_Bridged12; SolderJumper-3_P1.3mm_Bridged12_Pad1.0x1.5mm
JP21, JP22: 0; R_0603_1608Metric
JP23: GPIO_0; SolderJumper_2_Bridged_Small
JP24: GPIO_1; SolderJumper_2_Bridged_Small
JP25: GPIO_2; SolderJumper_2_Bridged_Small
JP26: GPIO_3; SolderJumper_2_Bridged_Small
JP27: GPIO_4; SolderJumper_2_Bridged_Small
JP28: GPIO_5; SolderJumper_2_Bridged_Small
JP29: GPIO_6; SolderJumper_2_Bridged_Small
JP30: GPIO_7; SolderJumper_2_Bridged_Small
JP31: Boost; SolderJumper_2_Bridged_Small
K1: CH446Q; LQFP44_Tight; LCSC C109471
L1: CH446Q; LQFP44_Tight; LCSC C109471
L2: 3.3uH; L_pol_2016; LCSC C41347751
R1, R57: 2Ω; R_0603_1608Metric; LCSC C445777
R3, R8, R35: 51100; R_0402_1005Metric; LCSC C852827
R4, R10: 1800; R_0402_1005Metric; LCSC C728567
R5, R12, R19, R20, R87: 1K; R_0402_1005Metric; LCSC C852624
R13, R14: 1600; R_0402_1005Metric; LCSC C852616
R15, R16: 1300; R_0402_1005Metric; LCSC C852609
R17, R18: 1100; R_0402_1005Metric; LCSC C852602
R21, R55, R56, R58, R59, R60, R61, R62, R63, R64, R65, R66, R67, R68, R69, R70, R71, R72, R73, R74, R75, R76, R77, R78: 220; R_0402_1005Metric; LCSC C25091
R22, R54: 10K; R_0402_1005Metric; LCSC C190095
R23: 909; R_0402_1005Metric; LCSC C852948
R24, R29, R30: 820; R_0402_1005Metric; LCSC C852926
R25, R28: 5.1K; R_0402_1005Metric; LCSC C853340
R26, R27, R82: 2K; R_0402_1005Metric; LCSC C852711
R31: 681; R_0402_1005Metric; LCSC Part # C852887
R32: 174000; R_0402_1005Metric; LCSC C852565
R33: 499000; R_0402_1005Metric; LCSC C851813
R34: 84500; R_0402_1005Metric; LCSC C852932
R36: 34000; R_0402_1005Metric; LCSC C852733
R37: 24000; R_0402_1005Metric; LCSC C852665
R38: 18000; R_0402_1005Metric; LCSC C852579
R39, R40: 2200; R_0402_1005Metric; LCSC C705646
R41: 2400; R_0402_1005Metric; LCSC C852701
R42: 2700; R_0402_1005Metric; LCSC C852706
R43: 3000; R_0402_1005Metric; LCSC C281777
R44: 3300; R_0402_1005Metric; LCSC C853256
R45: 3600; R_0402_1005Metric; LCSC C852769
R46: 4220; R_0402_1005Metric; LCSC C852814
R47: 4810; R_0402_1005Metric; LCSC C852820
R48: 5600; R_0402_1005Metric; LCSC C852861
R49: 6650; R_0402_1005Metric; LCSC C728562
R50, R81: 7500; R_0402_1005Metric; LCSC C728565
R51: 9310; R_0402_1005Metric; LCSC C852969
R52: 11000; R_0402_1005Metric; LCSC C705064
R53: 14300; R_0402_1005Metric; LCSC C705065
R79: 33; R_0402_1005Metric; LCSC C427231
R80, R88, R90: 0R; R_0402_1005Metric_Pad0.72x0.64mm_HandSolder; LCSC C131359
R85, R86: 22R; R_0402_1005Metric; LCSC C852651
R89: 0R; R_0402_1005Metric_Pad0.72x0.64mm_HandSolder; LCSC C131359; not fitted
RN4, RN8: 47K; R_Array_Convex_4x0402; LCSC C2769517
RN6, RN14, RN17: 4.7K; R_Array_Convex_4x0402; LCSC C620895
RN7, RN12, RN13, RN16: 8.2K; R_Array_Convex_4x0402; LCSC C728757
RN10, RN19: 56K; R_Array_Convex_4x0402; LCSC C728748
RN15, RN18: 1M; R_Array_Convex_4x0402; LCSC C425315
SW1: BOOT; SW_SPST_TL3342; LCSC C22459525
SW3: RotaryEncoder_Switch; SIQ-02FVS3_Rotary_Encoder; LCSC C29780879
TP2: TestPoint; TestPoint_D0.75mm
TP3: ADC 0 IN; TestPoint_D0.75mm
TP4: ADC 1 IN; TestPoint_D0.75mm
TP5: +9V; TestPoint_D0.75mm
TP6: -9V; TestPoint_D0.75mm
TP7: DAC_0; TestPoint_D0.75mm
TP8: DAC_1; TestPoint_D0.75mm
TP9: ADC 2 IN; TestPoint_D0.75mm
TP10: VIN; TestPoint_D0.75mm
TP11: ADC 4 IN; TestPoint_D0.75mm
TP12: PROBE MEASUREMENT IN; TestPoint_D0.75mm
TP16: GPIO; padGPIO75
TP17: ADC 3 IN; TestPoint_D0.75mm
TP18: ADC; padADC75
TP22, TP23: TestPoint; backMaskWindowsNew
TP24: DAC; padDAC75
TP28: Logo
U1: LT1054; DIP8; LCSC C1355744; not fitted
U2: NCP1117-3.3_SOT223; SOT-223-3_TabPin2; LCSC C22462596
U3, U4: INA219; SOIC8; LCSC C138706
U5: RP2350_80QFN; RP2350-QFN-80-1EP_10x10_P0.4mm_EP3.4x3.4mm_ThermalVias
U6: TLV73311PDBV; SOT-23-5; LCSC C2865431
U7, U11: LM324; SOIC-14_3.9x8.7mm_P1.27mm; LCSC C71035
U8: W25Q128JVS; SOIC-8_5.23x5.23mm_P1.27mm; LCSC C97521
U9: LM2660MX; SOIC8; LCSC C183083
U10, U1807: L272D; SOIC-16_3.9x9.9mm_P1.27mm; LCSC C443843
U12: SolderJumper-Double
U1806: MCP4728; MSOP-10_3x3mm_P0.5mm; LCSC C108207
Y1: ABM8-272-T3; Crystal_SMD_3225-4Pin_3.2x2.5mm; LCSC C20625731

Connections:
1: A2.35 (Y1), J4.1
2: A2.37 (Y2), J4.2
3: A2.39 (Y3), J4.3
4: A2.17 (Y4), J4.4
5: A2.15 (Y5), J4.5
6: A2.13 (Y6), J4.6
7: A2.11 (Y7), J4.7
8: B1.35 (Y1), J4.8
9: B1.37 (Y2), J4.9
10: B1.39 (Y3), J4.10
11: B1.17 (Y4), J4.11
12: B1.15 (Y5), J4.12
13: B1.13 (Y6), J4.13
14: B1.11 (Y7), J4.14
15: C26.35 (Y1), J4.15
16: C26.37 (Y2), J4.16
17: C26.39 (Y3), J4.17
18: C26.17 (Y4), J4.18
19: C26.15 (Y5), J4.19
20: C26.13 (Y6), J4.20
21: C26.11 (Y7), J4.21
22: D70.35 (Y1), J4.22
23: D70.37 (Y2), J4.23
24: D70.39 (Y3), J4.24
25: D70.17 (Y4), J4.25
26: D70.15 (Y5), J4.26
27: D70.13 (Y6), J4.27
28: D70.11 (Y7), J4.28
29: J4.29, K1.31 (X0)
30: J4.30, L1.31 (X0)
31: E1.35 (Y1), J4.31
32: E1.37 (Y2), J4.32
33: E1.39 (Y3), J4.33
34: E1.17 (Y4), J4.34
35: E1.15 (Y5), J4.35
36: E1.13 (Y6), J4.36
37: E1.11 (Y7), J4.37
38: F5.35 (Y1), J4.38
39: F5.37 (Y2), J4.39
40: F5.39 (Y3), J4.40
41: F5.17 (Y4), J4.41
42: F5.15 (Y5), J4.42
43: F5.13 (Y6), J4.43
44: F5.11 (Y7), J4.44
45: G1.35 (Y1), J4.45
46: G1.37 (Y2), J4.46
47: G1.39 (Y3), J4.47
48: G1.17 (Y4), J4.48
49: G1.15 (Y5), J4.49
50: G1.13 (Y6), J4.50
51: G1.11 (Y7), J4.51
52: H1.35 (Y1), J4.52
53: H1.37 (Y2), J4.53
54: H1.39 (Y3), J4.54
55: H1.17 (Y4), J4.55
56: H1.15 (Y5), J4.56
57: H1.13 (Y6), J4.57
58: H1.11 (Y7), J4.58
59: J4.59, K1.30 (X1)
60: J4.60, L1.30 (X1)
+1V1: C25.1, C38.1, C40.1, C41.1, L2.1, R80.1, R89.2, U5.10 (DVDD), U5.32 (DVDD), U5.51 (DVDD)
+3V3: C8.1, C16.1, C18.1, C19.1, C20.1, C21.1, C22.1, D2.2 (A), JP18.2 (B), R3.1, R8.1, R26.1, R27.1, R79.1, RN6.6 (R3.2), RN6.8 (R1.2), RN7.5 (R4.2), RN7.7 (R2.2), RN13.5 (R4.2), RN13.7 (R2.2), RN14.6 (R3.2), RN14.8 (R1.2), RN16.5 (R4.2), RN16.7 (R2.2), RN17.6 (R3.2), RN17.8 (R1.2), U2.2 (VO), U3.2 (A0), U3.5 (VS), U4.5 (VS), U5.5 (IOVDD), U5.15 (IOVDD), U5.24 (IOVDD), U5.29 (IOVDD), U5.41 (IOVDD), U5.50 (IOVDD), U5.59 (ADC_AVDD), U5.60 (IOVDD), U5.64 (VREG_VIN), U5.68 (USB_OTP_VDD), U5.69 (QSPI_IOVDD), U5.76 (IOVDD), U8.8 (VCC)
+5V: C7.1, C9.1, C11.1, D3.2 (A), D62.2 (A), J2.A4 (VBUS), J2.A9 (VBUS), J2.B4 (VBUS), J2.B9 (VBUS), J5.1, J7.1, J8.1, J14.1, JP19.2 (B), JP31.2 (B), RN4.6 (R3.2), RN4.8 (R1.2), RN8.6 (R3.2), RN8.8 (R1.2), U1.8 (V+), U2.3 (VI), U6.1 (IN), U6.3 (EN), U9.8 (V+), U1806.1 (VDD)
+9V: D7.1 (K), JP22.1, R21.1, R55.1, R56.1, R58.1, R59.1, R60.1, R61.1, R62.1, R63.1, R64.1, R65.1, R66.1, RN15.6 (R3.2), TP5.1, U7.4 (V+), U7.10 (+), U10.4 (V+), U11.4 (V+), U1807.4 (V+)
+9V_A: A2.38 (VDD), R21.2
+9V_B: B1.38 (VDD), R55.2
+9V_C: C26.38 (VDD), R56.2
+9V_D: D70.38 (VDD), R58.2
+9V_E: E1.38 (VDD), R59.2
+9V_F: F5.38 (VDD), R60.2
+9V_G: G1.38 (VDD), R61.2
+9V_H: H1.38 (VDD), R62.2
+9V_I: I1.38 (VDD), R63.2
+9V_J: J6.38 (VDD), R64.2
+9V_K: K1.38 (VDD), R65.2
+9V_L: L1.38 (VDD), R66.2
-9V: D4.2 (A), JP21.2, R67.2, R68.2, R69.2, R70.2, R71.2, R72.2, R73.2, R74.2, R75.2, R76.2, R77.2, R78.2, TP6.1, U7.11 (V-), U10.6 (V-), U11.11 (V-), U1807.6 (V-)
-9V_A: A2.16 (VEE), R67.1
-9V_B: B1.16 (VEE), R68.1
-9V_C: C26.16 (VEE), R69.1
-9V_D: D70.16 (VEE), R70.1
-9V_E: E1.16 (VEE), R71.1
-9V_F: F5.16 (VEE), R72.1
-9V_G: G1.16 (VEE), R73.1
-9V_H: H1.16 (VEE), R74.1
-9V_I: I1.16 (VEE), R75.1
-9V_J: J6.16 (VEE), R76.1
-9V_K: K1.16 (VEE), R77.1
-9V_L: L1.16 (VEE), R78.1
A0: A1.19 (A0), I1.31 (X0)
A1: A1.20 (A1), J6.30 (X1)
A2: A1.21 (A2), I1.29 (X2)
A3: A1.22 (A3), J6.28 (X3)
A4: A1.23 (A4), I1.27 (X4)
A5: A1.24 (A5), J6.26 (X5)
A6: A1.25 (A6), I1.3 (X6)
A7: A1.26 (A7), J6.4 (X7)
AB0: A2.29 (X2), B1.31 (X0)
AB1: A2.28 (X3), B1.30 (X1)
AC0: A2.27 (X4), C26.31 (X0)
AC1: A2.26 (X5), C26.30 (X1)
AD0: A2.3 (X6), D70.31 (X0)
AD1: A2.4 (X7), D70.30 (X1)
ADC_BUFFERED_5V_4: C46.1, R82.1, R87.2, U5.55 (GPIO44_ADC4)
ADC_BUFFERED_+-8V_0: C42.1, RN13.1 (R1.1), RN13.2 (R2.1), RN14.1 (R1.1), RN14.7 (R2.2), U5.49 (GPIO40_ADC0)
ADC_BUFFERED_+-8V_1: C43.1, RN13.3 (R3.1), RN13.4 (R4.1), RN14.3 (R3.1), RN14.5 (R4.2), U5.52 (GPIO41_ADC1)
ADC_BUFFERED_+-8V_2: C44.1, RN16.1 (R1.1), RN16.2 (R2.1), RN17.1 (R1.1), RN17.7 (R2.2), U5.53 (GPIO42_ADC2)
ADC_BUFFERED_+-8V_3: C45.1, RN16.3 (R3.1), RN16.4 (R4.1), RN17.3 (R3.1), RN17.5 (R4.2), U5.54 (GPIO43_ADC3)
ADC_BUFFERED_+-8V_PROBE: C24.1, RN6.3 (R3.1), RN6.5 (R4.2), RN7.3 (R3.1), RN7.4 (R4.1), U5.58 (GPIO47_ADC7)
ADC_PROBE_SENSE: J11.1, R54.2, U5.56 (GPIO45_ADC5)
ADC_UNBUFFERED_5V_4: L1.28 (X3), RN15.7 (R2.2), TP11.1, U7.12 (+)
ADC_UNBUFFERED_+-8V_0: J5.15, K1.5 (X8), RN18.8 (R1.2), TP3.1, U11.3 (+)
ADC_UNBUFFERED_+-8V_1: J5.16, K1.6 (X9), RN18.7 (R2.2), TP4.1, U11.5 (+)
ADC_UNBUFFERED_+-8V_2: J5.17, K1.7 (X10), RN18.6 (R3.2), TP9.1, U11.10 (+)
ADC_UNBUFFERED_+-8V_3: J5.18, K1.8 (X11), RN18.5 (R4.2), TP17.1, U11.12 (+)
ADC_UNBUFFERED_+-8V_PROBE: JP14.1 (A), R88.2, RN15.5 (R4.2), TP12.1, U7.5 (+)
AE0: A2.5 (X8), E1.31 (X0)
AF0: A2.7 (X10), F5.31 (X0)
AF1: A2.8 (X11), F5.30 (X1)
AG0: A2.25 (X12), G1.31 (X0)
AH0: A2.1 (X14), H1.31 (X0)
AH1: A2.2 (X15), H1.30 (X1)
AI: A2.31 (X0), I1.33 (Y0)
AJ: A2.30 (X1), J6.33 (Y0)
AK: A2.6 (X9), K1.33 (Y0)
AL: A2.24 (X13), L1.33 (Y0)
AREF: A1.18 (AREF), K1.28 (X3)
BC0: B1.27 (X4), C26.29 (X2)
BC1: B1.26 (X5), C26.28 (X3)
BD0: B1.3 (X6), D70.29 (X2)
BD1: B1.4 (X7), D70.28 (X3)
BE0: B1.5 (X8), E1.29 (X2)
BE1: B1.6 (X9), E1.28 (X3)
BF0: B1.7 (X10), F5.29 (X2)
BG0: B1.25 (X12), G1.29 (X2)
BG1: B1.24 (X13), G1.28 (X3)
BH0: B1.1 (X14), H1.29 (X2)
BI: B1.29 (X2), I1.35 (Y1)
BJ: B1.28 (X3), J6.35 (Y1)
BK: B1.8 (X11), K1.35 (Y1)
BL: B1.2 (X15), L1.35 (Y1)
BOTTOM_RAIL: J4.63 (BOT_POS), JP4.2 (B), K1.26 (X5)
CD0: C26.3 (X6), D70.27 (X4)
CD1: C26.4 (X7), D70.26 (X5)
CE0: C26.5 (X8), E1.27 (X4)
CF0: C26.7 (X10), F5.27 (X4)
CF1: C26.8 (X11), F5.26 (X5)
CG0: C26.25 (X12), G1.27 (X4)
CH0: C26.1 (X14), H1.27 (X4)
CH1: C26.2 (X15), H1.26 (X5)
CI: C26.27 (X4), I1.37 (Y2)
CJ: C26.26 (X5), J6.37 (Y2)
CK: C26.24 (X13), K1.37 (Y2)
CL: C26.6 (X9), L1.37 (Y2)
CLK: A2.34 (CS/CLK), B1.34 (CS/CLK), C26.34 (CS/CLK), D70.34 (CS/CLK), E1.34 (CS/CLK), F5.34 (CS/CLK), G1.34 (CS/CLK), H1.34 (CS/CLK), I1.34 (CS/CLK), J6.34 (CS/CLK), K1.34 (CS/CLK), L1.34 (CS/CLK), U5.14 (GPIO15)
CS_A: A2.14 (STB), U5.36 (GPIO28)
CS_B: B1.14 (STB), U5.37 (GPIO29)
CS_C: C26.14 (STB), U5.38 (GPIO30)
CS_D: D70.14 (STB), U5.39 (GPIO31)
CS_E: E1.14 (STB), U5.40 (GPIO32)
CS_F: F5.14 (STB), U5.42 (GPIO33)
CS_G: G1.14 (STB), U5.43 (GPIO34)
CS_H: H1.14 (STB), U5.44 (GPIO35)
CS_I: I1.14 (STB), U5.45 (GPIO36)
CS_J: J6.14 (STB), U5.46 (GPIO37)
CS_K: K1.14 (STB), U5.47 (GPIO38)
CS_L: L1.14 (STB), U5.48 (GPIO39)
CURR_SENSE+: JP5.1 (A), R1.1, U4.8 (IN+), U12.4 (B)
CURR_SENSE-: JP6.1 (A), R1.2, U4.7 (IN-), U12.5 (B)
Cap+: C2.2, C3.1, U1.2 (CAP+), U9.2 (CAP+)
Cap-: C3.2, C5.1, U1.4 (CAP-), U9.4 (CAP-)
D0: A1.2 (D0/RX), J6.31 (X0)
D1: A1.1 (D1/TX), I1.30 (X1)
D2: A1.5 (D2), J6.29 (X2)
D3: A1.6 (D3), I1.28 (X3)
D4: A1.7 (D4), J6.27 (X4)
D5: A1.8 (D5), I1.26 (X5)
D6: A1.9 (D6), J6.3 (X6)
D7: A1.10 (D7), I1.4 (X7)
D8: A1.11 (D8), J6.5 (X8)
D9: A1.12 (D9), I1.6 (X9)
D10: A1.13 (D10), J6.6 (X9)
D11: A1.14 (D11), I1.5 (X8)
D12: A1.15 (D12), J6.7 (X10)
D13: A1.16 (D13), I1.7 (X10)
DAC_0: J5.19, K1.4 (X7), R57.2, U3.7 (IN-)
DAC_0_OUT: U10.13 (+), U1806.6 (VOUTA)
DAC_1: J5.20, K1.3 (X6), U12.2 (A), U12.6 (C)
DAC_1_OUT: U10.12 (+), U1806.7 (VOUTB)
DAC_2_OUT: U1806.8 (VOUTC), U1807.13 (+)
DAC_3_OUT: U1806.9 (VOUTD), U1807.12 (+)
DATA: A2.36 (DATA), B1.36 (DATA), C26.36 (DATA), D70.36 (DATA), E1.36 (DATA), F5.36 (DATA), G1.36 (DATA), H1.36 (DATA), I1.36 (DATA), J6.36 (DATA), K1.36 (DATA), L1.36 (DATA), U5.13 (GPIO14)
DE0: D70.5 (X8), E1.3 (X6)
DE1: D70.6 (X9), E1.4 (X7)
DF0: D70.7 (X10), F5.3 (X6)
DG0: D70.25 (X12), G1.3 (X6)
DG1: D70.24 (X13), G1.4 (X7)
DH0: D70.1 (X14), H1.3 (X6)
DI: D70.3 (X6), I1.39 (Y3)
DJ: D70.4 (X7), J6.39 (Y3)
DK: D70.2 (X15), K1.39 (Y3)
DL: D70.8 (X11), L1.39 (Y3)
EF0: E1.7 (X10), F5.5 (X8)
EF1: E1.8 (X11), F5.6 (X9)
EG0: E1.25 (X12), G1.5 (X8)
EG1: E1.24 (X13), G1.6 (X9)
EH0: E1.1 (X14), H1.5 (X8)
EH1: E1.2 (X15), H1.6 (X9)
EI: E1.5 (X8), I1.17 (Y4)
EJ: E1.6 (X9), J6.17 (Y4)
EK: E1.30 (X1), K1.17 (Y4)
EL: E1.26 (X5), L1.17 (Y4)
ENC_A: SW3.1 (A), U5.11 (GPIO12)
ENC_B: SW3.4 (B), U5.12 (GPIO13)
ENC_PUSH: C27.1, R22.2, U5.9 (GPIO11)
EncoderMP: SW3.0 (MP)
FG0: F5.25 (X12), G1.7 (X10)
FG1: F5.24 (X13), G1.8 (X11)
FH0: F5.1 (X14), H1.7 (X10)
FH1: F5.2 (X15), H1.8 (X11)
FI: F5.7 (X10), I1.15 (Y5)
FJ: F5.8 (X11), J6.15 (Y5)
FK: F5.28 (X3), K1.15 (Y5)
FL: F5.4 (X7), L1.15 (Y5)
FP/Boost: JP31.1 (A), U1.1 (FB/SHDN), U9.1 (BOOST)
GH0: G1.1 (X14), H1.25 (X12)
GH1: G1.2 (X15), H1.24 (X13)
GI: G1.25 (X12), I1.13 (Y6)
GJ: G1.24 (X13), J6.13 (Y6)
GK: G1.26 (X5), K1.13 (Y6)
GL: G1.30 (X1), L1.13 (Y6)
GND: A2.10 (P/_S), A2.12 (VSS), A2.18 (AX1), A2.19 (AX2), A2.20 (AY0), A2.21 (AY1), A2.40 (AY2), A2.42 (AX3), A2.43 (AX0), B1.10 (P/_S), B1.12 (VSS), B1.18 (AX1), B1.19 (AX2), B1.20 (AY0), B1.21 (AY1), B1.40 (AY2), B1.42 (AX3), B1.43 (AX0), C1.2, C4.1, C6.1, C7.2, C8.2, C9.2, C10.2, C11.2, C13.2, C14.2, C15.2, C16.2, C18.2, C19.2, C20.2, C21.2, C22.2, C23.2, C24.2, C25.2, C26.10 (P/_S), C26.12 (VSS), C26.18 (AX1), C26.19 (AX2), C26.20 (AY0), C26.21 (AY1), C26.40 (AY2), C26.42 (AX3), C26.43 (AX0), C27.2, C38.2, C39.2, C40.2, C41.2, C42.2, C43.2, C44.2, C45.2, C46.2, C1806.2, C1807.2, D68.1 (K), D70.10 (P/_S), D70.12 (VSS), D70.18 (AX1), D70.19 (AX2), D70.20 (AY0), D70.21 (AY1), D70.40 (AY2), D70.42 (AX3), D70.43 (AX0), E1.10 (P/_S), E1.12 (VSS), E1.18 (AX1), E1.19 (AX2), E1.20 (AY0), E1.21 (AY1), E1.40 (AY2), E1.42 (AX3), E1.43 (AX0), F5.10 (P/_S), F5.12 (VSS), F5.18 (AX1), F5.19 (AX2), F5.20 (AY0), F5.21 (AY1), F5.40 (AY2), F5.42 (AX3), F5.43 (AX0), G1.10 (P/_S), G1.12 (VSS), G1.18 (AX1), G1.19 (AX2), G1.20 (AY0), G1.21 (AY1), G1.40 (AY2), G1.42 (AX3), G1.43 (AX0), H1.10 (P/_S), H1.12 (VSS), H1.18 (AX1), H1.19 (AX2), H1.20 (AY0), H1.21 (AY1), H1.40 (AY2), H1.42 (AX3), H1.43 (AX0), I1.10 (P/_S), I1.12 (VSS), I1.18 (AX1), I1.19 (AX2), I1.20 (AY0), I1.21 (AY1), I1.40 (AY2), I1.42 (AX3), I1.43 (AX0), J1.2, J2.A1 (GND), J2.A12 (GND), J2.B1 (GND), J2.B12 (GND), J2.S1 (SHIELD), J4.62 (TOP_NEG), J4.64 (BOT_NEG), J5.2, J6.10 (P/_S), J6.12 (VSS), J6.18 (AX1), J6.19 (AX2), J6.20 (AY0), J6.21 (AY1), J6.40 (AY2), J6.42 (AX3), J6.43 (AX0), J7.2, J8.2, JP10.1 (A), JP11.3 (B), JP12.1 (A), JP13.1 (A), K1.2 (X15), K1.10 (P/_S), K1.12 (VSS), K1.18 (AX1), K1.19 (AX2), K1.20 (AY0), K1.21 (AY1), K1.40 (AY2), K1.42 (AX3), K1.43 (AX0), L1.2 (X15), L1.10 (P/_S), L1.12 (VSS), L1.18 (AX1), L1.19 (AX2), L1.20 (AY0), L1.21 (AY1), L1.40 (AY2), L1.42 (AX3), L1.43 (AX0), R25.2, R28.2, R54.1, R82.2, RN6.2 (R2.1), RN6.4 (R4.1), RN10.2 (R2.1), RN10.3 (R3.1), RN14.2 (R2.1), RN14.4 (R4.1), RN15.1 (R1.1), RN15.2 (R2.1), RN15.3 (R3.1), RN15.4 (R4.1), RN17.2 (R2.1), RN17.4 (R4.1), RN18.1 (R1.1), RN18.2 (R2.1), RN18.3 (R3.1), RN18.4 (R4.1), RN19.2 (R2.1), RN19.3 (R3.1), SW1.1, SW3.3 (C), U1.3 (GND), U2.1 (GND), U3.1 (A1), U3.6 (GND), U4.1 (A1), U4.2 (A0), U4.6 (GND), U5.62 (VREG_PGND), U5.81 (GND), U6.2 (GND), U8.4 (GND), U9.3 (GND), U9.6 (LV), U1806.10 (VSS), Y1.2, Y1.4
GPIO_6: J5.13, J7.13, J8.13, U5.3 (GPIO6)
GPIO_7: J5.14, J7.14, J8.14, U5.4 (GPIO7)
GPIO_20: J5.3, J7.3, J8.3, JP23.2 (B), L1.27 (X4)
GPIO_21: J5.4, J7.4, J8.4, JP24.2 (B), L1.26 (X5)
GPIO_22: J5.5, J7.5, J8.5, JP25.2 (B), L1.3 (X6)
GPIO_23: J5.6, J7.6, J8.6, JP12.3 (B), JP26.2 (B), L1.4 (X7)
GPIO_24: J5.7, J7.7, J8.7, JP10.3 (B), JP27.2 (B), L1.5 (X8)
GPIO_25: J5.8, J7.8, J8.8, JP9.3 (B), JP28.2 (B), L1.6 (X9)
GPIO_26: J5.9, J7.9, J8.9, JP2.3 (B), JP29.2 (B), L1.7 (X10)
GPIO_27: J5.10, J7.10, J8.10, JP1.3 (B), JP30.2 (B), L1.8 (X11)
HI: H1.1 (X14), I1.11 (Y7)
HJ: H1.2 (X15), J6.11 (Y7)
HK: H1.4 (X7), K1.11 (Y7)
HL: H1.28 (X3), L1.11 (Y7)
I2C_SCL: R26.2, U3.4 (SCL), U4.4 (SCL), U5.2 (GPIO5), U1806.2 (SCL)
I2C_SDA: R27.2, U3.3 (SDA), U4.3 (SDA), U5.1 (GPIO4), U1806.3 (SDA)
IJ: I1.24 (X13), J6.24 (X13)
IK: I1.1 (X14), K1.24 (X13)
IL: I1.25 (X12), L1.25 (X12)
JK: J6.1 (X14), K1.1 (X14)
JL: J6.25 (X12), L1.24 (X13)
KL: K1.25 (X12), L1.1 (X14)
LDAC: U5.6 (GPIO8), U1806.4 (~LDAC)
LED_60_OUT: JP20.3 (B), TP2.1
LED_DATA_OUT: U5.17 (GPIO17)
LED_OUT_PROBE: JP15.1 (A), U5.79 (GPIO2)
LED_OUT_TOP: JP20.2 (C), U5.80 (GPIO3)
LED_RAILS_IN: JP20.1 (A)
NANO_3V3: A1.17 (3V3), JP1.2 (C)
NANO_5V: A1.27 (+5V), JP2.2 (C)
NANO_~RESET_0: A1.28 (~RESET), JP5.3 (B), JP7.1 (A)
NANO_~RESET_1: A1.3 (~RESET), JP6.3 (B), JP8.1 (A)
unnamed: A1.4 (GND), JP10.2 (C)
unnamed: A1.29 (GND), JP12.2 (C)
unnamed: A1.30 (VIN), JP9.2 (C)
unnamed: C1.1, D6.1 (K), D7.2 (A), JP22.2
unnamed: C2.1, D6.2 (A), D62.1 (K)
unnamed: C5.2, D65.2 (A), D67.1 (K), D68.2 (A)
unnamed: C6.2, D4.1 (K), D67.2 (A), JP21.1
unnamed: C10.1, RN8.5 (R4.2), TP8.1, U10.5, U12.3 (C)
unnamed: C14.1, R12.2, Y1.3
unnamed: C1806.1, JP3.1 (A), RN4.2 (R2.1), U1807.3
unnamed: C1807.1, JP4.1 (A), RN4.5 (R4.2), U1807.5
unnamed: D2.1 (K), JP1.1 (A), JP18.1 (A)
unnamed: D3.1 (K), JP2.1 (A), JP19.1 (A)
unnamed: I1.8 (X11), JP5.2 (C)
unnamed: J2.A5 (CC1), R25.1
unnamed: J2.B5 (CC2), R28.1
unnamed: J3.1 (S), JP13.2 (B)
unnamed: J3.2 (T), JP17.2 (B)
unnamed: J3.3 (R1), JP16.2 (B)
unnamed: J3.4 (R2), JP15.2 (B)
unnamed: J3.5 (R3), JP14.2 (B)
unnamed: J6.8 (X11), JP6.2 (C)
unnamed: J12.1, J15.1
unnamed: J13.1, R31.1
unnamed: J1711.1, R39.2, R40.1
unnamed: J1711.2, R40.2, R41.1
unnamed: J1711.3, R41.2, R42.1
unnamed: J1711.4, R42.2, R43.1
unnamed: J1711.5, R43.2, R44.1
unnamed: J1711.6, R44.2, R45.1
unnamed: J1711.7, R45.2, R46.1
unnamed: J1711.8, R46.2, R47.1
unnamed: J1711.9, R47.2, R48.1
unnamed: J1711.10, R48.2, R49.1
unnamed: J1711.11, R49.2, R50.1
unnamed: J1711.12, R50.2, R51.1
unnamed: J1711.13, R51.2, R52.1
unnamed: J1711.14, R52.2, R53.1
unnamed: J1711.15, R38.1, R53.2
unnamed: J1712.1, R4.2, R39.1
unnamed: J1712.2, R4.1, R10.2
unnamed: J1712.3, R10.1, R13.2
unnamed: J1712.4, R13.1, R14.2
unnamed: J1712.5, R14.1, R15.2
unnamed: J1712.6, R15.1, R16.2
unnamed: J1712.7, R16.1, R17.2
unnamed: J1712.8, R17.1, R18.2
unnamed: J1712.9, R18.1, R19.2
unnamed: J1712.10, R19.1, R20.2
unnamed: J1712.11, R20.1, R23.2
unnamed: J1712.12, R23.1, R24.2
unnamed: J1712.13, R24.1, R29.2
unnamed: J1712.14, R29.1, R30.2
unnamed: J1712.15, R30.1, R31.2
unnamed: JP7.2 (B), U5.18 (GPIO18)
unnamed: JP8.2 (B), U5.19 (GPIO19)
unnamed: JP11.1 (A), R33.2
unnamed: JP11.2 (C), TP28.4
unnamed: L2.2, R90.1
unnamed: R8.2, R22.1, SW3.2 (S1)
unnamed: R32.1, R34.2, TP18.1
unnamed: R32.2, R33.1, TP28.3
unnamed: R34.1, R35.2, TP24.1
unnamed: R35.1, R36.2, TP16.1
unnamed: R36.1, R37.2, TP28.1
unnamed: R37.1, R38.2, TP28.2
unnamed: R80.2, U5.65 (VREG_FB)
unnamed: R81.1, U7.8, U7.9 (-)
unnamed: R81.2, RN7.8 (R1.2)
unnamed: R85.2, U5.67 (USB_DP)
unnamed: R86.2, U5.66 (USB_DM)
unnamed: R87.1, U7.13 (-), U7.14
unnamed: R89.1, U6.5 (OUT)
unnamed: RN7.6 (R3.2), U7.6 (-), U7.7
unnamed: RN8.7 (R2.2), RN10.1 (R1.1)
unnamed: RN8.4 (R4.1), RN10.4 (R4.1)
unnamed: RN10.5 (R4.2), RN12.4 (R4.1), U10.11 (-)
unnamed: RN8.3 (R3.1), RN10.6 (R3.2), RN12.5 (R4.2)
unnamed: RN8.1 (R1.1), RN10.7 (R2.2), RN12.1 (R1.1)
unnamed: RN10.8 (R1.2), RN12.8 (R1.2), U10.14 (-)
unnamed: RN12.2 (R2.1), RN19.5 (R4.2), U1807.11 (-)
unnamed: RN4.1 (R1.1), RN12.3 (R3.1), RN19.7 (R2.2)
unnamed: RN12.6 (R3.2), RN19.8 (R1.2), U1807.14 (-)
unnamed: RN4.3 (R3.1), RN12.7 (R2.2), RN19.6 (R3.2)
unnamed: RN13.6 (R3.2), U11.6 (-), U11.7
unnamed: RN13.8 (R1.2), U11.1, U11.2 (-)
unnamed: RN16.6 (R3.2), U11.13 (-), U11.14
unnamed: RN16.8 (R1.2), U11.8, U11.9 (-)
unnamed: RN4.7 (R2.2), RN19.1 (R1.1)
unnamed: RN4.4 (R4.1), RN19.4 (R4.1)
OSC: U1.7 (OSC), U9.7 (OSC)
POWER_SUPPLY_SENSE_BUFFERED: C23.1, RN6.1 (R1.1), RN6.7 (R2.2), RN7.1 (R1.1), RN7.2 (R2.1), U5.57 (GPIO46_ADC6)
Probe_Button: JP16.1 (A), U5.7 (GPIO9)
Probe_Probe: JP17.1 (A), U5.8 (GPIO10)
QSPI_SCLK: U5.71 (QSPI_SCLK), U8.6 (CLK)
QSPI_SD0: U5.72 (QSPI_SD0), U8.5 (DI(IO0))
QSPI_SD1: U5.74 (QSPI_SD1), U8.2 (DO(IO1))
QSPI_SD2: U5.73 (QSPI_SD2), U8.3 (IO2)
QSPI_SD3: U5.70 (QSPI_SD3), U8.7 (IO3)
QSPI_SS: R5.1, U5.75 (QSPI_SS), U8.1 (~CS)
RESET: A2.41 (RST), B1.41 (RST), C26.41 (RST), D70.41 (RST), E1.41 (RST), F5.41 (RST), G1.41 (RST), H1.41 (RST), I1.41 (RST), J6.41 (RST), K1.41 (RST), L1.41 (RST), R3.2, U5.16 (GPIO16)
ROUTABLE_BUFFER_IN: L1.29 (X2), R88.1, RN15.8 (R1.2), U7.3 (+)
ROUTABLE_BUFFER_OUT: K1.29 (X2), U7.1, U7.2 (-)
RP_GPIO_20: JP23.1 (A), U5.20 (GPIO20)
RP_GPIO_21: JP24.1 (A), U5.21 (GPIO21)
RP_GPIO_22: JP25.1 (A), U5.22 (GPIO22)
RP_GPIO_23: JP26.1 (A), U5.23 (GPIO23)
RP_GPIO_24: JP27.1 (A), U5.25 (GPIO24)
RP_GPIO_25: JP28.1 (A), U5.26 (GPIO25)
RP_GPIO_26: JP29.1 (A), U5.27 (GPIO26)
RP_GPIO_27: JP30.1 (A), U5.28 (GPIO27)
RUN: U5.35 (RUN)
R_SENSE+: C15.1, R57.1, RN8.2 (R2.1), TP7.1, U3.8 (IN+), U10.3
SWCLK: J1.1, U5.33 (SWCLK)
SWD: J1.3, U5.34 (SWD)
TOP_RAIL: J4.61 (TOP_POS), JP3.2 (B), K1.27 (X4)
UART_Rx: I1.2 (X15), J5.12, J7.12, J8.12, U5.78 (GPIO1)
UART_Tx: J5.11, J6.2 (X15), J7.11, J8.11, U5.77 (GPIO0)
USB_D+: J2.A6 (D+), J2.B6 (D+), R85.1
USB_D-: J2.A7 (D-), J2.B7 (D-), R86.1
VIN: JP9.1 (A), TP10.1
VREF/LV: U1.6 (VREF)
VREG_AVDD: C39.1, R79.2, U5.61 (VREG_AVDD)
VREG_LX: R90.2, U5.63 (VREG_LX)
Vout: C4.2, D65.1 (K), U1.5 (-VOUT), U9.5 (VOUT)
XIN: C13.1, U5.30 (XIN), Y1.1
XOUT: R12.1, U5.31 (XOUT)
~USB_BOOT: R5.2, SW1.2

Notes on the sheet:
Daisy Chain Headers
So I can swap over to the LDO if this SMPS is being a dick
Probe Connectors
Current Sense
Rotary Encoder
If you want to use a board with a completely different footprint, you can cut and swap all these solder jumpers so they're routable as GPIO 23-27
Unipolar and Bipolar Power Supply
Arduino Nano Header
Probe Sense Pads
I2C Pullups
RP2350
Crosspoint switch matrix
Footprint for old LT1054 charge pump (just in case the LM2660MX betrays me)
220
i2c Address 10000000
Probe
If we trade routable Nano Resets for Current Sense, we can cut these so they're +-9V tolerant
Breadboard
Flash
Current limiting for when input voltage exceeds rails (I hope this works)
+-9V supply (Voltage doubler/inverter)
Control routing crosspoints
Crystal
Analog Stuff
We're gonna use TRRS cables, so GPIO 2 and Button are shorted
Buffer Op Amp
Power / USB
i2c Address 10000001
All the LEDs are down here
DAC
FPC Connector 20-pin 0.5mm pitch for Bus Pirate and Daisy Chaining
Rx and Tx relative to the RP2350
Another diode drop to get down from +-10V -> +-9V
Decoupling Caps (the number of caps on the minimal RP2040 reference design was total overkill)
Cut these to disconnect GPIO from RP2350 so daisy chain lines are 9V tolerant
Level shift +-8V to 0-3.3V
Selection Jumpers and connectors
We're splitting the WS2812 data lines into 2 separate chains, so Rails, Nano Header, and Logo are driven separately from BB (for better frame rates)
If you trade routable Nano Resets for Current Sensing, you can hook it up to read DAC 1 current to measure resistance (like DAC 0)
Don't worry about this crap
This is just to make it easy to swap things if I fuck something up
Full scale measurement is 320mV so 160mA over 2 ohm is 320mV which seems like a reasonable maximum range
