Architeuthis-Flux/JumperlessV5/Jumperless23V50/MainBoard/JumperlessV5r7/JustTheLEDs.kicad_sch

## KiCad design Jumperless23V50/MainBoard/JumperlessV5r7/JustTheLEDs.kicad_sch (2026-09-10)

Schematic: JustTheLEDs.kicad_sch

Parts:
C28, C29, C30, C31, C32, C33, C34, C35, C36, C37: 1uF; C_0402_1005Metric
D1011, D1012, D1013, D1014, D1015, D1021, D1022, D1023, D1024, D1025, D1031, D1032, D1033, D1034, D1035, D1041, D1042, D1043, D1044, D1045, D1051, D1052, D1053, D1054, D1055, D1061, D1062, D1063, D1064, D1065, D1071, D1072, D1073, D1074, D1075, D1081, D1082, D1083, D1084, D1085, D1091, D1092, D1093, D1094, D1095, D1101, D1102, D1103, D1104, D1105, D1111, D1112, D1113, D1114, D1115, D1121, D1122, D1123, D1124, D1125, D1131, D1132, D1133, D1134, D1135, D1141, D1142, D1143, D1144, D1145, D1151, D1152, D1153, D1154, D1155, D1161, D1162, D1163, D1164, D1165, D1171, D1172, D1173, D1174, D1175, D1181, D1182, D1183, D1184, D1185, D1191, D1192, D1193, D1194, D1195, D1201, D1202, D1203, D1204, D1205, D1211, D1212, D1213, D1214, D1215, D1221, D1222, D1223, D1224, D1225, D1231, D1232, D1233, D1234, D1235, D1241, D1242, D1243, D1244, D1245, D1251, D1252, D1253, D1254, D1255, D1261, D1262, D1263, D1264, D1265, D1271, D1272, D1273, D1274, D1275, D1281, D1282, D1283, D1284, D1285, D1291, D1292, D1293, D1294, D1295, D1301, D1302, D1303, D1304, D1305, D1311, D1312, D1313, D1314, D1315, D1321, D1322, D1323, D1324, D1325, D1331, D1332, D1333, D1334, D1335, D1341, D1342, D1343, D1344, D1345, D1351, D1352, D1353, D1354, D1355, D1361, D1362, D1363, D1364, D1365, D1371, D1372, D1373, D1374, D1375, D1381, D1382, D1383, D1384, D1385, D1391, D1392, D1393, D1394, D1395, D1401, D1402, D1403, D1404, D1405, D1411, D1412, D1413, D1414, D1415, D1421, D1422, D1423, D1424, D1425, D1431, D1432, D1433, D1434, D1435, D1441, D1442, D1443, D1444, D1445, D1451, D1452, D1453, D1454, D1455, D1461, D1462, D1463, D1464, D1465, D1471, D1472, D1473, D1474, D1475, D1481, D1482, D1483, D1484, D1485, D1491, D1492, D1493, D1494, D1495, D1501, D1502, D1503, D1504, D1505, D1511, D1512, D1513, D1514, D1515, D1521, D1522, D1523, D1524, D1525, D1531, D1532, D1533, D1534, D1535, D1541, D1542, D1543, D1544, D1545, D1551, D1552, D1553, D1554, D1555, D1561, D1562, D1563, D1564, D1565, D1571, D1572, D1573, D1574, D1575, D1581, D1582, D1583, D1584, D1585, D1591, D1592, D1593, D1594, D1595, D1601, D1602, D1603, D1604, D1605, D1611, D1612, D1613, D1614, D1615, D1616, D1617, D1618, D1619, D1620, D1621, D1622, D1623, D1624, D1625, D1626, D1627, D1628, D1629, D1630, D1631, D1632, D1633, D1634, D1635, D1636, D1637, D1638, D1639, D1640, D1641, D1642, D1643, D1644, D1645, D1646, D1647, D1648, D1649, D1650, D1651, D1652, D1653, D1654, D1655, D1656, D1657, D1658, D1659, D1660, D1711, D1712, D1713, D1714, D1715, D1716, D1717, D1718, D1719, D1720, D1721, D1722, D1723, D1724, D1725, D1726, D1727, D1728, D1729, D1730, D1731, D1732, D1733, D1734, D1735, D1736, D1737, D1738, D1739, D1740, D1741, D1742, D1743, D1744, D1745, D1746, D1747, D1748, D1749, D1750, D1751, D1752, D1753, D1754, D1755, D1756, D1757, D1758, D1759, D1760: WS2812B; XL-1010RGBC-WS2812B; LCSC C5349953
TP19, TP25: GND; TestPoint_Pad_D1.0mm
TP20: LED OUT; PINHEADER-1x1_vertical

Connections:
+5V: C28.1, C29.1, C30.1, C31.1, C32.1, C33.1, C34.1, C35.1, C36.1, C37.1, D1011.2 (VDD), D1012.2 (VDD), D1013.2 (VDD), D1014.2 (VDD), D1015.2 (VDD), D1021.2 (VDD), D1022.2 (VDD), D1023.2 (VDD), D1024.2 (VDD), D1025.2 (VDD), D1031.2 (VDD), D1032.2 (VDD), D1033.2 (VDD), D1034.2 (VDD), D1035.2 (VDD), 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
GND: C28.2, C29.2, C30.2, C31.2, C32.2, C33.2, C34.2, C35.2, C36.2, C37.2, D1011.3 (VSS), D1012.3 (VSS), D1013.3 (VSS), D1014.3 (VSS), D1015.3 (VSS), D1021.3 (VSS), D1022.3 (VSS), D1023.3 (VSS), D1024.3 (VSS), D1025.3 (VSS), D1031.3 (VSS), D1032.3 (VSS), D1033.3 (VSS), D1034.3 (VSS), D1035.3 (VSS), 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
LED_60_OUT: D1605.1 (DOUT)
LED_DATA_OUT: D1011.4 (DIN)
LED_RAILS_IN: D1611.4 (DIN)
unnamed: D1011.1 (DOUT), D1012.4 (DIN)
unnamed: D1012.1 (DOUT), D1013.4 (DIN)
unnamed: D1013.1 (DOUT), D1014.4 (DIN)
unnamed: D1014.1 (DOUT), D1015.4 (DIN)
unnamed: D1015.1 (DOUT), D1021.4 (DIN)
unnamed: D1021.1 (DOUT), D1022.4 (DIN)
unnamed: D1022.1 (DOUT), D1023.4 (DIN)
unnamed: D1023.1 (DOUT), D1024.4 (DIN)
unnamed: D1024.1 (DOUT), D1025.4 (DIN)
unnamed: D1025.1 (DOUT), D1031.4 (DIN)
unnamed: D1031.1 (DOUT), D1032.4 (DIN)
unnamed: D1032.1 (DOUT), D1033.4 (DIN)
unnamed: D1033.1 (DOUT), D1034.4 (DIN)
unnamed: D1034.1 (DOUT), D1035.4 (DIN)
unnamed: D1035.1 (DOUT), D1041.4 (DIN)
unnamed: D1041.1 (DOUT), D1042.4 (DIN)
unnamed: D1042.1 (DOUT), D1043.4 (DIN)
unnamed: D1043.1 (DOUT), D1044.4 (DIN)
unnamed: D1044.1 (DOUT), D1045.4 (DIN)
unnamed: D1045.1 (DOUT), D1051.4 (DIN)
unnamed: D1051.1 (DOUT), D1052.4 (DIN)
unnamed: D1052.1 (DOUT), D1053.4 (DIN)
unnamed: D1053.1 (DOUT), D1054.4 (DIN)
unnamed: D1054.1 (DOUT), D1055.4 (DIN)
unnamed: D1055.1 (DOUT), D1061.4 (DIN)
unnamed: D1061.1 (DOUT), D1062.4 (DIN)
unnamed: D1062.1 (DOUT), D1063.4 (DIN)
unnamed: D1063.1 (DOUT), D1064.4 (DIN)
unnamed: D1064.1 (DOUT), D1065.4 (DIN)
unnamed: D1065.1 (DOUT), D1071.4 (DIN)
unnamed: D1071.1 (DOUT), D1072.4 (DIN)
unnamed: D1072.1 (DOUT), D1073.4 (DIN)
unnamed: D1073.1 (DOUT), D1074.4 (DIN)
unnamed: D1074.1 (DOUT), D1075.4 (DIN)
unnamed: D1075.1 (DOUT), D1081.4 (DIN)
unnamed: D1081.1 (DOUT), D1082.4 (DIN)
unnamed: D1082.1 (DOUT), D1083.4 (DIN)
unnamed: D1083.1 (DOUT), D1084.4 (DIN)
unnamed: D1084.1 (DOUT), D1085.4 (DIN)
unnamed: D1085.1 (DOUT), D1091.4 (DIN)
unnamed: D1091.1 (DOUT), D1092.4 (DIN)
unnamed: D1092.1 (DOUT), D1093.4 (DIN)
unnamed: D1093.1 (DOUT), D1094.4 (DIN)
unnamed: D1094.1 (DOUT), D1095.4 (DIN)
unnamed: D1095.1 (DOUT), D1101.4 (DIN)
unnamed: D1101.1 (DOUT), D1102.4 (DIN)
unnamed: D1102.1 (DOUT), D1103.4 (DIN)
unnamed: D1103.1 (DOUT), D1104.4 (DIN)
unnamed: D1104.1 (DOUT), D1105.4 (DIN)
unnamed: D1105.1 (DOUT), D1111.4 (DIN)
unnamed: D1111.1 (DOUT), D1112.4 (DIN)
unnamed: D1112.1 (DOUT), D1113.4 (DIN)
unnamed: D1113.1 (DOUT), D1114.4 (DIN)
unnamed: D1114.1 (DOUT), D1115.4 (DIN)
unnamed: D1115.1 (DOUT), D1121.4 (DIN)
unnamed: D1121.1 (DOUT), D1122.4 (DIN)
unnamed: D1122.1 (DOUT), D1123.4 (DIN)
unnamed: D1123.1 (DOUT), D1124.4 (DIN)
unnamed: D1124.1 (DOUT), D1125.4 (DIN)
unnamed: D1125.1 (DOUT), D1131.4 (DIN)
unnamed: D1131.1 (DOUT), D1132.4 (DIN)
unnamed: D1132.1 (DOUT), D1133.4 (DIN)
unnamed: D1133.1 (DOUT), D1134.4 (DIN)
unnamed: D1134.1 (DOUT), D1135.4 (DIN)
unnamed: D1135.1 (DOUT), D1141.4 (DIN)
unnamed: D1141.1 (DOUT), D1142.4 (DIN)
unnamed: D1142.1 (DOUT), D1143.4 (DIN)
unnamed: D1143.1 (DOUT), D1144.4 (DIN)
unnamed: D1144.1 (DOUT), D1145.4 (DIN)
unnamed: D1145.1 (DOUT), D1151.4 (DIN)
unnamed: D1151.1 (DOUT), D1152.4 (DIN)
unnamed: D1152.1 (DOUT), D1153.4 (DIN)
unnamed: D1153.1 (DOUT), D1154.4 (DIN)
unnamed: D1154.1 (DOUT), D1155.4 (DIN)
unnamed: D1155.1 (DOUT), D1161.4 (DIN)
unnamed: D1161.1 (DOUT), D1162.4 (DIN)
unnamed: D1162.1 (DOUT), D1163.4 (DIN)
unnamed: D1163.1 (DOUT), D1164.4 (DIN)
unnamed: D1164.1 (DOUT), D1165.4 (DIN)
unnamed: D1165.1 (DOUT), D1171.4 (DIN)
unnamed: D1171.1 (DOUT), D1172.4 (DIN)
unnamed: D1172.1 (DOUT), D1173.4 (DIN)
unnamed: D1173.1 (DOUT), D1174.4 (DIN)
unnamed: D1174.1 (DOUT), D1175.4 (DIN)
unnamed: D1175.1 (DOUT), D1181.4 (DIN)
unnamed: D1181.1 (DOUT), D1182.4 (DIN)
unnamed: D1182.1 (DOUT), D1183.4 (DIN)
unnamed: D1183.1 (DOUT), D1184.4 (DIN)
unnamed: D1184.1 (DOUT), D1185.4 (DIN)
unnamed: D1185.1 (DOUT), D1191.4 (DIN)
unnamed: D1191.1 (DOUT), D1192.4 (DIN)
unnamed: D1192.1 (DOUT), D1193.4 (DIN)
unnamed: D1193.1 (DOUT), D1194.4 (DIN)
unnamed: D1194.1 (DOUT), D1195.4 (DIN)
unnamed: D1195.1 (DOUT), D1201.4 (DIN)
unnamed: D1201.1 (DOUT), D1202.4 (DIN)
unnamed: D1202.1 (DOUT), D1203.4 (DIN)
unnamed: D1203.1 (DOUT), D1204.4 (DIN)
unnamed: D1204.1 (DOUT), D1205.4 (DIN)
unnamed: D1205.1 (DOUT), D1211.4 (DIN)
unnamed: D1211.1 (DOUT), D1212.4 (DIN)
unnamed: D1212.1 (DOUT), D1213.4 (DIN)
unnamed: D1213.1 (DOUT), D1214.4 (DIN)
unnamed: D1214.1 (DOUT), D1215.4 (DIN)
unnamed: D1215.1 (DOUT), D1221.4 (DIN)
unnamed: D1221.1 (DOUT), D1222.4 (DIN)
unnamed: D1222.1 (DOUT), D1223.4 (DIN)
unnamed: D1223.1 (DOUT), D1224.4 (DIN)
unnamed: D1224.1 (DOUT), D1225.4 (DIN)
unnamed: D1225.1 (DOUT), D1231.4 (DIN)
unnamed: D1231.1 (DOUT), D1232.4 (DIN)
unnamed: D1232.1 (DOUT), D1233.4 (DIN)
unnamed: D1233.1 (DOUT), D1234.4 (DIN)
unnamed: D1234.1 (DOUT), D1235.4 (DIN)
unnamed: D1235.1 (DOUT), D1241.4 (DIN)
unnamed: D1241.1 (DOUT), D1242.4 (DIN)
unnamed: D1242.1 (DOUT), D1243.4 (DIN)
unnamed: D1243.1 (DOUT), D1244.4 (DIN)
unnamed: D1244.1 (DOUT), D1245.4 (DIN)
unnamed: D1245.1 (DOUT), D1251.4 (DIN)
unnamed: D1251.1 (DOUT), D1252.4 (DIN)
unnamed: D1252.1 (DOUT), D1253.4 (DIN)
unnamed: D1253.1 (DOUT), D1254.4 (DIN)
unnamed: D1254.1 (DOUT), D1255.4 (DIN)
unnamed: D1255.1 (DOUT), D1261.4 (DIN)
unnamed: D1261.1 (DOUT), D1262.4 (DIN)
unnamed: D1262.1 (DOUT), D1263.4 (DIN)
unnamed: D1263.1 (DOUT), D1264.4 (DIN)
unnamed: D1264.1 (DOUT), D1265.4 (DIN)
unnamed: D1265.1 (DOUT), D1271.4 (DIN)
unnamed: D1271.1 (DOUT), D1272.4 (DIN)
unnamed: D1272.1 (DOUT), D1273.4 (DIN)
unnamed: D1273.1 (DOUT), D1274.4 (DIN)
unnamed: D1274.1 (DOUT), D1275.4 (DIN)
unnamed: D1275.1 (DOUT), D1281.4 (DIN)
unnamed: D1281.1 (DOUT), D1282.4 (DIN)
unnamed: D1282.1 (DOUT), D1283.4 (DIN)
unnamed: D1283.1 (DOUT), D1284.4 (DIN)
unnamed: D1284.1 (DOUT), D1285.4 (DIN)
unnamed: D1285.1 (DOUT), D1291.4 (DIN)
unnamed: D1291.1 (DOUT), D1292.4 (DIN)
unnamed: D1292.1 (DOUT), D1293.4 (DIN)
unnamed: D1293.1 (DOUT), D1294.4 (DIN)
unnamed: D1294.1 (DOUT), D1295.4 (DIN)
unnamed: D1295.1 (DOUT), D1301.4 (DIN)
unnamed: D1301.1 (DOUT), D1302.4 (DIN)
unnamed: D1302.1 (DOUT), D1303.4 (DIN)
unnamed: D1303.1 (DOUT), D1304.4 (DIN)
unnamed: D1304.1 (DOUT), D1305.4 (DIN)
unnamed: D1305.1 (DOUT), D1311.4 (DIN)
unnamed: D1311.1 (DOUT), D1312.4 (DIN)
unnamed: D1312.1 (DOUT), D1313.4 (DIN)
unnamed: D1313.1 (DOUT), D1314.4 (DIN)
unnamed: D1314.1 (DOUT), D1315.4 (DIN)
unnamed: D1315.1 (DOUT), D1321.4 (DIN)
unnamed: D1321.1 (DOUT), D1322.4 (DIN)
unnamed: D1322.1 (DOUT), D1323.4 (DIN)
unnamed: D1323.1 (DOUT), D1324.4 (DIN)
unnamed: D1324.1 (DOUT), D1325.4 (DIN)
unnamed: D1325.1 (DOUT), D1331.4 (DIN)
unnamed: D1331.1 (DOUT), D1332.4 (DIN)
unnamed: D1332.1 (DOUT), D1333.4 (DIN)
unnamed: D1333.1 (DOUT), D1334.4 (DIN)
unnamed: D1334.1 (DOUT), D1335.4 (DIN)
unnamed: D1335.1 (DOUT), D1341.4 (DIN)
unnamed: D1341.1 (DOUT), D1342.4 (DIN)
unnamed: D1342.1 (DOUT), D1343.4 (DIN)
unnamed: D1343.1 (DOUT), D1344.4 (DIN)
unnamed: D1344.1 (DOUT), D1345.4 (DIN)
unnamed: D1345.1 (DOUT), D1351.4 (DIN)
unnamed: D1351.1 (DOUT), D1352.4 (DIN)
unnamed: D1352.1 (DOUT), D1353.4 (DIN)
unnamed: D1353.1 (DOUT), D1354.4 (DIN)
unnamed: D1354.1 (DOUT), D1355.4 (DIN)
unnamed: D1355.1 (DOUT), D1361.4 (DIN)
unnamed: D1361.1 (DOUT), D1362.4 (DIN)
unnamed: D1362.1 (DOUT), D1363.4 (DIN)
unnamed: D1363.1 (DOUT), D1364.4 (DIN)
unnamed: D1364.1 (DOUT), D1365.4 (DIN)
unnamed: D1365.1 (DOUT), D1371.4 (DIN)
unnamed: D1371.1 (DOUT), D1372.4 (DIN)
unnamed: D1372.1 (DOUT), D1373.4 (DIN)
unnamed: D1373.1 (DOUT), D1374.4 (DIN)
unnamed: D1374.1 (DOUT), D1375.4 (DIN)
unnamed: D1375.1 (DOUT), D1381.4 (DIN)
unnamed: D1381.1 (DOUT), D1382.4 (DIN)
unnamed: D1382.1 (DOUT), D1383.4 (DIN)
unnamed: D1383.1 (DOUT), D1384.4 (DIN)
unnamed: D1384.1 (DOUT), D1385.4 (DIN)
unnamed: D1385.1 (DOUT), D1391.4 (DIN)
unnamed: D1391.1 (DOUT), D1392.4 (DIN)
unnamed: D1392.1 (DOUT), D1393.4 (DIN)
unnamed: D1393.1 (DOUT), D1394.4 (DIN)
unnamed: D1394.1 (DOUT), D1395.4 (DIN)
unnamed: D1395.1 (DOUT), D1401.4 (DIN)
unnamed: D1401.1 (DOUT), D1402.4 (DIN)
unnamed: D1402.1 (DOUT), D1403.4 (DIN)
unnamed: D1403.1 (DOUT), D1404.4 (DIN)
unnamed: D1404.1 (DOUT), D1405.4 (DIN)
unnamed: D1405.1 (DOUT), D1411.4 (DIN)
unnamed: D1411.1 (DOUT), D1412.4 (DIN)
unnamed: D1412.1 (DOUT), D1413.4 (DIN)
unnamed: D1413.1 (DOUT), D1414.4 (DIN)
unnamed: D1414.1 (DOUT), D1415.4 (DIN)
unnamed: D1415.1 (DOUT), D1421.4 (DIN)
unnamed: D1421.1 (DOUT), D1422.4 (DIN)
unnamed: D1422.1 (DOUT), D1423.4 (DIN)
unnamed: D1423.1 (DOUT), D1424.4 (DIN)
unnamed: D1424.1 (DOUT), D1425.4 (DIN)
unnamed: D1425.1 (DOUT), D1431.4 (DIN)
unnamed: D1431.1 (DOUT), D1432.4 (DIN)
unnamed: D1432.1 (DOUT), D1433.4 (DIN)
unnamed: D1433.1 (DOUT), D1434.4 (DIN)
unnamed: D1434.1 (DOUT), D1435.4 (DIN)
unnamed: D1435.1 (DOUT), D1441.4 (DIN)
unnamed: D1441.1 (DOUT), D1442.4 (DIN)
unnamed: D1442.1 (DOUT), D1443.4 (DIN)
unnamed: D1443.1 (DOUT), D1444.4 (DIN)
unnamed: D1444.1 (DOUT), D1445.4 (DIN)
unnamed: D1445.1 (DOUT), D1451.4 (DIN)
unnamed: D1451.1 (DOUT), D1452.4 (DIN)
unnamed: D1452.1 (DOUT), D1453.4 (DIN)
unnamed: D1453.1 (DOUT), D1454.4 (DIN)
unnamed: D1454.1 (DOUT), D1455.4 (DIN)
unnamed: D1455.1 (DOUT), D1461.4 (DIN)
unnamed: D1461.1 (DOUT), D1462.4 (DIN)
unnamed: D1462.1 (DOUT), D1463.4 (DIN)
unnamed: D1463.1 (DOUT), D1464.4 (DIN)
unnamed: D1464.1 (DOUT), D1465.4 (DIN)
unnamed: D1465.1 (DOUT), D1471.4 (DIN)
unnamed: D1471.1 (DOUT), D1472.4 (DIN)
unnamed: D1472.1 (DOUT), D1473.4 (DIN)
unnamed: D1473.1 (DOUT), D1474.4 (DIN)
unnamed: D1474.1 (DOUT), D1475.4 (DIN)
unnamed: D1475.1 (DOUT), D1481.4 (DIN)
unnamed: D1481.1 (DOUT), D1482.4 (DIN)
unnamed: D1482.1 (DOUT), D1483.4 (DIN)
unnamed: D1483.1 (DOUT), D1484.4 (DIN)
unnamed: D1484.1 (DOUT), D1485.4 (DIN)
unnamed: D1485.1 (DOUT), D1491.4 (DIN)
unnamed: D1491.1 (DOUT), D1492.4 (DIN)
unnamed: D1492.1 (DOUT), D1493.4 (DIN)
unnamed: D1493.1 (DOUT), D1494.4 (DIN)
unnamed: D1494.1 (DOUT), D1495.4 (DIN)
unnamed: D1495.1 (DOUT), D1501.4 (DIN)
unnamed: D1501.1 (DOUT), D1502.4 (DIN)
unnamed: D1502.1 (DOUT), D1503.4 (DIN)
unnamed: D1503.1 (DOUT), D1504.4 (DIN)
unnamed: D1504.1 (DOUT), D1505.4 (DIN)
unnamed: D1505.1 (DOUT), D1511.4 (DIN)
unnamed: D1511.1 (DOUT), D1512.4 (DIN)
unnamed: D1512.1 (DOUT), D1513.4 (DIN)
unnamed: D1513.1 (DOUT), D1514.4 (DIN)
unnamed: D1514.1 (DOUT), D1515.4 (DIN)
unnamed: D1515.1 (DOUT), D1521.4 (DIN)
unnamed: D1521.1 (DOUT), D1522.4 (DIN)
unnamed: D1522.1 (DOUT), D1523.4 (DIN)
unnamed: D1523.1 (DOUT), D1524.4 (DIN)
unnamed: D1524.1 (DOUT), D1525.4 (DIN)
unnamed: D1525.1 (DOUT), D1531.4 (DIN)
unnamed: D1531.1 (DOUT), D1532.4 (DIN)
unnamed: D1532.1 (DOUT), D1533.4 (DIN)
unnamed: D1533.1 (DOUT), D1534.4 (DIN)
unnamed: D1534.1 (DOUT), D1535.4 (DIN)
unnamed: D1535.1 (DOUT), D1541.4 (DIN)
unnamed: D1541.1 (DOUT), D1542.4 (DIN)
unnamed: D1542.1 (DOUT), D1543.4 (DIN)
unnamed: D1543.1 (DOUT), D1544.4 (DIN)
unnamed: D1544.1 (DOUT), D1545.4 (DIN)
unnamed: D1545.1 (DOUT), D1551.4 (DIN)
unnamed: D1551.1 (DOUT), D1552.4 (DIN)
unnamed: D1552.1 (DOUT), D1553.4 (DIN)
unnamed: D1553.1 (DOUT), D1554.4 (DIN)
unnamed: D1554.1 (DOUT), D1555.4 (DIN)
unnamed: D1555.1 (DOUT), D1561.4 (DIN)
unnamed: D1561.1 (DOUT), D1562.4 (DIN)
unnamed: D1562.1 (DOUT), D1563.4 (DIN)
unnamed: D1563.1 (DOUT), D1564.4 (DIN)
unnamed: D1564.1 (DOUT), D1565.4 (DIN)
unnamed: D1565.1 (DOUT), D1571.4 (DIN)
unnamed: D1571.1 (DOUT), D1572.4 (DIN)
unnamed: D1572.1 (DOUT), D1573.4 (DIN)
unnamed: D1573.1 (DOUT), D1574.4 (DIN)
unnamed: D1574.1 (DOUT), D1575.4 (DIN)
unnamed: D1575.1 (DOUT), D1581.4 (DIN)
unnamed: D1581.1 (DOUT), D1582.4 (DIN)
unnamed: D1582.1 (DOUT), D1583.4 (DIN)
unnamed: D1583.1 (DOUT), D1584.4 (DIN)
unnamed: D1584.1 (DOUT), D1585.4 (DIN)
unnamed: D1585.1 (DOUT), D1591.4 (DIN)
unnamed: D1591.1 (DOUT), D1592.4 (DIN)
unnamed: D1592.1 (DOUT), D1593.4 (DIN)
unnamed: D1593.1 (DOUT), D1594.4 (DIN)
unnamed: D1594.1 (DOUT), D1595.4 (DIN)
unnamed: D1595.1 (DOUT), D1601.4 (DIN)
unnamed: D1601.1 (DOUT), D1602.4 (DIN)
unnamed: D1602.1 (DOUT), D1603.4 (DIN)
unnamed: D1603.1 (DOUT), D1604.4 (DIN)
unnamed: D1604.1 (DOUT), D1605.4 (DIN)
unnamed: D1611.1 (DOUT), D1612.4 (DIN)
unnamed: D1612.1 (DOUT), D1613.4 (DIN)
unnamed: D1613.1 (DOUT), D1614.4 (DIN)
unnamed: D1614.1 (DOUT), D1615.4 (DIN)
unnamed: D1615.1 (DOUT), D1616.4 (DIN)
unnamed: D1616.1 (DOUT), D1617.4 (DIN)
unnamed: D1617.1 (DOUT), D1618.4 (DIN)
unnamed: D1618.1 (DOUT), D1619.4 (DIN)
unnamed: D1619.1 (DOUT), D1620.4 (DIN)
unnamed: D1620.1 (DOUT), D1621.4 (DIN)
unnamed: D1621.1 (DOUT), D1622.4 (DIN)
unnamed: D1622.1 (DOUT), D1623.4 (DIN)
unnamed: D1623.1 (DOUT), D1624.4 (DIN)
unnamed: D1624.1 (DOUT), D1625.4 (DIN)
unnamed: D1625.1 (DOUT), D1626.4 (DIN)
unnamed: D1626.1 (DOUT), D1627.4 (DIN)
unnamed: D1627.1 (DOUT), D1628.4 (DIN)
unnamed: D1628.1 (DOUT), D1629.4 (DIN)
unnamed: D1629.1 (DOUT), D1630.4 (DIN)
unnamed: D1630.1 (DOUT), D1631.4 (DIN)
unnamed: D1631.1 (DOUT), D1632.4 (DIN)
unnamed: D1632.1 (DOUT), D1633.4 (DIN)
unnamed: D1633.1 (DOUT), D1634.4 (DIN)
unnamed: D1634.1 (DOUT), D1635.4 (DIN)
unnamed: D1635.1 (DOUT), D1636.4 (DIN)
unnamed: D1636.1 (DOUT), D1637.4 (DIN)
unnamed: D1637.1 (DOUT), D1638.4 (DIN)
unnamed: D1638.1 (DOUT), D1639.4 (DIN)
unnamed: D1639.1 (DOUT), D1640.4 (DIN)
unnamed: D1640.1 (DOUT), D1641.4 (DIN)
unnamed: D1641.1 (DOUT), D1642.4 (DIN)
unnamed: D1642.1 (DOUT), D1643.4 (DIN)
unnamed: D1643.1 (DOUT), D1644.4 (DIN)
unnamed: D1644.1 (DOUT), D1645.4 (DIN)
unnamed: D1645.1 (DOUT), D1646.4 (DIN)
unnamed: D1646.1 (DOUT), D1647.4 (DIN)
unnamed: D1647.1 (DOUT), D1648.4 (DIN)
unnamed: D1648.1 (DOUT), D1649.4 (DIN)
unnamed: D1649.1 (DOUT), D1650.4 (DIN)
unnamed: D1650.1 (DOUT), D1651.4 (DIN)
unnamed: D1651.1 (DOUT), D1652.4 (DIN)
unnamed: D1652.1 (DOUT), D1653.4 (DIN)
unnamed: D1653.1 (DOUT), D1654.4 (DIN)
unnamed: D1654.1 (DOUT), D1655.4 (DIN)
unnamed: D1655.1 (DOUT), D1656.4 (DIN)
unnamed: D1656.1 (DOUT), D1657.4 (DIN)
unnamed: D1657.1 (DOUT), D1658.4 (DIN)
unnamed: D1658.1 (DOUT), D1659.4 (DIN)
unnamed: D1659.1 (DOUT), D1660.4 (DIN)
unnamed: D1660.1 (DOUT), D1711.4 (DIN)
unnamed: D1711.1 (DOUT), D1712.4 (DIN)
unnamed: D1712.1 (DOUT), D1713.4 (DIN)
unnamed: D1713.1 (DOUT), D1714.4 (DIN)
unnamed: D1714.1 (DOUT), D1715.4 (DIN)
unnamed: D1715.1 (DOUT), D1716.4 (DIN)
unnamed: D1716.1 (DOUT), D1717.4 (DIN)
unnamed: D1717.1 (DOUT), D1718.4 (DIN)
unnamed: D1718.1 (DOUT), D1719.4 (DIN)
unnamed: D1719.1 (DOUT), D1720.4 (DIN)
unnamed: D1720.1 (DOUT), D1721.4 (DIN)
unnamed: D1721.1 (DOUT), D1722.4 (DIN)
unnamed: D1722.1 (DOUT), D1723.4 (DIN)
unnamed: D1723.1 (DOUT), D1724.4 (DIN)
unnamed: D1724.1 (DOUT), D1725.4 (DIN)
unnamed: D1725.1 (DOUT), D1726.4 (DIN)
unnamed: D1726.1 (DOUT), D1727.4 (DIN)
unnamed: D1727.1 (DOUT), D1728.4 (DIN)
unnamed: D1728.1 (DOUT), D1729.4 (DIN)
unnamed: D1729.1 (DOUT), D1730.4 (DIN)
unnamed: D1730.1 (DOUT), D1731.4 (DIN)
unnamed: D1731.1 (DOUT), D1732.4 (DIN)
unnamed: D1732.1 (DOUT), D1733.4 (DIN)
unnamed: D1733.1 (DOUT), D1734.4 (DIN)
unnamed: D1734.1 (DOUT), D1735.4 (DIN)
unnamed: D1735.1 (DOUT), D1736.4 (DIN)
unnamed: D1736.1 (DOUT), D1737.4 (DIN)
unnamed: D1737.1 (DOUT), D1738.4 (DIN)
unnamed: D1738.1 (DOUT), D1739.4 (DIN)
unnamed: D1739.1 (DOUT), D1740.4 (DIN)
unnamed: D1740.1 (DOUT), D1741.4 (DIN)
unnamed: D1741.1 (DOUT), D1742.4 (DIN)
unnamed: D1742.1 (DOUT), D1743.4 (DIN)
unnamed: D1743.1 (DOUT), D1744.4 (DIN)
unnamed: D1744.1 (DOUT), D1745.4 (DIN)
unnamed: D1745.1 (DOUT), D1746.4 (DIN)
unnamed: D1746.1 (DOUT), D1747.4 (DIN)
unnamed: D1747.1 (DOUT), D1748.4 (DIN)
unnamed: D1748.1 (DOUT), D1749.4 (DIN)
unnamed: D1749.1 (DOUT), D1750.4 (DIN)
unnamed: D1750.1 (DOUT), D1751.4 (DIN)
unnamed: D1751.1 (DOUT), D1752.4 (DIN)
unnamed: D1752.1 (DOUT), D1753.4 (DIN)
unnamed: D1753.1 (DOUT), D1754.4 (DIN)
unnamed: D1754.1 (DOUT), D1755.4 (DIN)
unnamed: D1755.1 (DOUT), D1756.4 (DIN)
unnamed: D1756.1 (DOUT), D1757.4 (DIN)
unnamed: D1757.1 (DOUT), D1758.4 (DIN)
unnamed: D1758.1 (DOUT), D1759.4 (DIN)
unnamed: D1759.1 (DOUT), D1760.4 (DIN)
unnamed: D1760.1 (DOUT), TP20.1

Notes on the sheet:
31 32 33 34 35 36 37 38 39 40 41 42 43 44 45 46 47 48 49 50 51 52 53 54 55 56 57 58 59 60
1 2 3 4 5 6 7 8 9 10 11 12 13 14 15 16 17 18 19 20 21 22 23 24 25 26 27 28 29 30
