Architeuthis-Flux/JumperlessV5/(commit log)

2024-05-22 Changed caps on rail power supplies
    [JumperlessV5hw.kicad_sch, JustTheLEDs.kicad_sch]
2024-05-22 I'm dumb and forgot to route some tracks on the probe sense board
    [ProbeSenseNumbers.kicad_pcb]
2024-06-02 Still fucking around, nothing works
    [ProbeSenseNumbers.kicad_pcb]
2024-06-08 Update README.md to let people know that it's for the current model Jumperless
2024-06-08 Add footprints
    [Breadboard V5 v21.stl]
2024-06-16 Rearranged the schematic for prettyness
    [JumperlessV5hw.kicad_sch, JustTheLEDs.kicad_sch]
2024-07-02 Getting probing to work and a bunch of other stuff
    [JumperlessV5hw.kicad_sch]
2024-07-09 Added 3D board shell files
    [Breadboard V5 v25.3mf, Breadboard V5 v25.stl]
2024-07-09 Added Spring Clip files
    [SpringClips5holes.3mf, SpringClips5holes.step, SpringClips5holes.stl]
2024-07-26 Hackin' away at shit
    [JumperlessV5hw.kicad_sch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]
2024-08-13 Now with RP2350B!
    [Jumperless23V50.kicad_sch, JumperlessV5hw.kicad_sch, JustTheLEDs.kicad_sch, V5LEDboard.kicad_pcb]
2024-08-21 Fixed lockups - added Apps to Menu - routed 23V50
    [Jumperless23V50.kicad_sch, ProbeSenseNumbers.kicad_pcb, V5LEDboard.kicad_pcb, V5LEDboard.step, V5ProbeTop.kicad_pcb]
2024-08-24 pulled out dome debug prints, fixed fab complaints
    [V5LEDboard.kicad_pcb, V5ProbeTop.kicad_pcb]
2024-09-12 Made the probe brighten everything you're about to connect to while selecting
2024-10-22 add updates
    [Jumperless23V50.kicad_sch]
2024-10-26 Added UART to probing, 2nd Serial Port, Removed some legacy garbage, went back to TinyUSB
2024-10-26 fixed voltage scaling
2024-10-26 Allow all 6 ADCs (one of them is the probe) to be connected in probing menu
2024-10-27 reinit Serial1 after checking probe current
2024-10-27 Rails now set to what they were at startup
2024-10-27 moved Serial1 stuff to ArduinoStuff.cpp
2024-10-27 messing with arduino flashing stuff
2024-10-27 allow resetting the Arduino with 'a'
    [ArduinoStuff.cpp, main.cpp]
2024-10-28 removed a print
2024-10-30 Trigger Arduino Nano ESP32 Boot pin correctly
    [ArduinoStuff.cpp, ArduinoStuff.h]
2024-10-31 new schematic
2024-11-18 Add FPC breakout and almost finished V5r4
    [FPCbreakout.kicad_pcb, FPCbreakout.kicad_sch, Jumperless23V50.kicad_sch, JustTheLEDs.kicad_sch]
2024-11-18 Add the rest of the hardware stuff
    [Breadboard V5 v25.3mf, Breadboard V5 v25.stl, JumperlessV5hw.kicad_sch, JustTheLEDs.kicad_sch, clickwheelcapDirSwitchHole.3mf]
2024-11-20 routed V5r4
    [Jumperless23V50.kicad_sch, V5ProbeTop.kicad_pcb, V5ProbeTop.kicad_sch]
2024-11-21 pre-production revision
    [Jumperless23V50.kicad_sch]
2024-12-02 Rev 4 hardware
    [ClickwheelcapRainbowSingle.3mf, ClickwheelcapSingleOneColor.3mf, Jumperless23V50.kicad_sch, ProbeSenseNumbers.kicad_pcb, V5LEDboard.kicad_pcb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]
2025-01-12 Add post campaign update draft
    [Jumperless23V50-B_Cu.gbl, Jumperless23V50-B_Fab.gbr, Jumperless23V50-B_Mask.gbs, Jumperless23V50-B_Paste.gbp, Jumperless23V50-B_Silkscreen.gbo, Jumperless23V50-Edge_Cuts.gm1, Jumperless23V50-F_Fab.gbr, Jumperless23V50-F_Mask.gts]
2025-01-19 Added Persistent revision Defines, Started a calibration function (trigger it with $ for now)
2025-01-20 Calibrates all 4 DACs now and saves the values in flash
2025-01-23 Cleaned/sped up probe current measurement, fixed the inability to switch to slot 0 (duh), screwed around with my ghetto mutex
    [Jumperless23V50.kicad_sch]
2025-01-23 Update fw revision (even though auto update doesn't work on V5 yet)
    [main.cpp]
2025-01-23 deleted older firmware so it's less confusing
    [Jumperless23V50-B_Cu.gbl, Jumperless23V50-B_Fab.gbr, Jumperless23V50-B_Mask.gbs, Jumperless23V50-B_Paste.gbp, Jumperless23V50-B_Silkscreen.gbo, Jumperless23V50-Edge_Cuts.gm1, Jumperless23V50-F_Fab.gbr, Jumperless23V50-F_Mask.gts]
2025-01-26 Fills unused paths with redundant connections for lower on resistance
2025-01-27 Fixed more routing bugs, added animations to probe LEDs, updated menus to reflect the new DAC setup and stuff
    [Commands.cpp, Commands.h, FileParsing.cpp, FileParsing.h, Graphics.cpp, Graphics.h, LEDs.cpp, NetManager.cpp]
2025-02-01 Make paths disconnect without blinking everything off, added routing/stacking options menu, fixed random stuff
    [Breadboard V5 v21.stl, Breadboard V5 v25.3mf, Breadboard V5 v25.stl, Cherry MX.STEP, ClickwheelcapRainbowSingle.3mf, ClickwheelcapSingleOneColor.3mf, DSA_Keycap_CherryMX.step, FPCbreakout.kicad_pcb]
2025-02-01 Made the "only update new paths" thing work (I hope), Added probe current debug flag
2025-02-03 No longer need a trailing comma, made like a million things less wonky, print arbitrary text with #text (if it's longer than 14 chars it'll scroll)
    [Commands.cpp, FileParsing.cpp, Graphics.cpp, Graphics.h, LEDs.cpp, LEDs.h, Menus.cpp, Peripherals.cpp]
2025-02-03 Made menu actually reflect options (I will change these), Calibrate and Scan work from apps menu, added Apps.cpp, added yes/no menu.
2025-02-06 Added some footprints
2025-02-26 add r6 schematic
2025-03-01 made a schematic with everything on one sheet
    [EverythingOnOneSchematic.kicad_pcb, EverythingOnOneSchematic.kicad_sch, FPCbreakout.kicad_pcb, JumperlessV5r6.kicad_sch, JustTheLEDs.kicad_sch, ProbeSenseNumbers.kicad_sch, V5LEDboard.kicad_sch]
2025-03-03 Work with Wokwi's new backend
    [FPCbreakout.kicad_pcb, V5probe.kicad_sch]
2025-03-21 Cleaned up repo, minor firmware stuff
    [Cherry MX.STEP, DSA_Keycap_CherryMX.step, FPCbreakout.kicad_pcb, FPCbreakout.kicad_sch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]
2025-03-29 Add acrylic stand
    [AcrylicStandPart1.dxf, AcrylicStandPart2.dxf, AcrylicStandPart3.dxf, AcrylicStandPart4.dxf, AcrylicStandPart5.dxf, JumperlessAcrylicStand v31.step, JumperlessAcrylicStand v31.stl]
2025-04-09 Made a demo custom app
    [JumperlessV5r6.kicad_sch, JustTheLEDs.kicad_sch]
2025-04-28 Loads config settings from a file instead of EEPROM now!
    [config.txt]
2025-04-29 fixed a bunch of little things
    [ArduinoStuff.cpp, FileParsing.cpp, NetsToChipConnections.cpp, Peripherals.cpp, PersistentStuff.cpp, Probing.cpp, config.h, configManager.cpp]
2025-04-30 GPIOs have an animation when they're floating and show their state, UART lights up when data is flowing, finally renamed files with "RP2040" in them.
2025-05-02 omg Arduino flashing finally works, and uses the DTR lines so it shouldn't be board-specific. It took 3 days for screwing with it for me to finally realize I needed to call USBSer1.flush().
2025-05-03 Made the main menu nicer, added commands to just add or remove nodes (+/-uart_tx-43, 1-2 etc. will work), fixed LED settings menu (try l?, lc, lb)
    [ArduinoStuff.cpp, ArduinoStuff.h, FileParsing.cpp, FileParsing.h, Graphics.cpp, LEDs.cpp, LEDs.h, Menus.cpp]
2025-05-05 Added serial connect on boot and lock config options, refreshPaths(), arduino flashing is solid
2025-05-06 added a menu option that prints the state of every crossbar switch, reduces file operations at startup for a snappier boot.
    [Apps.cpp, ArduinoStuff.cpp, ArduinoStuff.h, CH446Q.cpp, CH446Q.h, Commands.cpp, Commands.h, FileParsing.cpp]
2025-05-08 the first twinkles of OLED support. Still doesn't really *do* anything, but in case someone wants to hack on this unfinished feature, I'm pushing it
    [Apps.cpp, Apps.h, Graphics.cpp, LEDs.cpp, MatrixState.cpp, Menus.cpp, NetManager.cpp, Peripherals.cpp]
2025-05-09 Major release version, (this is what the first batch will ship with loaded) DAC limits, OLED stuff works, brightness settings fixed, config file prints in a cut/pasteable format, added logo bounce ap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
    [Apps.cpp, Apps.h, Commands.cpp, FileParsing.cpp, Graphics.cpp]
2025-05-11 added I2C scan app, added OLED support for probing, fixed a thing where config was setting probe_min and probe_max to 0 causing checkPads() to not work
    [Apps.cpp, Apps.h, Commands.cpp, NetsToChipConnections.cpp, Peripherals.cpp, Peripherals.h, PersistentStuff.cpp, Probing.cpp]
2025-05-16 Color picker and net recoloring (tap a row while not making connections to highlight a net, then tap the top building pad, and pick a color, short press to zoom, hold to confirm)
    [ArduinoStuff.cpp, LEDs.cpp, LEDs.h, Menus.cpp, NetsToChipConnections.cpp, Peripherals.cpp, Peripherals.h, Probing.cpp]
2025-05-20 Some cleanup. fixing tiny detail things with net highlighting
    [Graphics.cpp, Graphics.h, Images.h, JumperlessDefines.h, LEDs.cpp, NetManager.cpp, Peripherals.cpp, Probing.cpp]
2025-05-21 put a timer on checking for USBser1 config changes
2025-05-24 Trying out some weird shit with second serial handling by swapping which core it runs on depending on whether you're busy/waiting for input.
    [JumperlessV5r6.kicad_sch]
2025-05-26 New colorful, live-updating netlist printout
2025-05-30 fixed probe leds, config changes not reading
    [Graphics.cpp, LEDs.cpp, LEDs.h, Menus.cpp, Peripherals.cpp, PersistentStuff.cpp, Probing.cpp, config.h]
2025-06-02 Font support, tons of new OLED stuff, OLED print display to terminal option, better net / node highlighting, live updating highlights
2025-06-04 Fixed routing stuff, found some buffer overflows and stuff like that, put a bunch of stuff in ram back into flash where it belongs, changed #define RP2350B 1 to RP2350A 0 because that's what pico-sdk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
    [CH446Q.cpp, CH446Q.h, FileParsing.cpp, Graphics.cpp, Images.h, JumperlessDefines.h, LEDs.cpp, MatrixState.cpp]
2025-06-05 Totally redid routing, added a dump LEDs to Serial (use `R` to turn it on)
2025-06-05 added show extra menu items, print all named connectable nodes
2025-06-07 fix case for bridge
2025-06-08 Some WIP USB serial shenanigans. Probably don't treat this code as working just yet
    [arduino_cli_config.txt]
2025-06-10 Self updating app! Fixed path stacking adding an extra duplicate, `R` print LEDs to serial works again and is the same as the second serial version, less debug printing garbage
    [arduino_cli_config.txt]
2025-06-11 fixed routing for UART, Fixed path stacking weirdness
    [ArduinoStuff.cpp, NetsToChipConnections.cpp, NetsToChipConnections.h, PersistentStuff.cpp, main.cpp]
2025-06-12 remove unused and redundant platformio.ini config
    - -DARDUINO_ARCH_RP2040 is already set in the platform config: https://github.com/maxgerhardt/platform-raspberrypi/blob/develop/boards/jumperless_v5.json
    - Remove commented out dependency config
2025-06-13 idk I didn't do much
    [Peripherals.cpp]
2025-06-16 Huge update to micropython, automatically imports time, os, math modules (not machine yet but I'll get there), custom types for jumperless module (gpio states print as HIGH/LOW but evaluate as True/F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
    [Apps.cpp, Apps.h, FileParsing.cpp, Graphics.cpp, HelpDocs.cpp, JumperlessMicroPythonAPI.cpp, Menus.cpp, Peripherals.cpp]
2025-06-16 Super tiny fixes to docs
    [HelpDocs.cpp, Python_Proper.cpp, Python_Proper.h]
2025-06-27 filesystem browser, embedded eKilo text editor, auto-cycling rainbow text, routing fixes, style-guide (mostly for claude to use only approved unicode), terminal alternate screen buffer swapping, typi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
    [Apps.cpp, EkiloEditor.cpp, EkiloEditor.h, FilesystemStuff.cpp, FilesystemStuff.h]
2025-06-29 Added mounting as a Mass Storage class (I did a lot with the USB descriptors so now they're named correctly and should appear as /dev/cu.usbmodemJLV5port1)
    [ArduinoStuff.cpp, ArduinoStuff.h, Commands.cpp, FileParsing.cpp, FileParsing.h, FilesystemStuff.cpp, FilesystemStuff.h, HelpDocs.cpp]
2025-07-05 Fixed windows support for interactive mode and Kilo text editor, added GPIO Bus Keeper mode (with its own animation), added python examples (you need to load them in the file manager with `m` once), 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
    [01_dac_basics.py, 02_adc_basics.py, 03_gpio_basics.py, 04_node_connections.py, Apps.cpp, CH446Q.cpp, Commands.cpp, EkiloEditor.cpp]
2025-07-10 We got: python syntax highlighting, inline eKilo editing in the repl with `ctrl + e`, some fixes to multiline mode (but still the ekilo editor is a milion times more stable and you should use that), 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
    [01_dac_basics.py, 02_adc_basics.py, 03_gpio_basics.py, 04_node_connections.py, Apps.cpp, EkiloEditor.cpp, EkiloEditor.h, FileParsing.cpp]
2025-07-12 fix integration between file manager, eKilo, and micropython, oled will reconnect if it's enabled and out unplug it and plug it back in
    [Apps.cpp, EkiloEditor.cpp, FilesystemStuff.cpp, FilesystemStuff.h, Python_Proper.cpp, Python_Proper.h, main.cpp, micropythonExamples.h]
2025-07-12 Added ADC calibration, autodetect new calibration values in config files, removed muddy colors from rainbow, added `force_first_start to completely wipe to factory settings
2025-07-12 Added PWM to micropython and stylophone example.
2025-07-13 Fixed USB mass storage
    [USBfs.cpp, USBfs.h, configManager.cpp, configManager.h, main.cpp]
2025-07-28 Getting logic analyzer support kinda working (init with `w` and run jusleview-BPandJ, connect on JLV5port5 or the last port), made python copy a local instance of the node file so things you do only 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
    [V5probe.kicad_sch]
2025-07-30 Added slow PWM so python you can set PWM down to 0.001Hz, added stop_core2(), send_raw(), sped up CH446Q sending a ton.
2025-08-06 Added decimation mode to the logic analyzer to capture at higher rates than the ADC hardware and do.
2025-08-06 fixing some very minor logic analyzer stuff
    [JulseView.cpp]
2025-08-12 got logic analyzer working in slow mode (there's a limit to how low you can set clock dividers so it's a whole separate thing), fixed some tricky shit with PIO sm allocation, detect inverted DTR puls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
    [Apps.cpp, ArduinoStuff.cpp, CH446Q.cpp, Highlighting.cpp, JulseView.cpp, JulseView.h, JumperlessMicroPythonAPI.cpp, Menus.cpp]
2025-08-14 Fixed Arduino DTR detection, broke the logic analyzer (again), allow yout to run the file manager entirely on the oled by removing the "press enter" block when opened with the clickwheel
    [Apps.cpp, Apps.h, ArduinoStuff.cpp, ArduinoStuff.h, CH446Q.cpp, Debugs.cpp, EkiloEditor.cpp]
2025-08-15 Completely redid the logic analyzer to be waaaaay less crashy
    [CH446Q.cpp, JulseView.cpp, JulseView.h, JumperlessMicroPythonAPI.cpp, LogicAnalyzer.cpp, LogicAnalyzer.h, custom_tusb_config.h, main.cpp]
2025-08-16 Finally got to fix an eratta E9 bug! Now it flips the input enable quickly when a gpio is measured high, which clears the lockup
    [Highlighting.cpp, LEDs.cpp, LogicAnalyzer.cpp, LogicAnalyzer.h, Peripherals.cpp, Peripherals.h, main.cpp]
2025-08-16 Added probe calibration app, will expand on it later
2025-08-20 Fully async serial passthrough, fixed some net highlughting stuff to show I2C, PWM, UART, stopped readGPIOwithFloating() from fucking with (some) stuff, probe switch sensing now calibrates on startup.
    [Apps.cpp, ArduinoStuff.h, AsyncPassthrough.cpp, AsyncPassthrough.h, CH446Q.cpp, Commands.cpp, Debugs.cpp, FileParsing.cpp]
2025-08-22 Freed up a ton of RAM from unused garbage, added JDI MIP display demo app, fixed async serial to wait for data on serial1, WIP trying to get EKilo to be more responsive
    [Apps.cpp, Apps.h, ArduinoStuff.cpp, AsyncPassthrough.cpp, AsyncPassthrough.h, EkiloEditor.cpp, FileParsing.cpp, Images.h]
2025-08-23 Fixed uart desync after long periods of not getting data by switchng to pico-sdk calls and keeping a ring buffer that's handled with interrupts
    [ArduinoStuff.cpp, AsyncPassthrough.cpp, AsyncPassthrough.h, EkiloEditor.cpp, Peripherals.cpp, main.cpp]
2025-08-26 Added 3D printed stands
    [JumperlessStand.3mf, JumperlessStand.step, JumperlessStand.stl]
2025-08-26 Added the stand with the probe holder
    [standwithprobeholder.3mf, standwithprobeholder.stl]
2025-08-26 fixed the orientation on the probe holder ones
    [standWithProbeHolder.step, standwithprobeholder.3mf, standwithprobeholder.stl]
2025-08-28 Fix case sensitivity issues for Linux
    [JumperlessMicroPythonAPI.cpp]
2025-08-29 Revert a change that was breaking the eKilo editor
    [EkiloEditor.cpp, main.cpp]
2025-08-30 Fixed removed function, removed dead MachineCode
    [Apps.cpp, main.cpp]
2025-09-02 I think I fixed the issue with it not showing all the time with out an enter key.
    [Tui.h]
2025-09-02 Added machine module (so far just pins and uart), fixed some weirdness with switching between file manager, repl, and ekilo, added uart examples, used some extra ram for the micropython heap and stac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
    [Apps.cpp, Apps.h, AsyncPassthrough.cpp, AsyncPassthrough.h, Commands.cpp, EkiloEditor.cpp, FilesystemStuff.cpp, FilesystemStuff.h]
2025-09-06 Twiddled probe timing stuff
2025-09-06 Broke out PopUp, more code cleanup
    [Tui.h, TuiGlue.cpp, TuiGlue.h, TuiPopup.cpp, TuiPopup.h]
2025-09-08 Added onboard terminal control and broke out syntax highlighing
    [FileParsing.cpp, FileParsing.h, Graphics.cpp, Probing.cpp, Python_Proper.cpp, Python_Proper.h, SyntaxHighlighting.cpp, SyntaxHighlighting.h]
2025-10-07 Added optional line buffering (defaults to off), hysteresis on the probe switch position sensing, added a font,
2025-10-31 Add related repos as submodules, rev7 hardware update
    [Breadboard V5 v21.stl, JumperlessV5r6.kicad_sch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]
2025-11-14 update JumperlOS submodule
    [V5LEDboard.kicad_sch]
2025-12-16 update submodules
    [FPCbreakout2.kicad_pcb, FPCbreakout2.kicad_sch]
2026-01-31 Add PSRAM mod board
    [PSRAMmod.kicad_sch]
2026-01-31 Add PSRAM mod files
    [PSRAMmod.kicad_sch]
2026-06-02 add random stuff
    [JustTheLEDs.kicad_sch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]
2026-09-10 mostly screw with releases and actions
    [Jumperless23V50.kicad_sch, JumperlessV5r7.kicad_sch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]
